Blosslom1/FDM_i3_3Dprinter/模型/主板盒/主板盒/README.txt

                   .:                     :,                                          
,:::::::: ::`      :::                   :::                                          
,:::::::: ::`      :::                   :::                                          
.,,:::,,, ::`.:,   ... .. .:,     .:. ..`... ..`   ..   .:,    .. ::  .::,     .:,`   
   ,::    :::::::  ::, :::::::  `:::::::.,:: :::  ::: .::::::  ::::: ::::::  .::::::  
   ,::    :::::::: ::, :::::::: ::::::::.,:: :::  ::: :::,:::, ::::: ::::::, :::::::: 
   ,::    :::  ::: ::, :::  :::`::.  :::.,::  ::,`::`:::   ::: :::  `::,`   :::   ::: 
   ,::    ::.  ::: ::, ::`  :::.::    ::.,::  :::::: ::::::::: ::`   :::::: ::::::::: 
   ,::    ::.  ::: ::, ::`  :::.::    ::.,::  .::::: ::::::::: ::`    ::::::::::::::: 
   ,::    ::.  ::: ::, ::`  ::: ::: `:::.,::   ::::  :::`  ,,, ::`  .::  :::.::.  ,,, 
   ,::    ::.  ::: ::, ::`  ::: ::::::::.,::   ::::   :::::::` ::`   ::::::: :::::::. 
   ,::    ::.  ::: ::, ::`  :::  :::::::`,::    ::.    :::::`  ::`   ::::::   :::::.  
                                ::,  ,::                               ``             
                                ::::::::                                              
                                 ::::::                                               
                                  `,,`

http://www.thingiverse.com/thing:761806
Dasaki Ramps 1.4 Enclosure / Box / Case by dasaki is licensed under the GNU - GPL license.
http://creativecommons.org/licenses/GPL/2.0/

# Summary

Compact enclosure for Ramps 1.4, with space for one or two 50mm fans, LCD connectors and hinged cover for easy access.  

After two years of having my Prusa electronics unboxed and untidy, I finally decided to design my own enclosure.  

Version v2: reinforced and increased space of cable holders.

22 nov 2016: added dasaki_ramps_enclosure_cover_v2_dual_40mm_fan.stl

If you are a curious maker / "tinker" / hacker, have a look at my blog:
www.therandomlab.com

Licensed under The TAPR Open Hardware License

# Instructions

Cut the hole/s for the fan/s after printing. Fans should blow outwards (extract the air from the enclosure).
There are holes for M3 nuts and bolts in two of the case sides, to fix it to the printer/device chassis.

Printing hints:  

To be printed in the position as in the source files (also shown in one of the pictures).  

0.3mm layer height  
0.6mm top/bottom thickness  
1.0mm shell thickness  
25% fill density
