Blosslom1/FDM_i3_3Dprinter/软件部分/3D Touch调平传感器使用说明书.pdf

### 3D Touch 调平培训

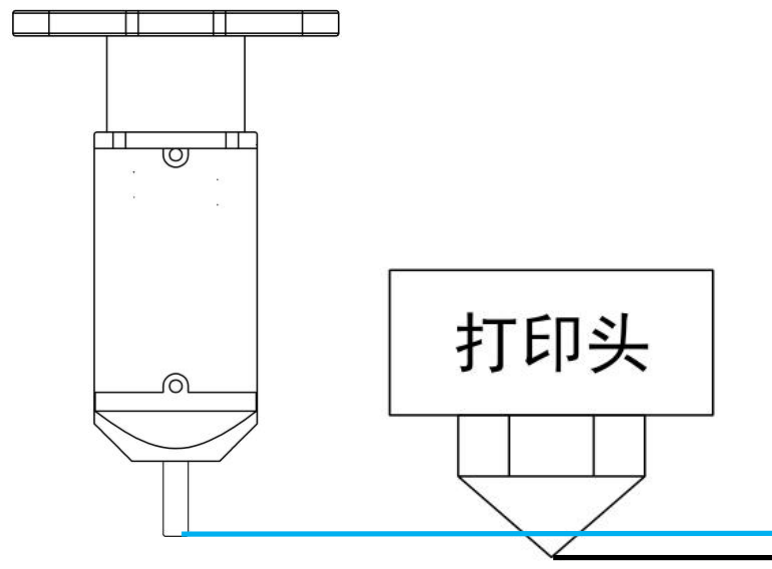
[picture p27: figure]
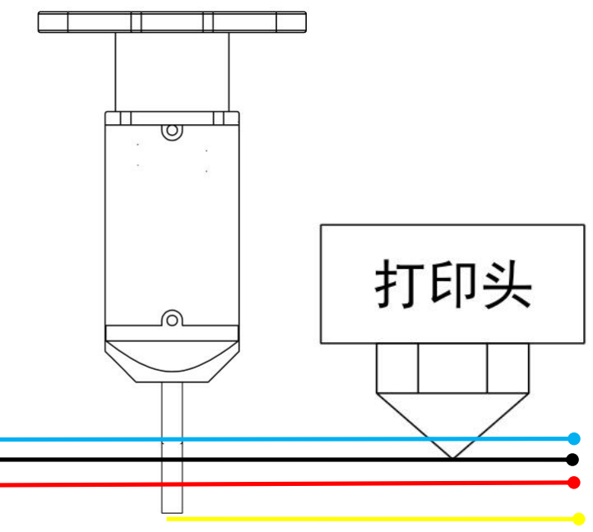
[picture p28: figure]

一.装机

缩针的时候 | 弹针的时候

代表 3d touch 缩针时，探针底部所处的位置，一定要比喷嘴要高。否则打印模型时，探针会碰到模

型，造成损坏。

代表喷嘴所处的位置

代表 3d touch 的触发点，这个触发点一定要比喷嘴要低，否则触发不了 3D touch，就已经被喷嘴顶

住了，这个可以微调调到适合的位置

代表 3d touch 弹针时，弹针底部所处的位置

黑线和红色之间的距离代表 Z offset 的值

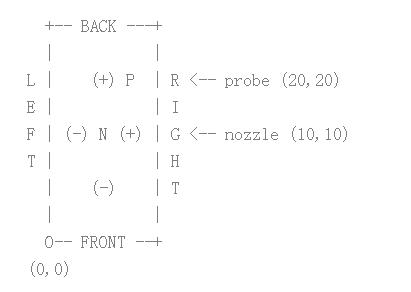
[picture p29: figure]
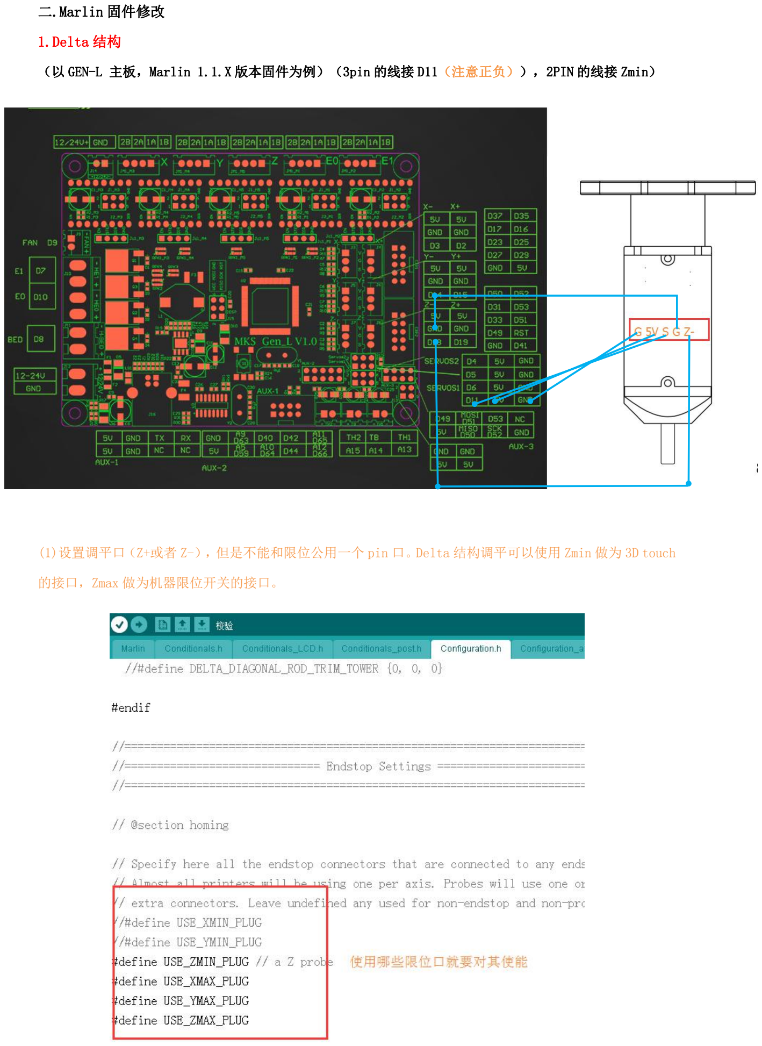
[picture p30: page 2]

二.Marlin 固件修改

1.Delta 结构

（以 GEN-L 主板，Marlin 1.1.X 版本固件为例）（3pin 的线接 D11（注意正负）），2PIN 的线接 Zmin）

(1)设置调平口（Z+或者 Z-），但是不能和限位公用一个 pin 口。Delta 结构调平可以使用 Zmin 做为 3D touch

的接口，Zmax 做为机器限位开关的接口。

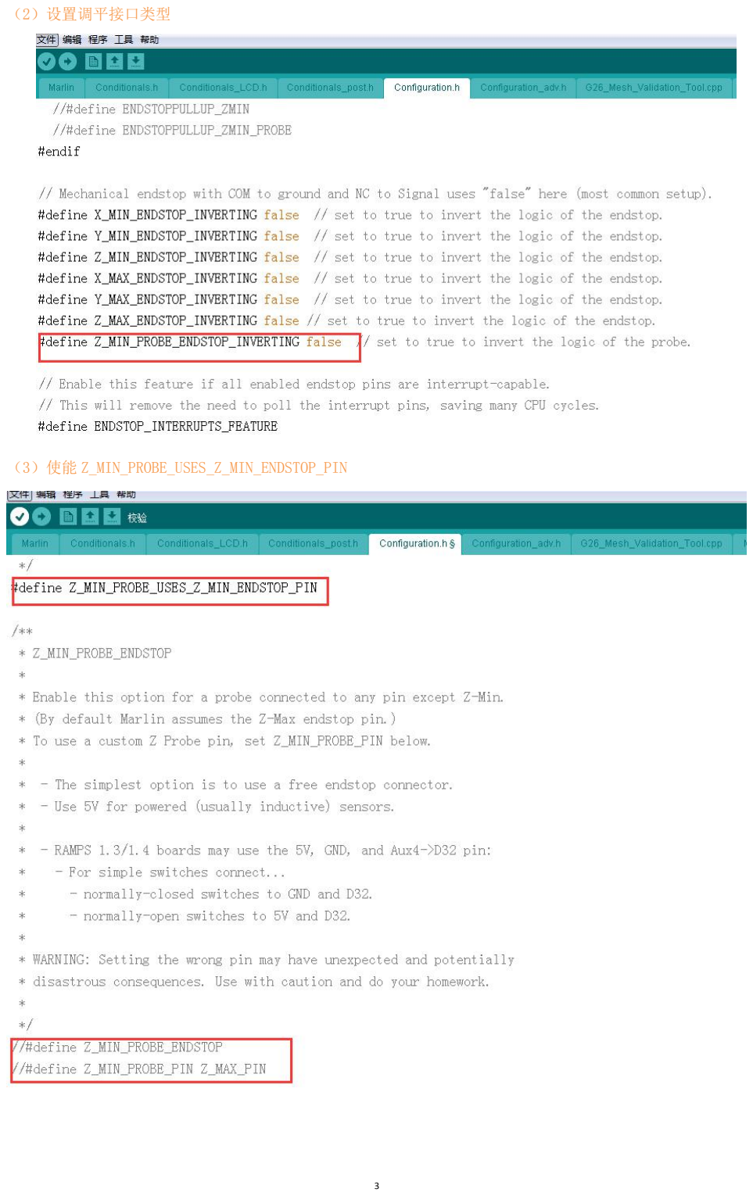
[picture p31: page 3]

（2）设置调平接口类型

（3）使能 Z_MIN_PROBE_USES_Z_MIN_ENDSTOP_PIN

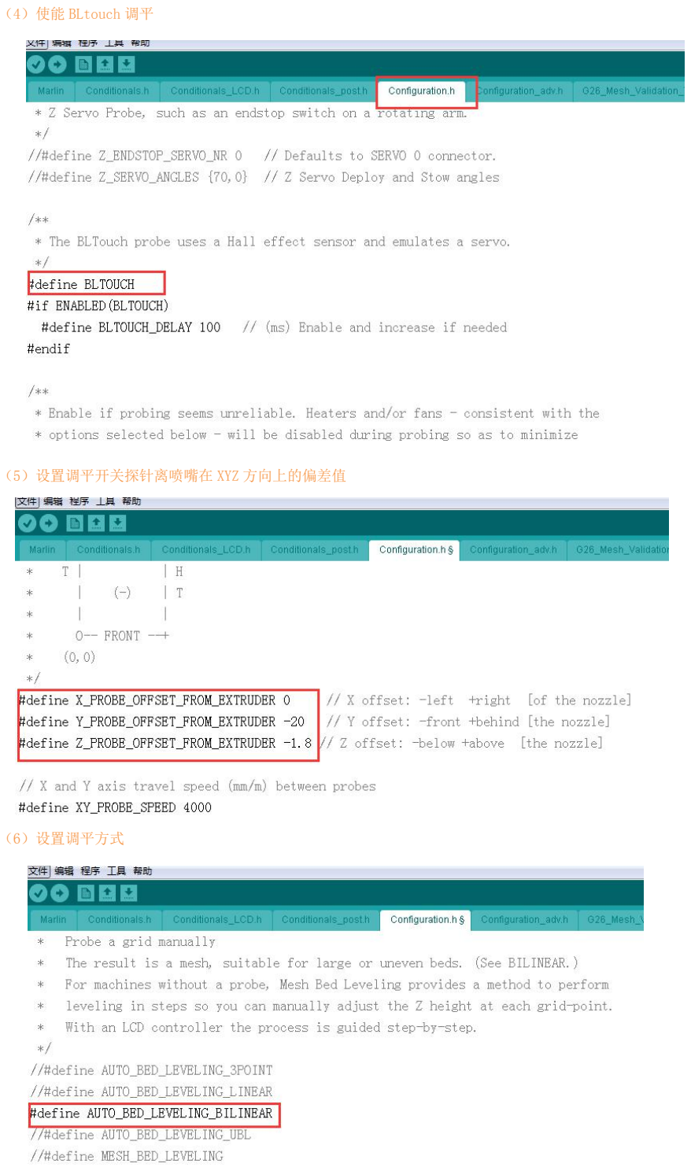
[picture p32: page 4]

（4）使能 BLtouch 调平

（5）设置调平开关探针离喷嘴在 XYZ 方向上的偏差值

（6）设置调平方式

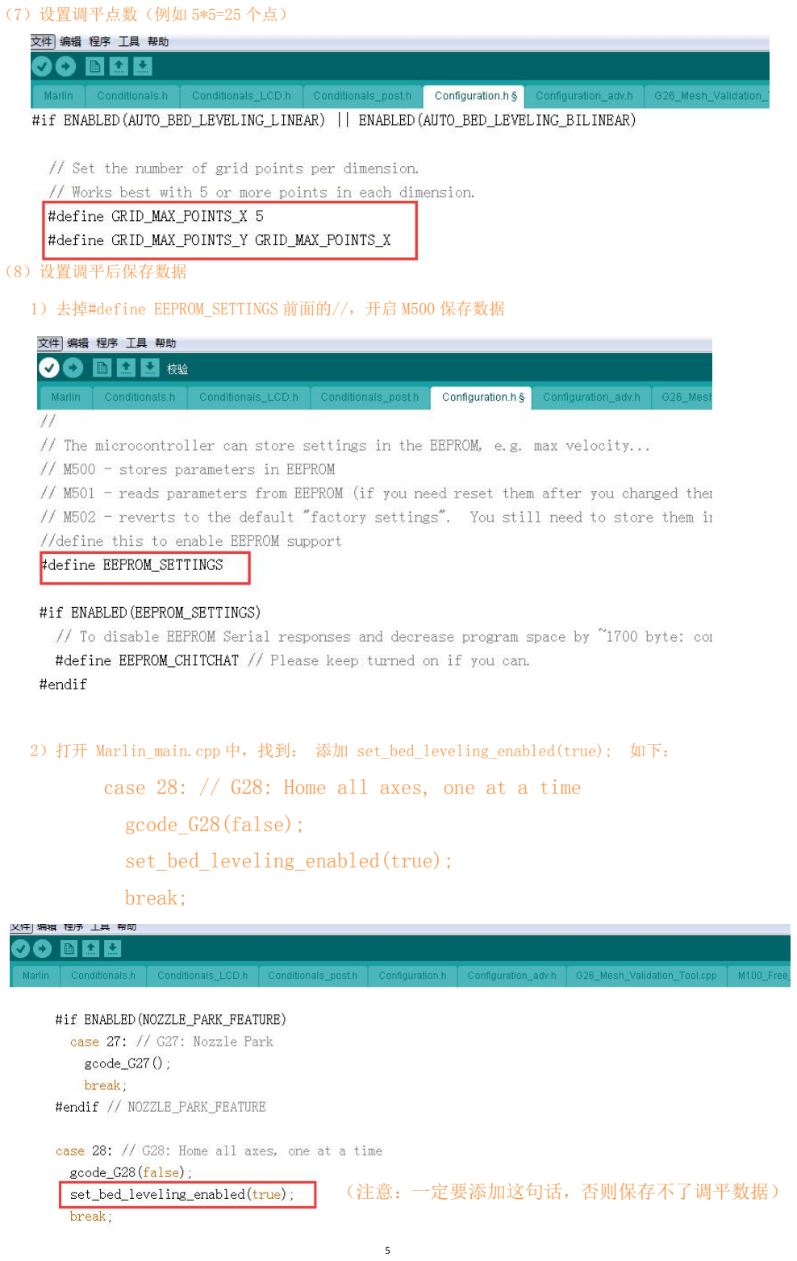
[picture p33: page 5]

（7）设置调平点数（例如 5*5=25 个点）

（8）设置调平后保存数据

1）去掉#define EEPROM_SETTINGS 前面的//，开启 M500 保存数据

2）打开 Marlin_main.cpp 中，找到： 添加 set_bed_leveling_enabled(true); 如下：

### case 28: // G28: Home all axes, one at a time

gcode_G28(false);
set_bed_leveling_enabled(true);
break;

（注意：一定要添加这句话，否则保存不了调平数据）

（9）去掉#define NUM_SERVOS 3 前面的//

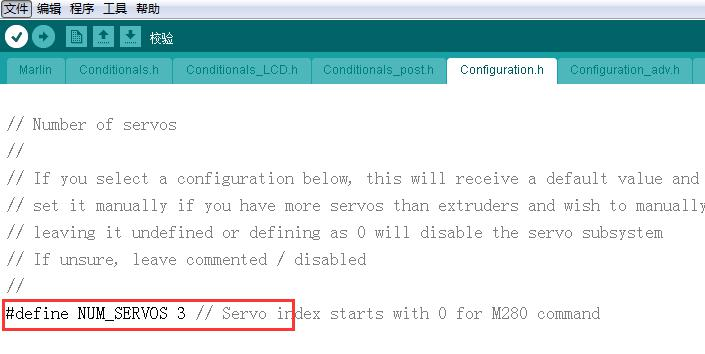
[picture p34: figure]
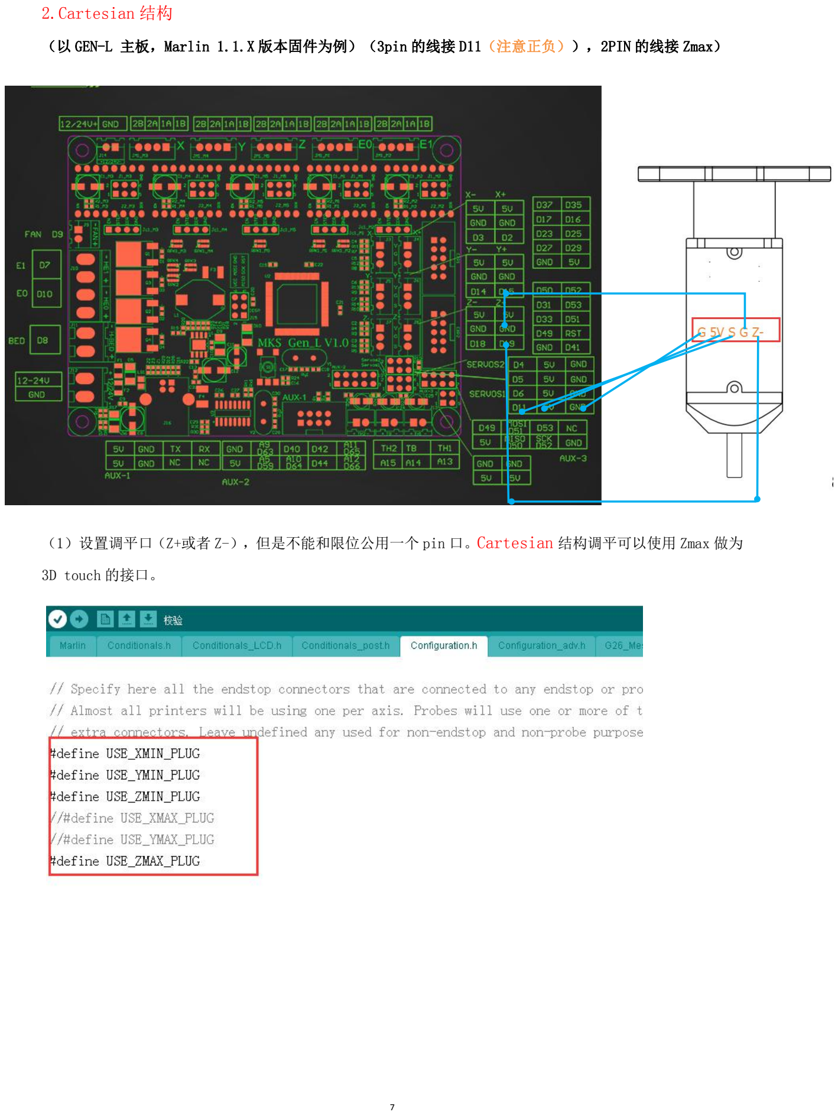
[picture p35: page 7]

2.Cartesian 结构

（以 GEN-L 主板，Marlin 1.1.X 版本固件为例）（3pin 的线接 D11（注意正负）），2PIN 的线接 Zmax）

（1）设置调平口（Z+或者 Z-），但是不能和限位公用一个 pin 口。Cartesian 结构调平可以使用 Zmax 做为

3D touch 的接口。

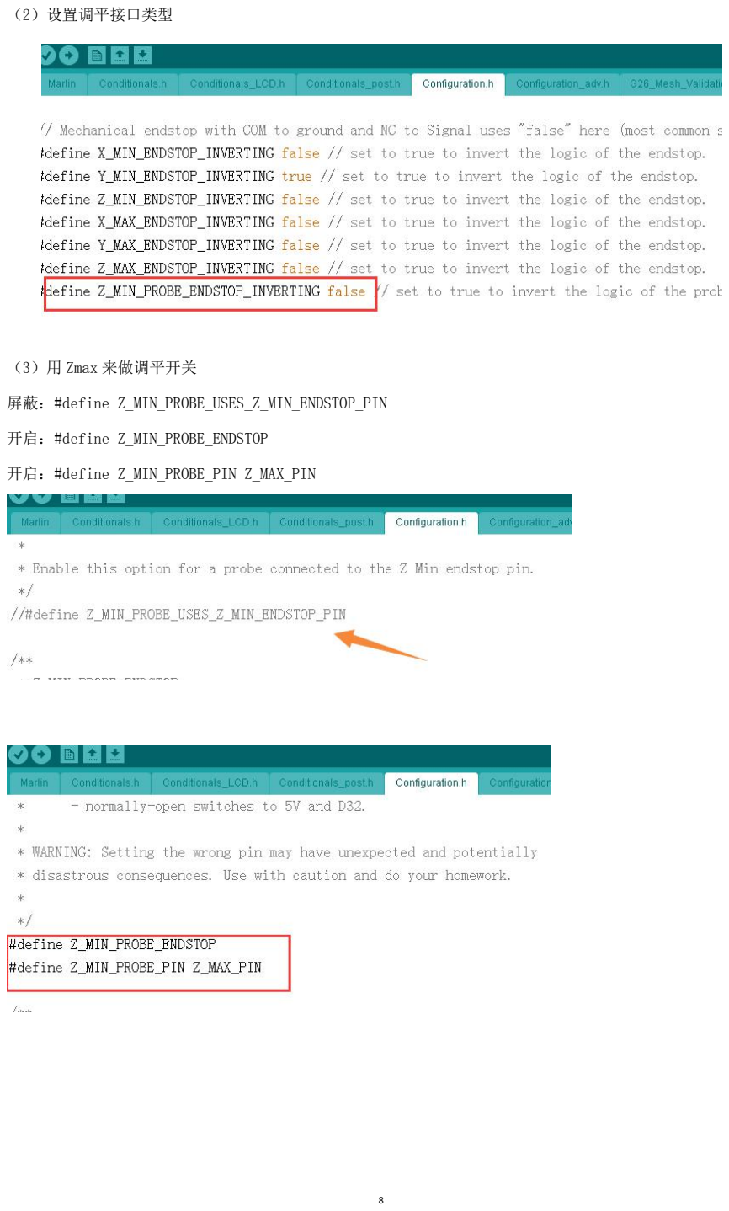
[picture p36: page 8]

（2）设置调平接口类型

（3）用 Zmax 来做调平开关

屏蔽：#define Z_MIN_PROBE_USES_Z_MIN_ENDSTOP_PIN

开启：#define Z_MIN_PROBE_ENDSTOP

开启：#define Z_MIN_PROBE_PIN Z_MAX_PIN

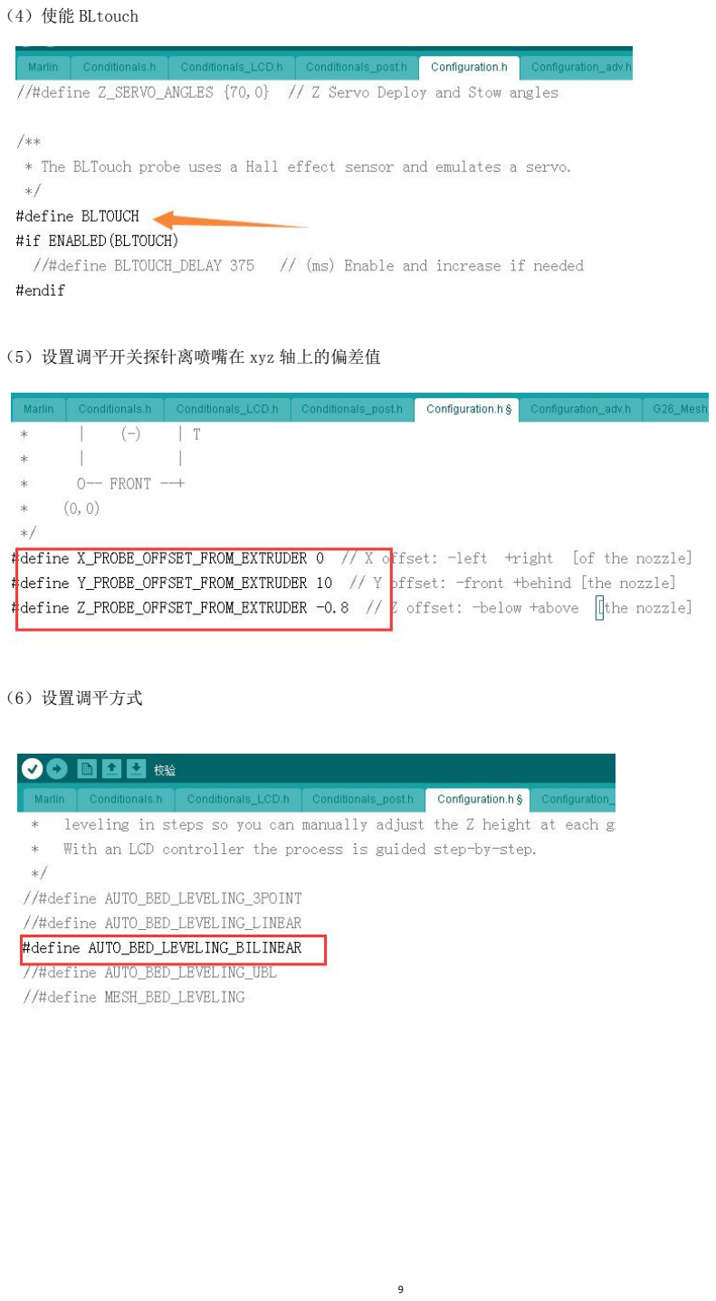
[picture p37: page 9]

（4）使能 BLtouch

（5）设置调平开关探针离喷嘴在 xyz 轴上的偏差值

（6）设置调平方式

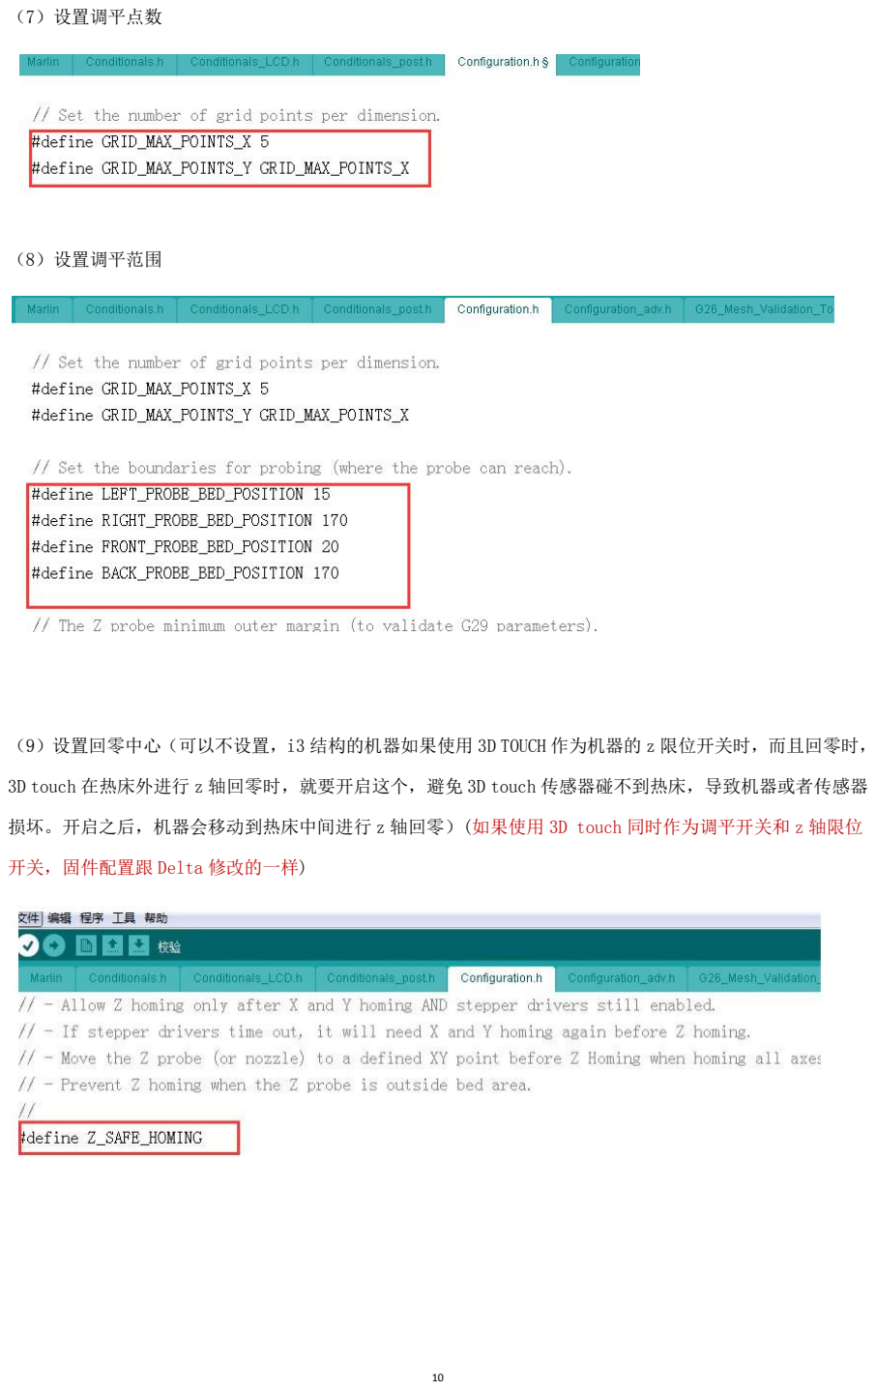
[picture p38: page 10]

（7）设置调平点数

（8）设置调平范围

（9）设置回零中心（可以不设置，i3 结构的机器如果使用 3D TOUCH 作为机器的 z 限位开关时，而且回零时，

3D touch 在热床外进行 z 轴回零时，就要开启这个，避免 3D touch 传感器碰不到热床，导致机器或者传感器

损坏。开启之后，机器会移动到热床中间进行 z 轴回零）(如果使用 3D touch 同时作为调平开关和 z 轴限位

开关，固件配置跟 Delta 修改的一样)

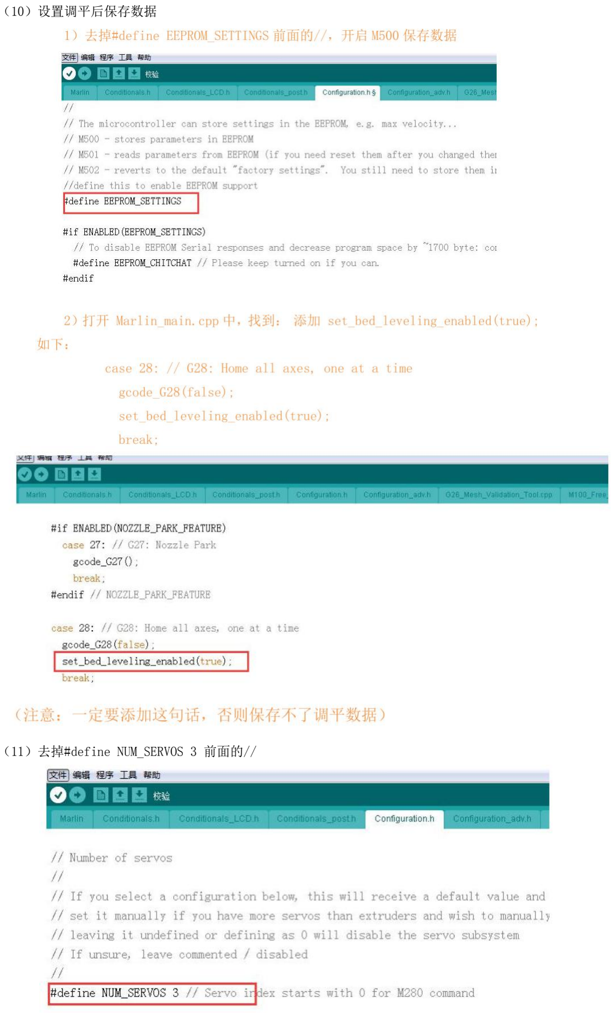
[picture p39: page 11]

（10）设置调平后保存数据

（11）去掉#define NUM_SERVOS 3 前面的//

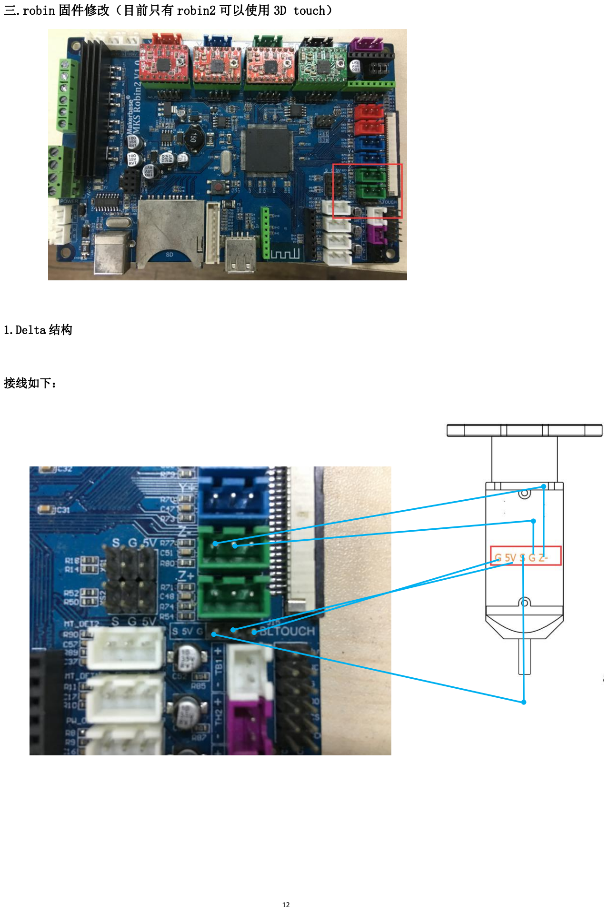
[picture p40: page 12]

三.robin 固件修改（目前只有 robin2 可以使用 3D touch）

1.Delta 结构

接线如下：

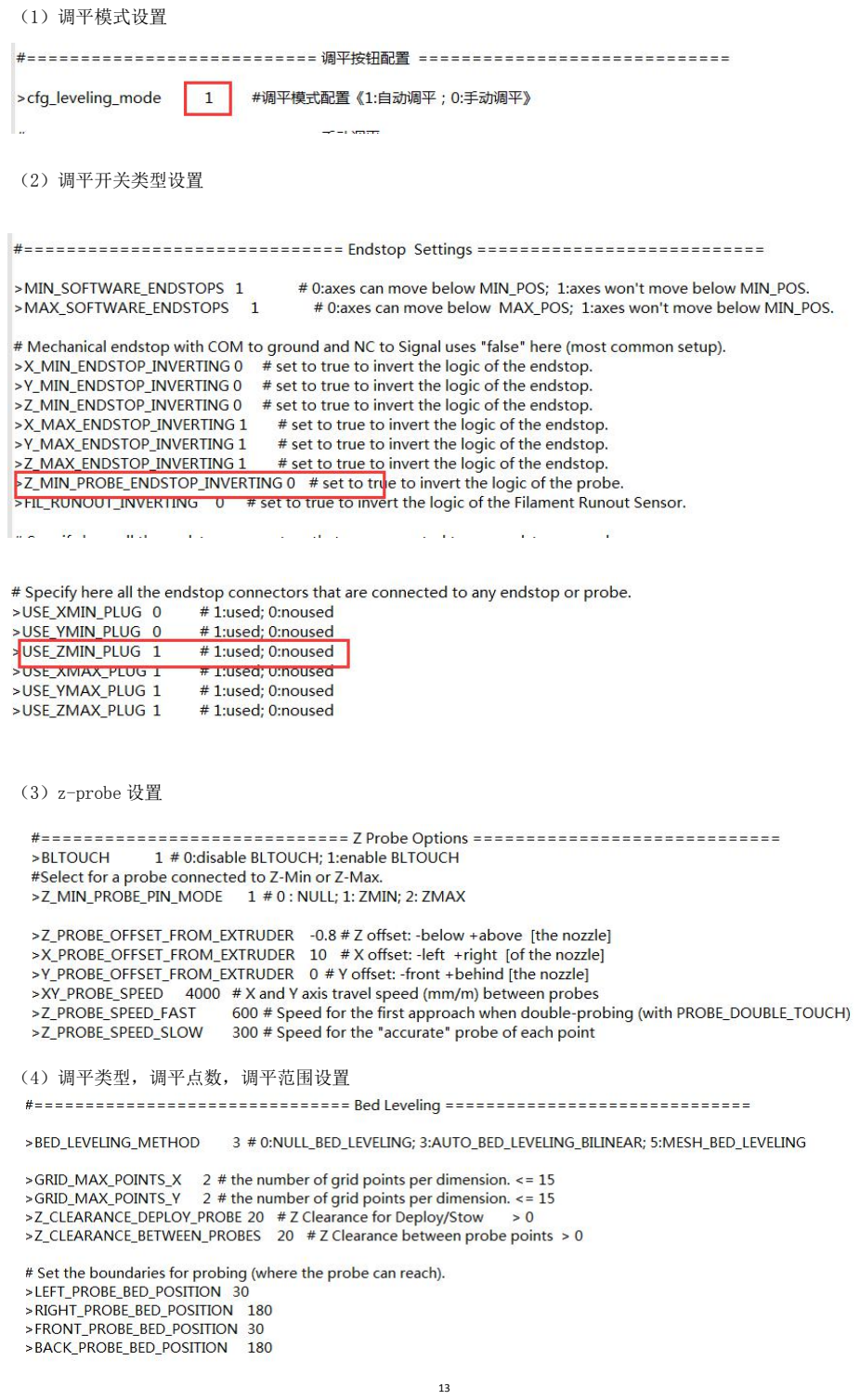
[picture p41: page 13]

（1）调平模式设置

（2）调平开关类型设置

（3）z-probe 设置

（4）调平类型，调平点数，调平范围设置

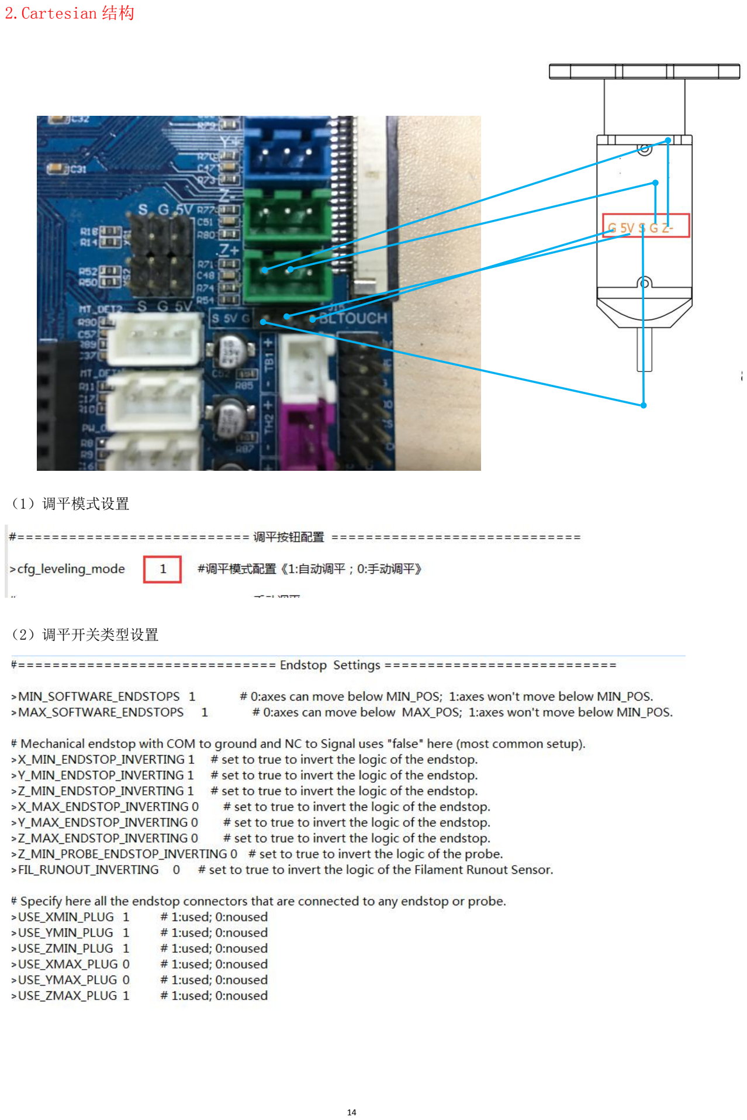
[picture p42: page 14]

2.Cartesian 结构

（1）调平模式设置

（2）调平开关类型设置

（5）z-probe 设置

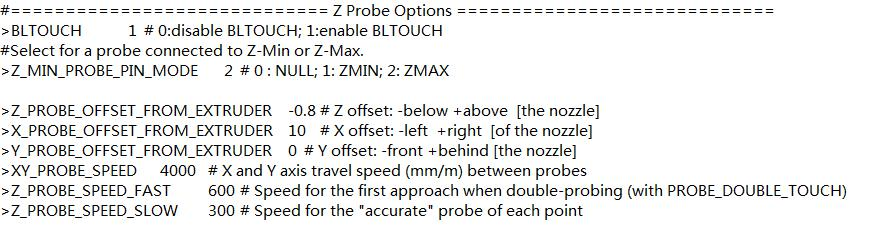
[picture p43: figure]

（6）调平类型，调平点数，调平范围设置

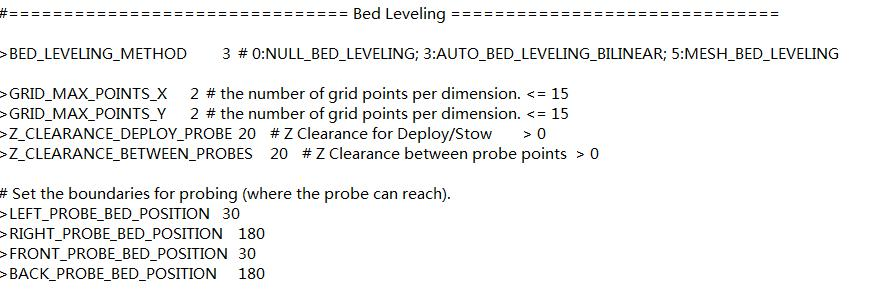
[picture p44: figure]
