Blosslom1/FDM_i3_3Dprinter/方案一/3D打印机项目.md

# 3D打印机项目

## 打印机类型

熔融沉积型打印机（FDM）

## 设计建模

建模软件使用的是solid works 2018，用二维图形生成三维图形。

### 支架型材

#### x轴铝型材

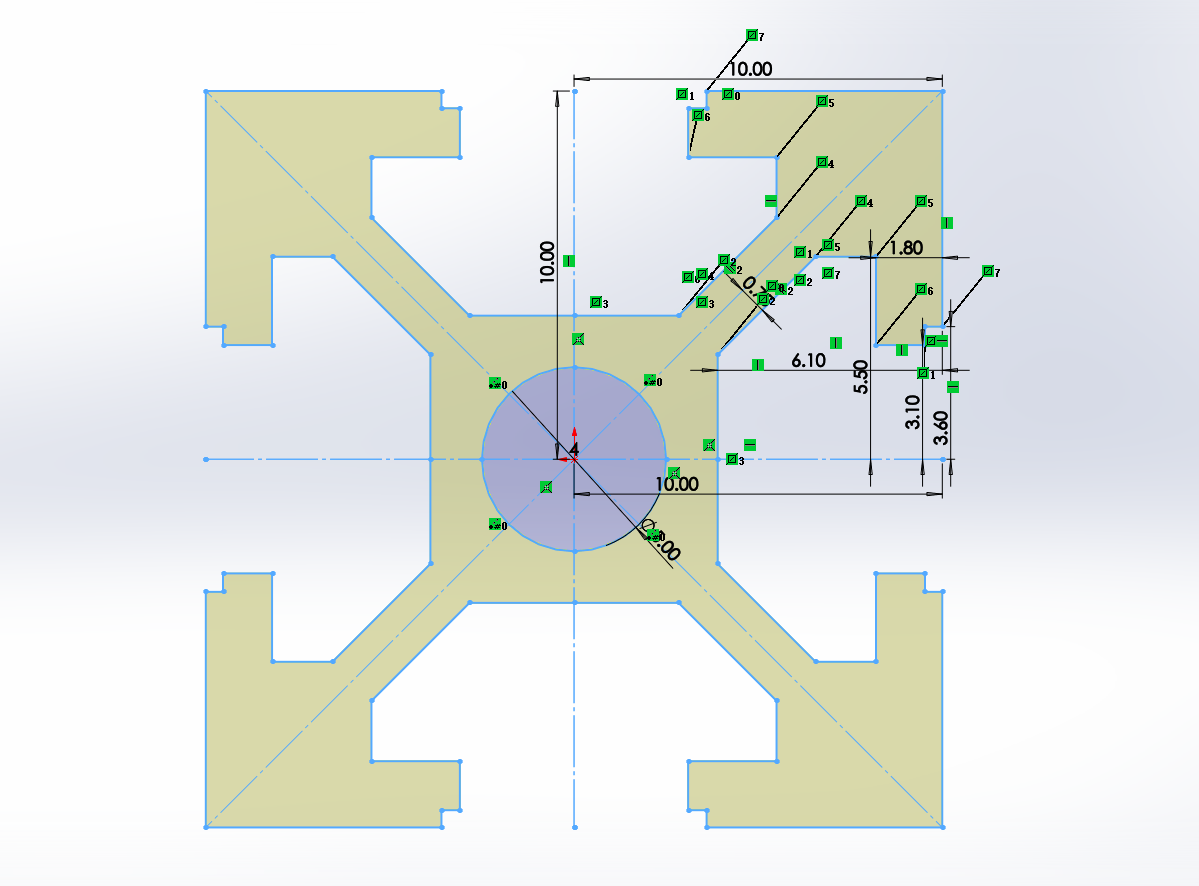
[picture p45: 方案一/图片/X型材.png]


规格如图（规格全部参考模型源文件，项目地址），使用拉伸凸台生成立体零件，拉伸长度是245mm

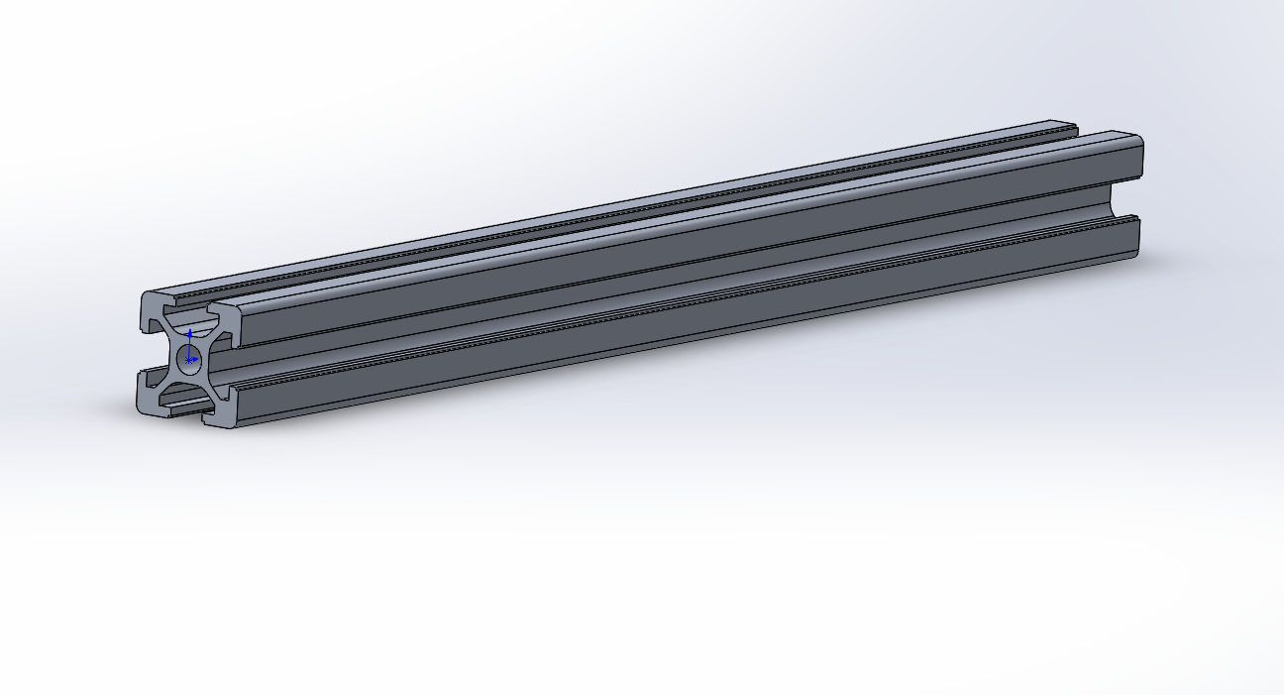
[picture p46: 方案一/图片/X型材245.png]


#### y轴铝型材

同x轴型材，拉伸长度是385mm

#### z轴铝型材

同x轴型材，拉伸长度是310mm

#### x光轴

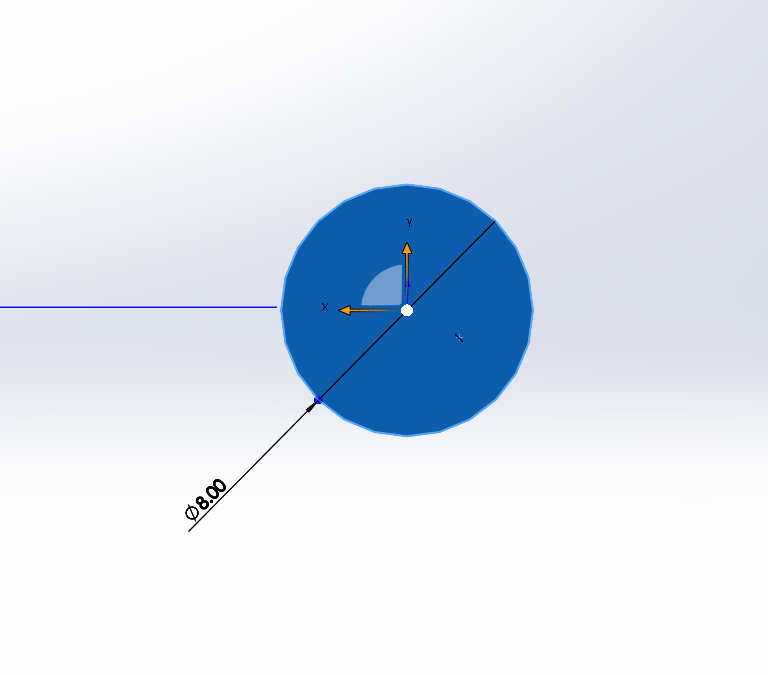
[picture p47: 方案一/图片/X光轴.png]


规格如图，使用拉伸凸台生成立体零件，拉伸长度是320mm

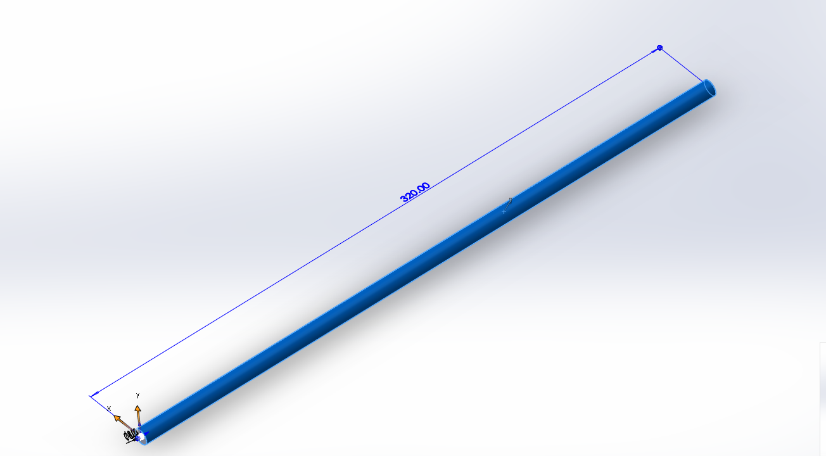
[picture p48: 方案一/图片/X光轴320.png]


#### y光轴

同x光轴，拉伸长度是380mm

#### z光轴

同x光轴，拉伸长度是345mm

#### z丝杆

长度305mm

#### 热床平台

下图为热床草图，厚度是3mm

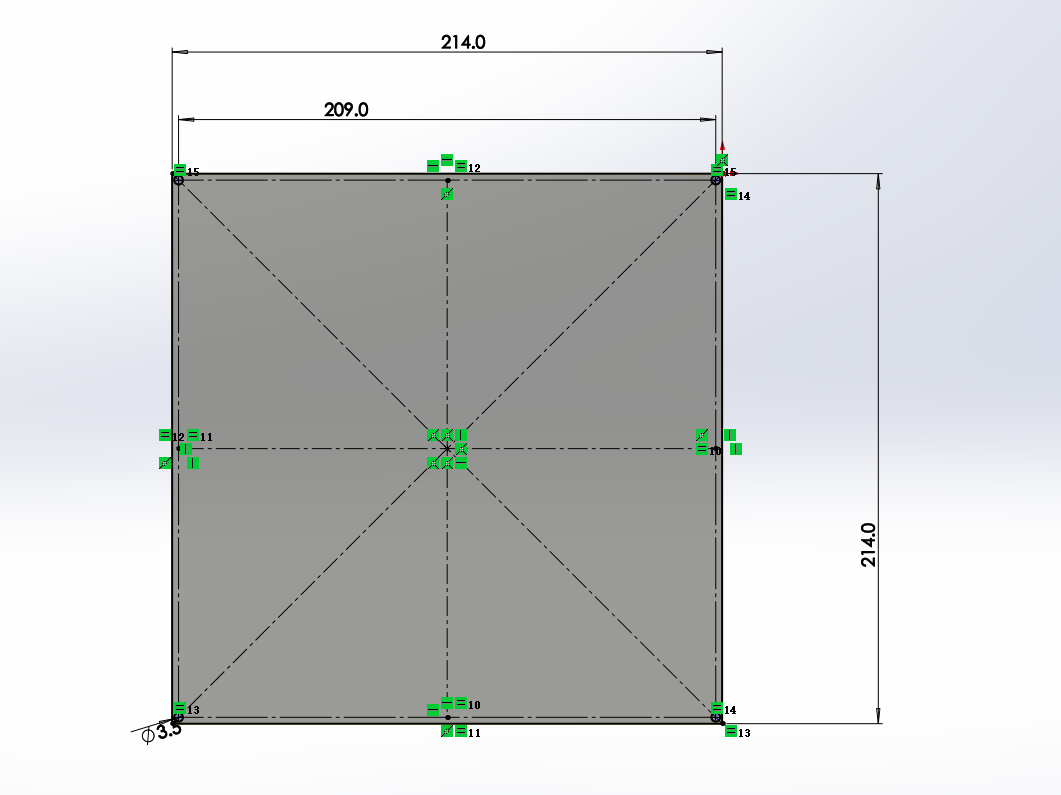
[picture p49: 方案一/图片/热床.png]


下图为热床地板草图，厚度是2.5mm

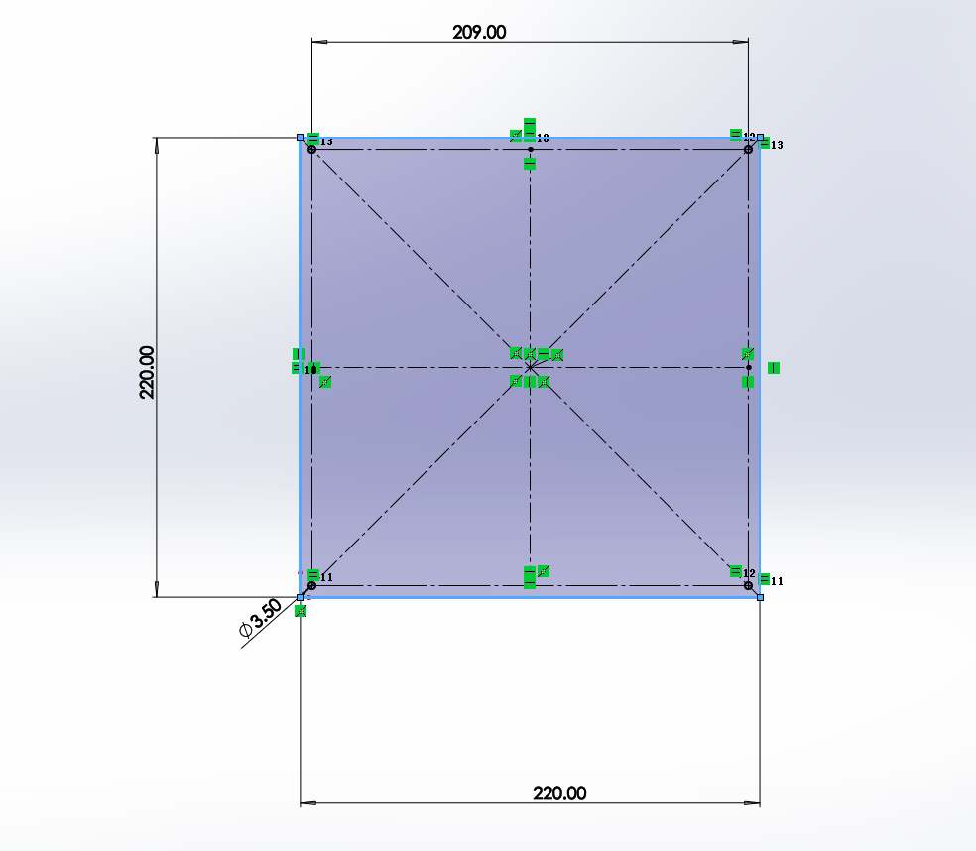
[picture p50: 方案一/图片/热床地板.png]


#### 角码

角码中间位置，L型型材，拉伸长度是20mm

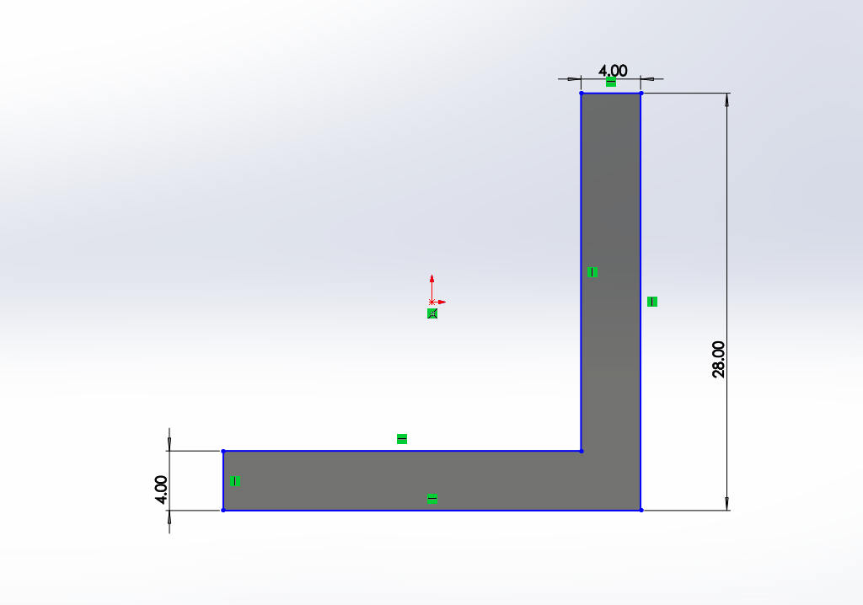
[picture p51: 方案一/图片/角码中.png]


角码侧边位置如图尺寸，两边通过镜像建立，拉伸长度是3.5mm

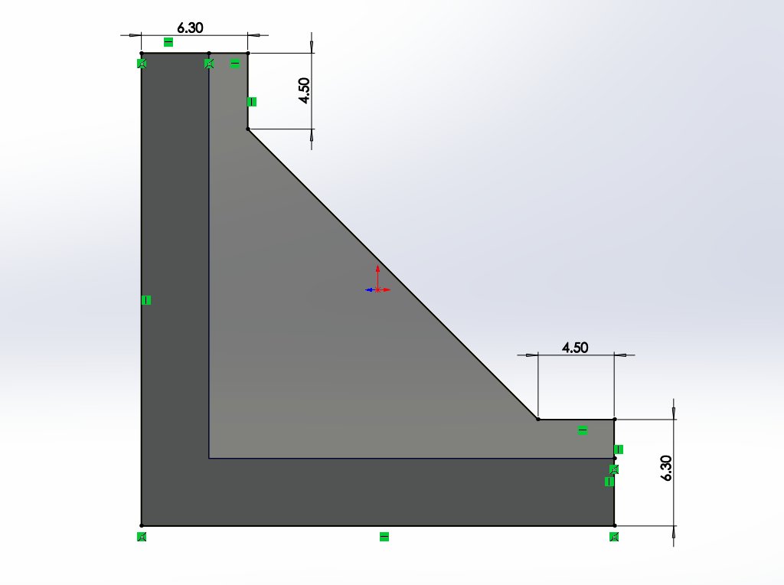
[picture p52: 方案一/图片/角码侧.png]


角码底和后面是一样的，拉伸切除，草图如下

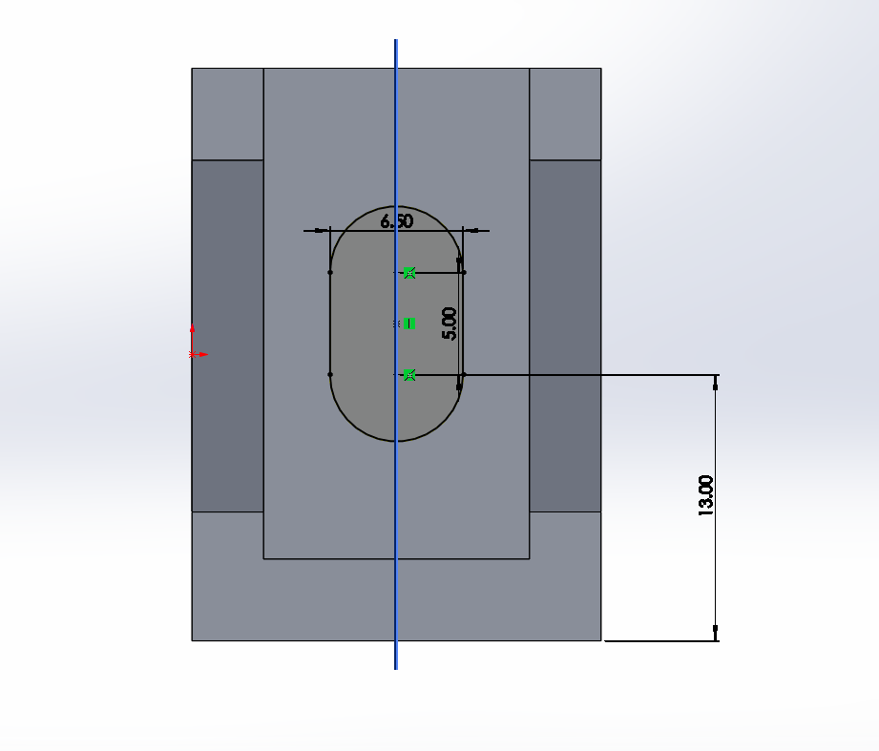
[picture p53: 方案一/图片/角码底.png]


整体图如下：

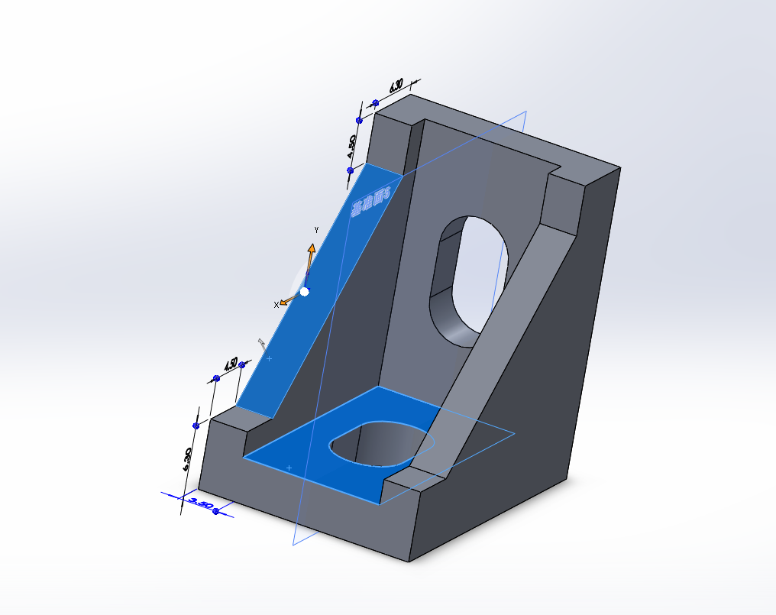
[picture p54: 方案一/图片/角码整.png]


#### 联轴器

联轴器是由一个圆柱体组成，中空，阶梯规格，草图如下，拉伸25mm

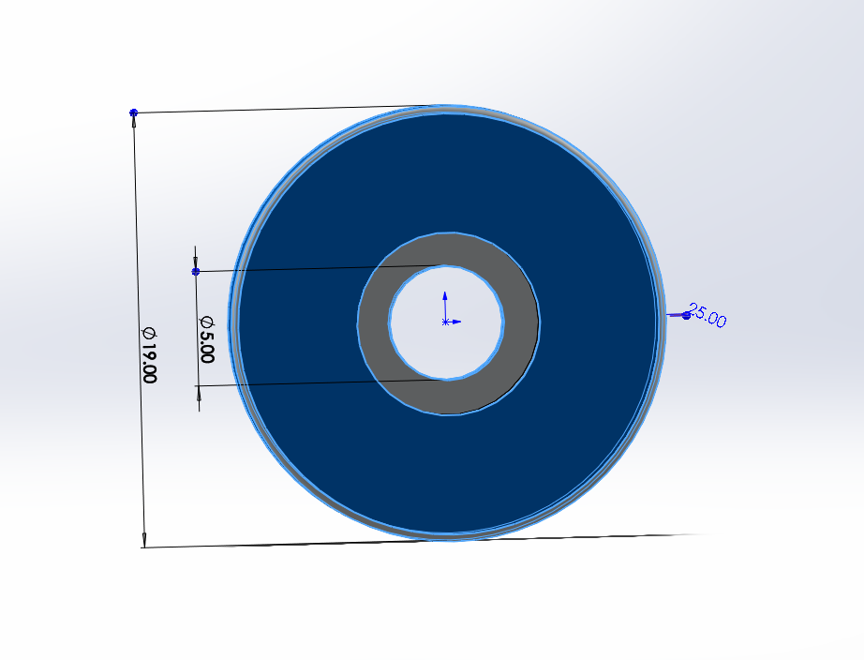
[picture p55: 方案一/图片/联轴器1.png]


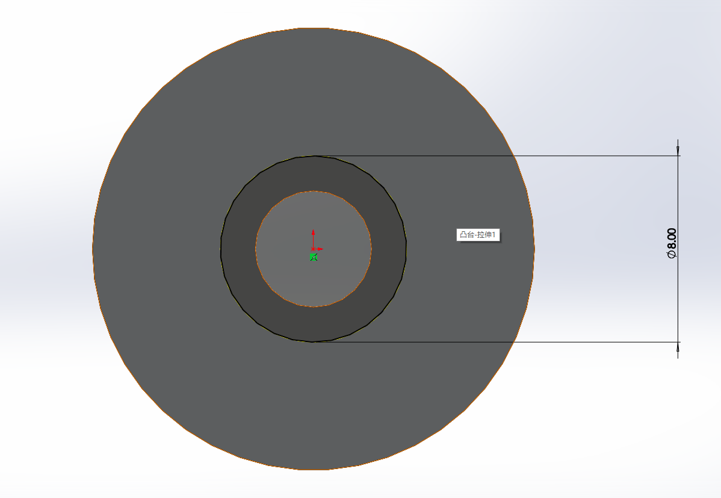
[picture p56: 方案一/图片/联轴器2.png]


整体如下图：

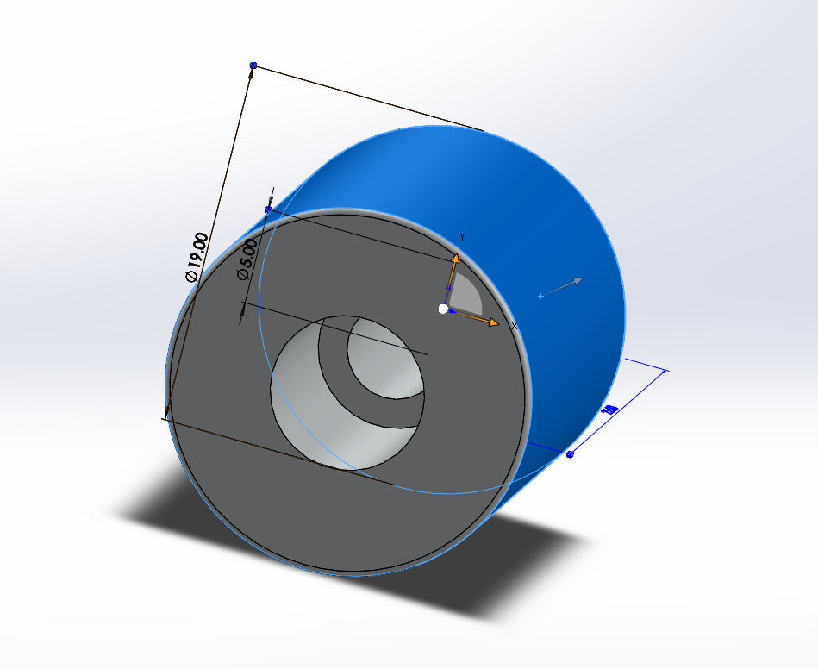
[picture p57: 方案一/图片/联轴器3.png]


#### 同步轮

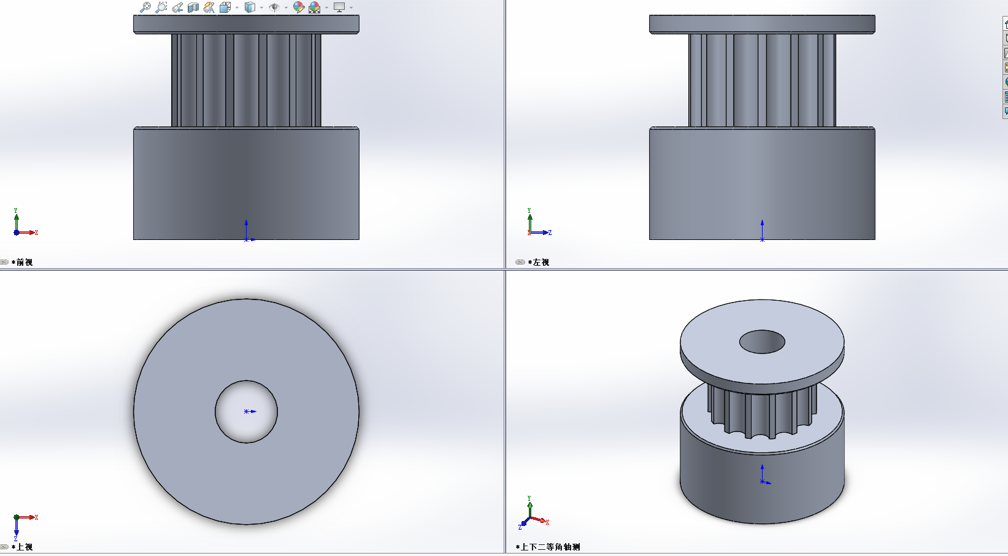
[picture p58: 方案一/图片/同步轮.png]


#### LM8UU

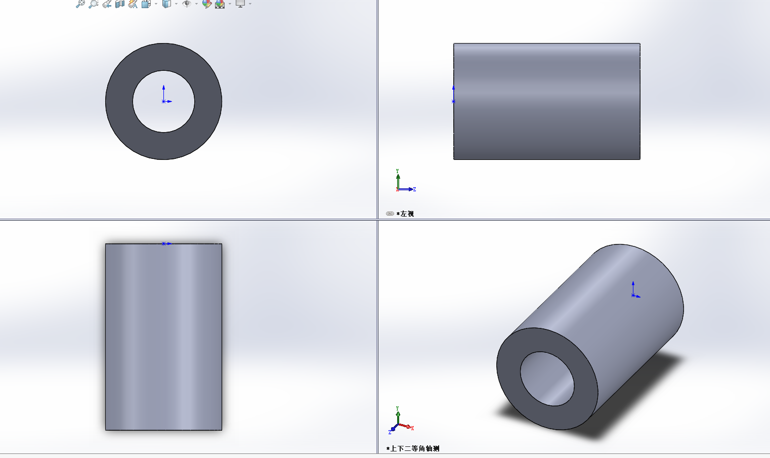
[picture p59: 方案一/图片/LM8UU.png]


#### 丝杆螺母

丝杆螺母，参考图。

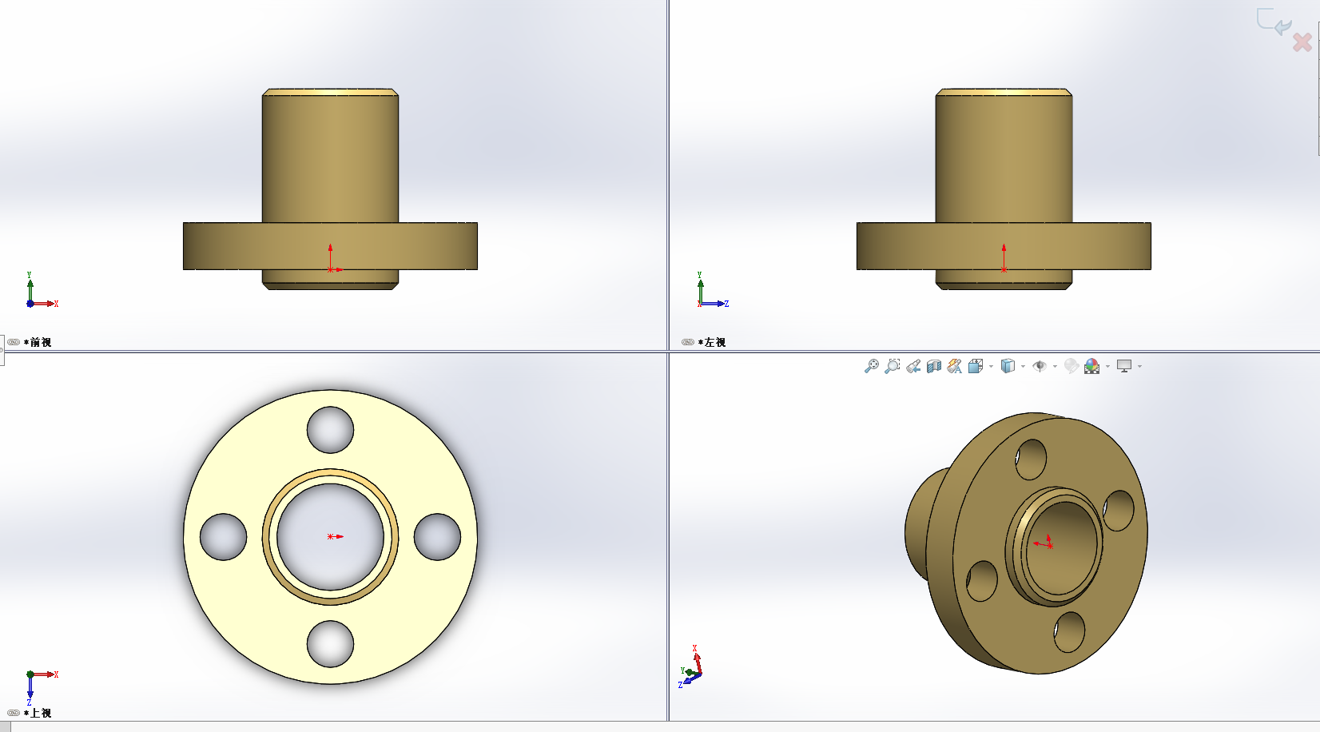
[picture p60: 方案一/图片/丝杆螺母.png]


#### 42步进电机

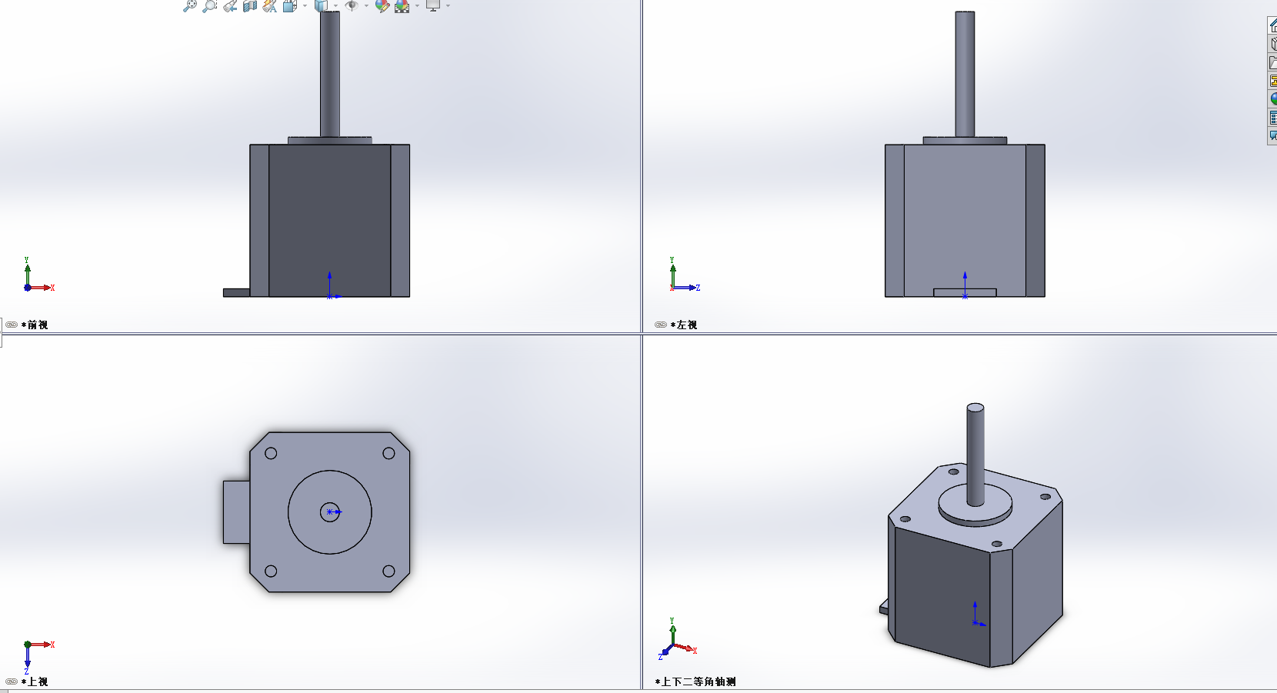
[picture p61: 方案一/图片/42步进电机.png]


#### 挤出机

下图是MK8底板。

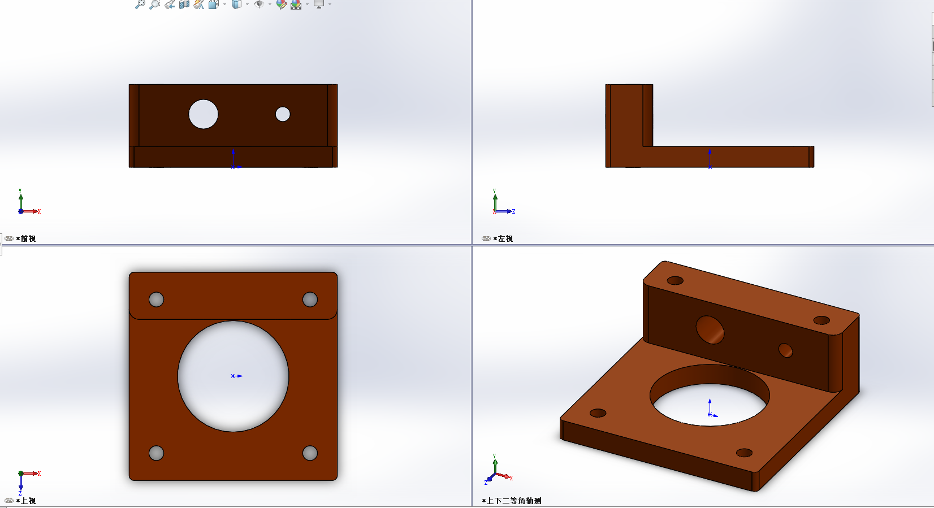
[picture p62: 方案一/图片/挤出机1.png]


下图是MK8压杆

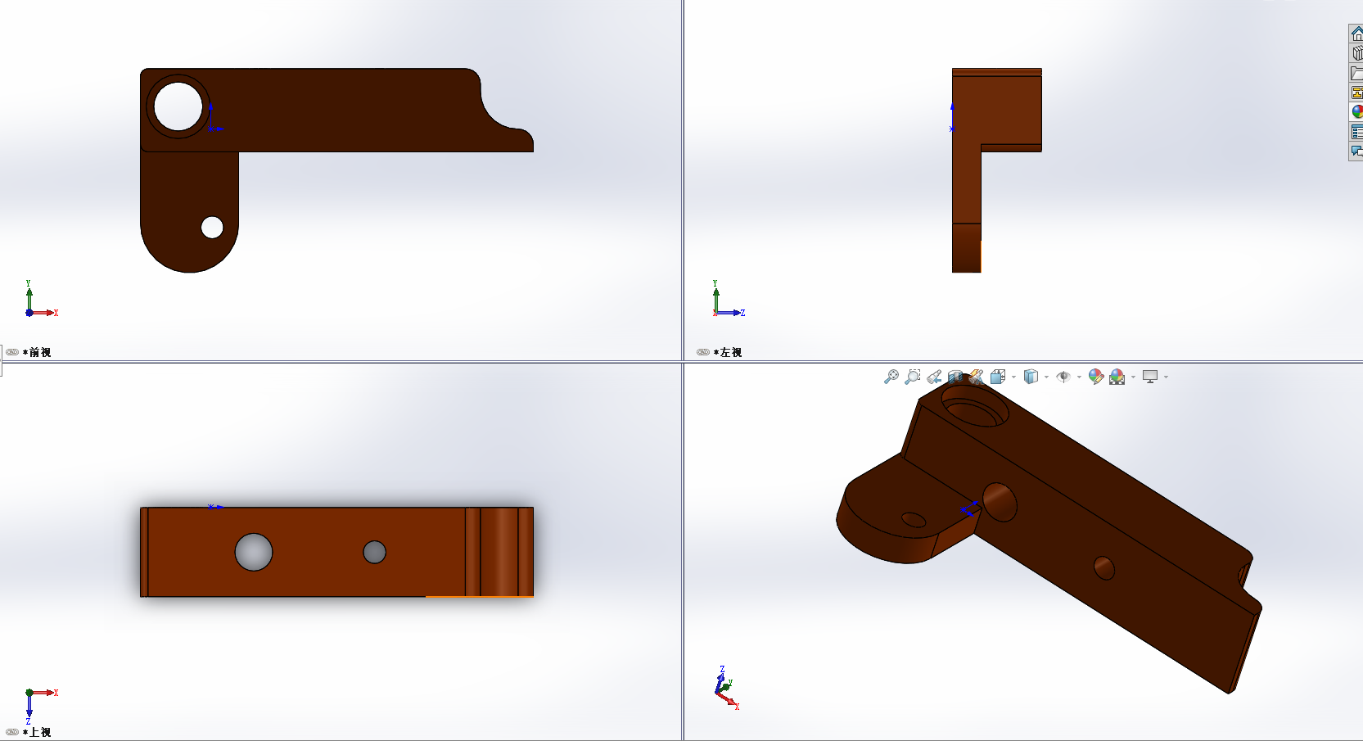
[picture p63: 方案一/图片/MK8压杆.png]


下图是MK8散热片

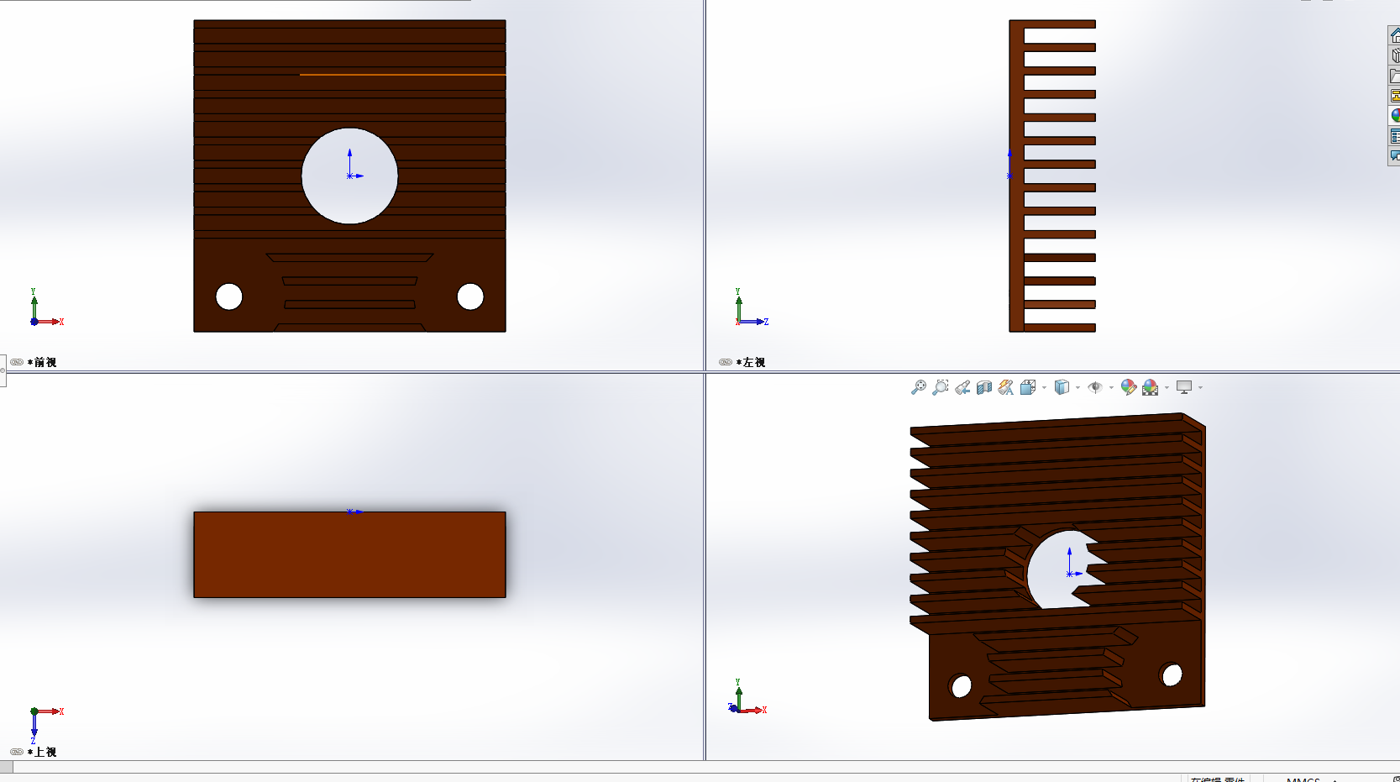
[picture p64: 方案一/图片/MK8散热片.png]


#### 喉管

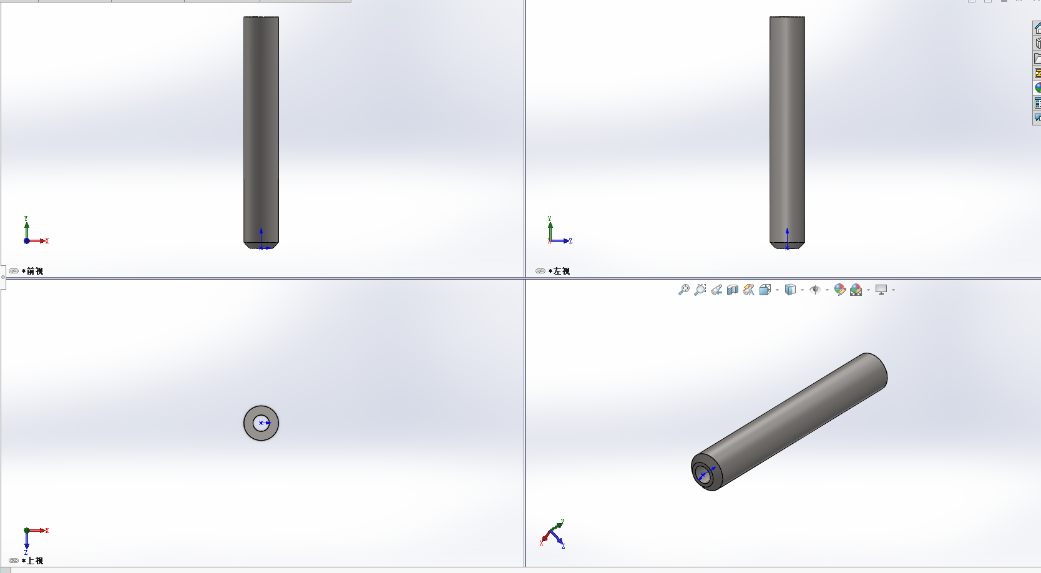
[picture p65: 方案一/图片/喉管.png]


#### 喉管散热片

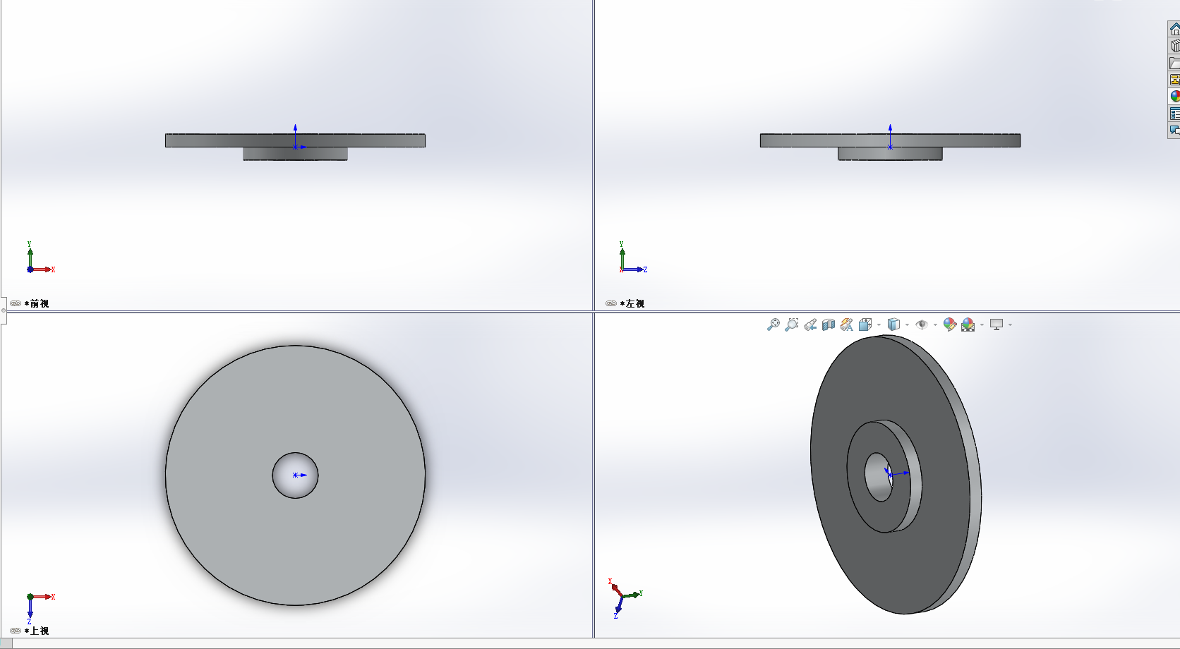
[picture p66: 方案一/图片/喉管散热片.png]


#### 固定

下图是Y光轴固定

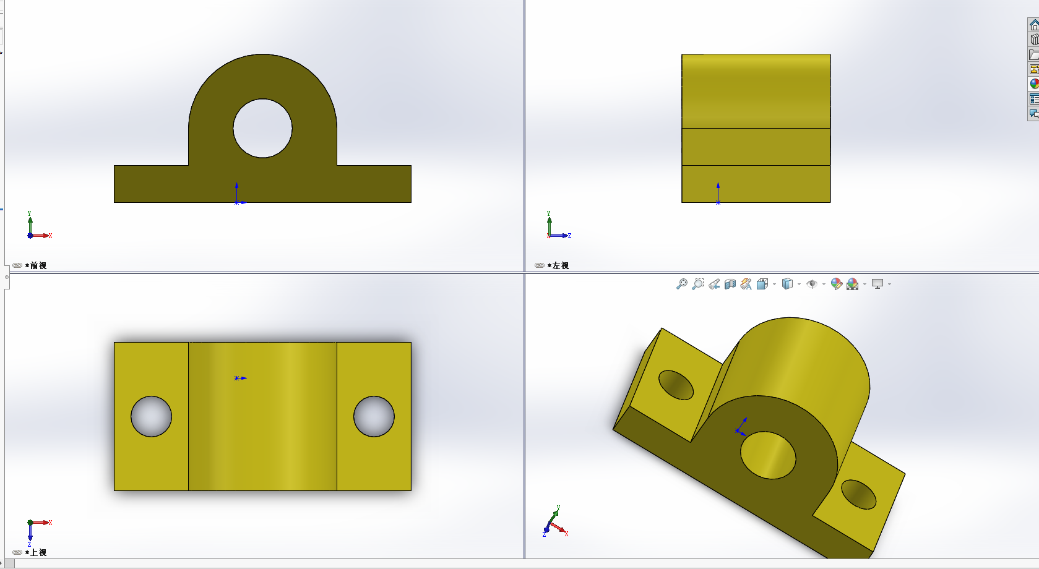
[picture p67: 方案一/图片/Y光轴固定.png]


下图是热床底板固定

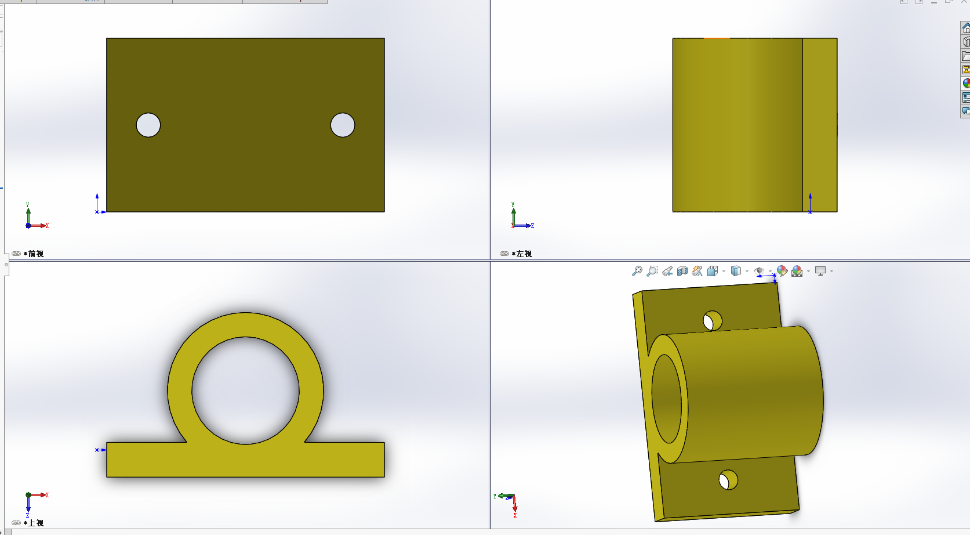
[picture p68: 方案一/图片/热床底板固定.png]


#### 铝加热块

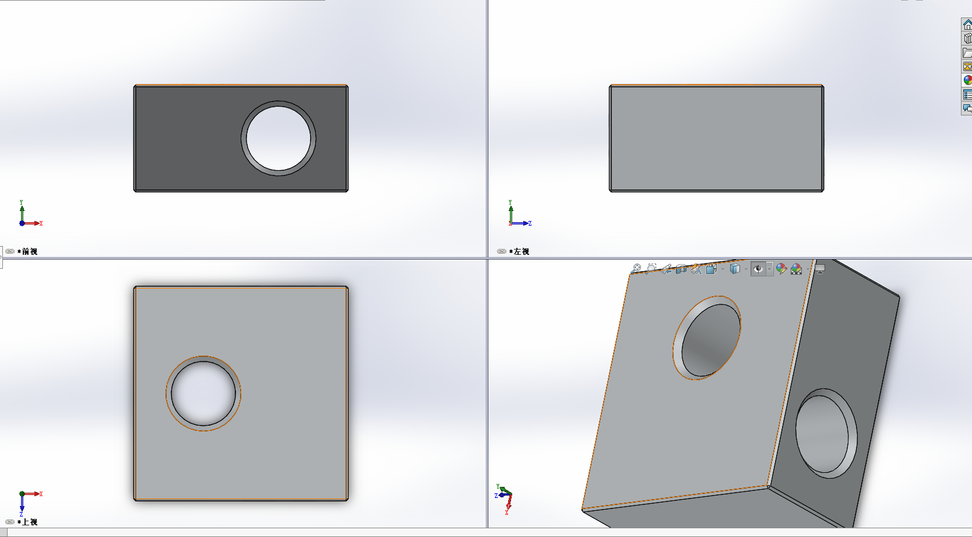
[picture p69: 方案一/图片/铝加热块.png]


#### 喷口

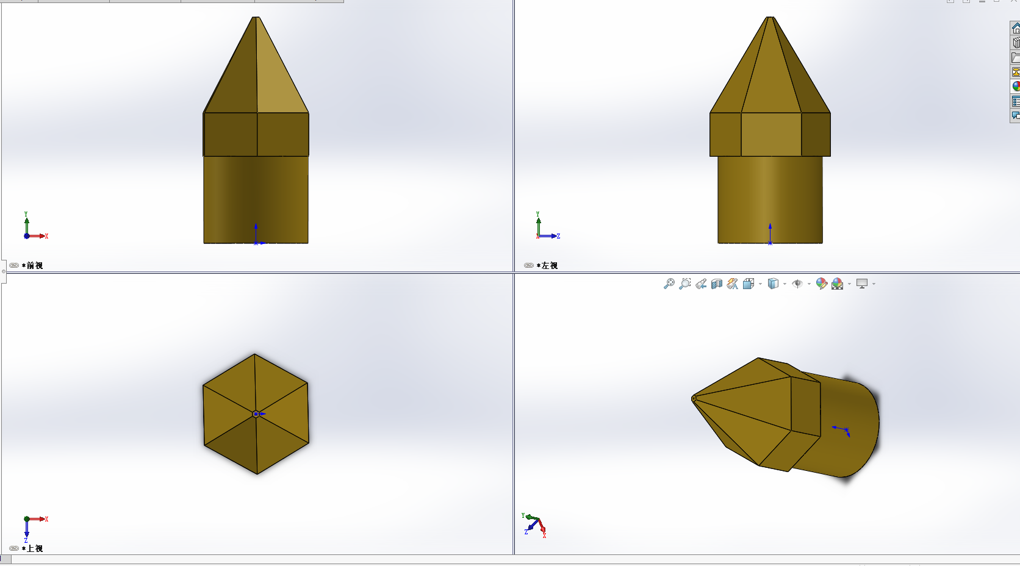
[picture p70: 方案一/图片/喷口.png]


### 零件总装

使用装配界面将上面设计好的零件进行装配。

需要零件有X型材2个，角码4个，横梁型材1个，热床平台1个，光轴380两个，光轴固定4个，热床底板固定4个，LM8UU4个。下列是他们的几何位置关系。

{% hideBlock 查看几何位置关系 %} 

重合2X型材(1),Y型材(1)

重合5X型材(1),Y型材(1)

重合6X型材(1) ,Y型材(1)

重合8X型材(1),角码(1)

重合9Y型材(1),角码(1)

重合10X型材(1),角码(1)

重合15X型材(1) ,Y型材(2)

重合21X型材(1),Y型材(2)

重合22X型材(1),Y型材(2)

人重合24Y型材(2),角码(2)

重合25X型材(1),角码(2)

重合26Y型材(2) ,角码(2)

重合27角码(1),角码(2=

重合30Y型材(1),X型材(2)

重合31Y型材(1),X型材(2)

重合32Y型材(1),X型材(2)

重合33角码(4),X型材(2)

重合34Y型材(1),角码(4)

重合35Y型材(1),角码(4)

重合36角码(3) ,X型材(2)

重合37Y型材(2),角码(3)

重合38V型材(2),角码(3)

重合39Y型材(1),Z型材(1)

重合40Y型材(1),7型材(1)

重合43V型材(2),Z型材(2)

重合44Y型材(2),Z型材(2)

重合47Z型材(1),Z型材(2)

重合48Z型材(1),横梁型材(1)

重合49Z型材(1),横梁型材(1)

重合51Z型材(1),角码(5)

重合52横梁型材(1),角码(5)

重合53Z型材(1),角码(5)

重合55横梁型材(1),角码(6)

重合56Z型材(2),角码(6)

重合57Z型材(2),角码(6)

距离1横梁型材(1),Z型材(1)

重合58X型材(1),Y光轴固定(1)

重合59 X型材(1),Y光轴固定(1)

同心1Y光轴380(1),Y光轴固定(1)

重合62Y光轴380(1),Y光轴固定(1)

重合63X型材(1),Y光轴固定(2)

重合64X型材(1),Y光轴固定(2)

同心2Y光轴固定(2),Y光轴380(2)

重合66Y光轴固定(2),Y光轴380(2)

重合69 X型材(2),Y光轴固定(4)

重合70X型材(2),Y光轴固定(4)

同心3Y光轴380(2) ,Y光轴固定(4)

重合72X型材(2),Y光轴固定(5)

重合73X型材(2),Y光轴固定(5)

同心4Y光轴380(1),Y光轴固定(5)

同心5Y光轴380(2),LM8UU(3=

同心6Y光轴380(2),LM8UU(4)

同心7Y光轴380(1),LM8UU(2)

同心8Y光轴38O(1),LM8UU(1)

重合76 LM8UU(2),热床底板固定(1)

同心9LM8UU(2),热床底板固定(1)

重合77 LM8UU(4),热床底板固定(3)

同心10 LM8UU(4),热床底板固定(3)

重合78LM8UU(3) ,热床底板固定(4)

同心11 LM8UU(3),热床底板固定(4)

重合79 LM8UU(1),热床底板固定(5)

同心12LM8UU(1),热床底板固定(5)

同心15热床平台(1),热床底板固定(3)

同心16热床平台(1),热床底板固定(3)

同心17热床平台(1),热床底板固定(1)

同心18热床平台(1),热床底板固定(1)

同心19热床平台(1),热床底板固定(4)

同心20热床平台(1),热床底板固定(4)

重合82热床平台(1),热床底板固定(4)

同心21热床平台(1),热床底板固定(5)

同心22热床平台(1),热床底板固定(5)

重合83热床平台(1),热床底板固定(1)

{% endhideBlock %}

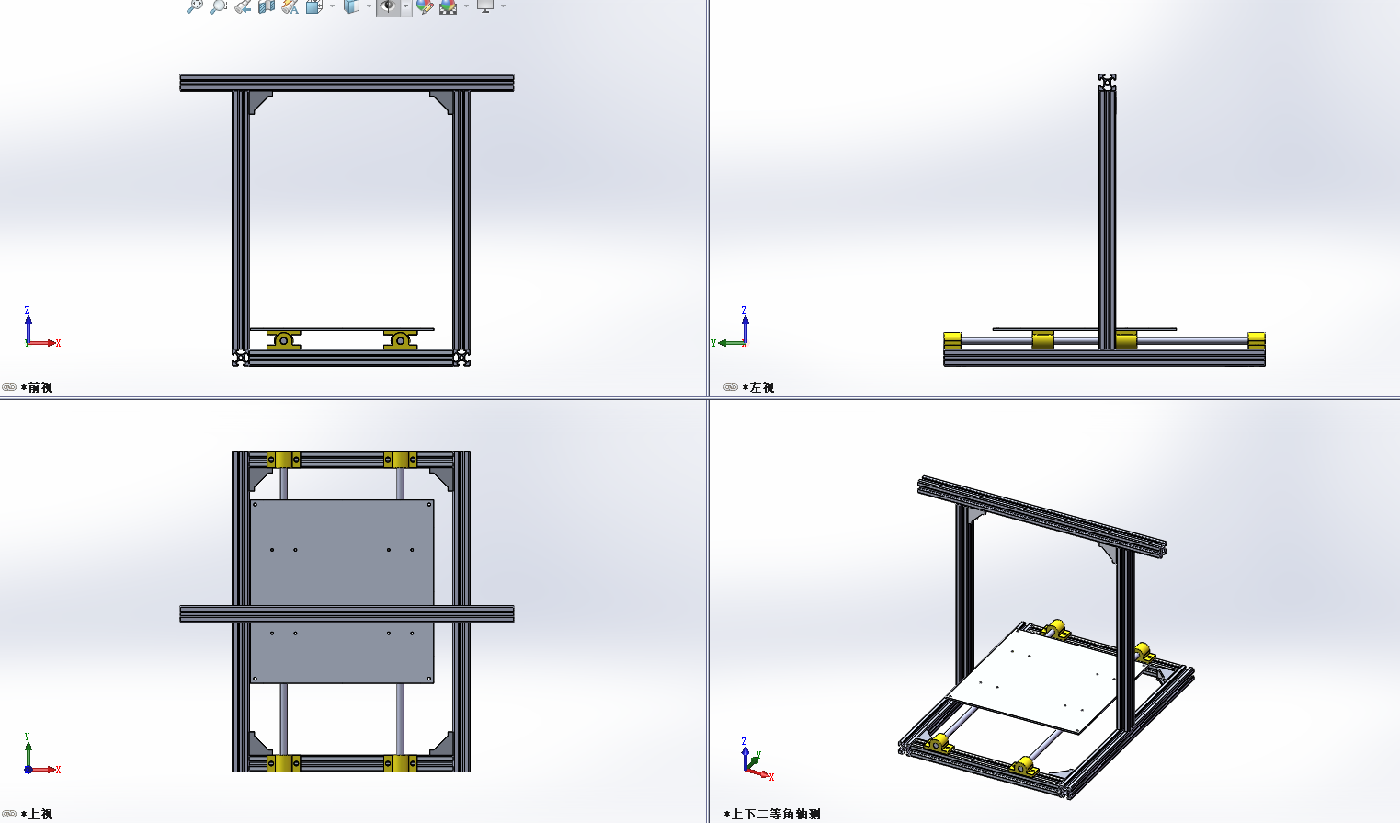
[picture p71: 方案一/图片/总装1.png]
