Blosslom1/FDM_i3_3Dprinter/软件部分/相关软件/Simplify3D-4.0.1汉化版免安装/Simplify3D-4.0.1汉化版/说明.txt

该汉化版部分内容为机翻，理解不了的请参考这个全精校翻译：

http://www.diankeshequ.com/forum.php?mod=viewthread&tid=1470
