Blosslom1/FDM_i3_3Dprinter/模型/主板盒/主板盒/images/aed219fc8d5d04b5a895c97b4dee624e_preview_featured.jpg

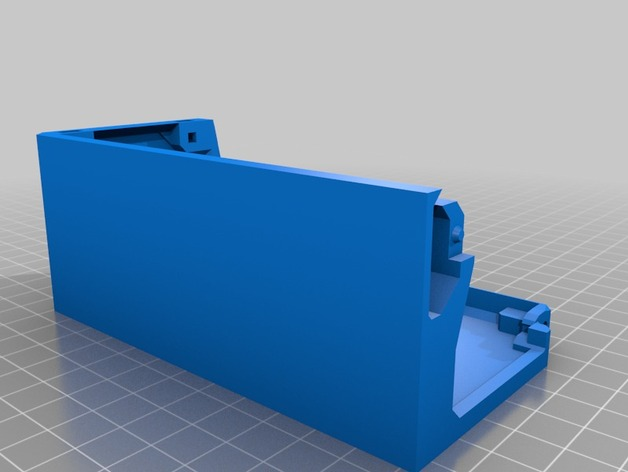
模型/主板盒/主板盒/images/aed219fc8d5d04b5a895c97b4dee624e_preview_featured.jpg
