Blosslom1/FDM_i3_3Dprinter/模型/主板盒/主板盒/images/b92482c47a234ab2cb65d0bfa42fb4e2_preview_featured.jpg

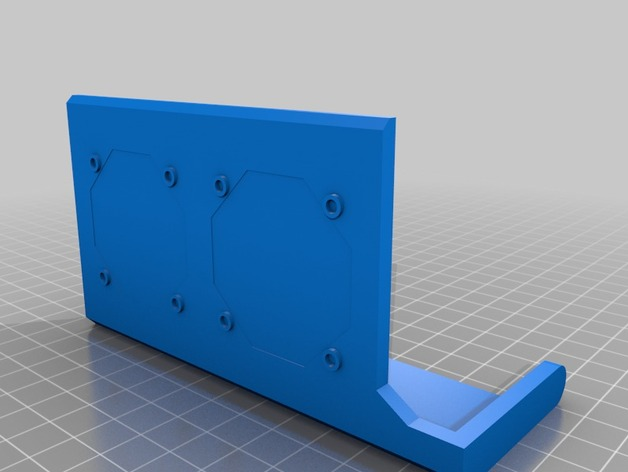
模型/主板盒/主板盒/images/b92482c47a234ab2cb65d0bfa42fb4e2_preview_featured.jpg
