Blosslom1/FDM_i3_3Dprinter/模型/主板盒/主板盒/images/Captura_de_pantalla_de_2015-04-08_100959_preview_featured.jpg

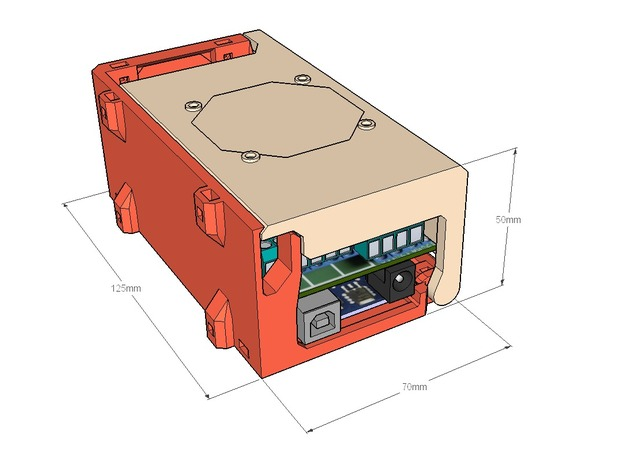
模型/主板盒/主板盒/images/Captura_de_pantalla_de_2015-04-08_100959_preview_featured.jpg
