Blosslom1/FDM_i3_3Dprinter/模型/主板盒/主板盒/images/dasaki_ramps_enclosure_base_preview_featured.jpg

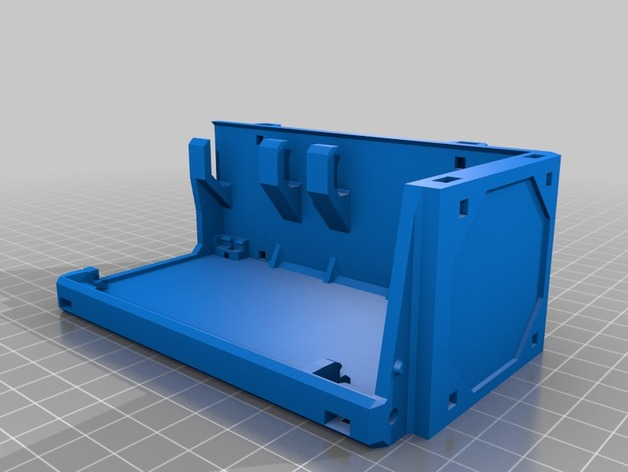
模型/主板盒/主板盒/images/dasaki_ramps_enclosure_base_preview_featured.jpg
