Blosslom1/FDM_i3_3Dprinter/模型/主板盒/主板盒/images/e9453b1a17f9f15c97eb4d175b3d8b70_preview_featured.jpg

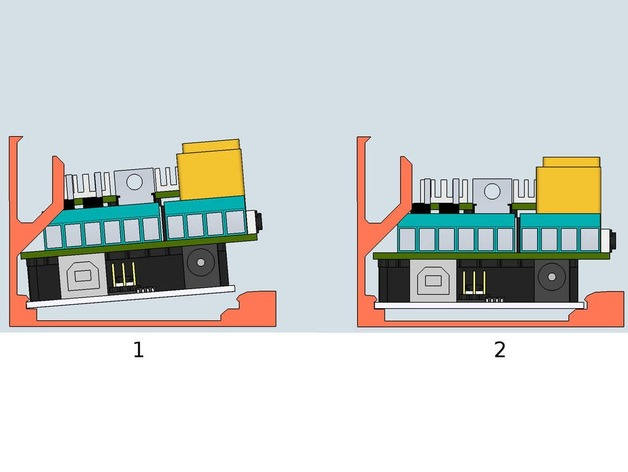
模型/主板盒/主板盒/images/e9453b1a17f9f15c97eb4d175b3d8b70_preview_featured.jpg
