Blosslom1/FDM_i3_3Dprinter/模型/主板盒/主板盒/images/IMG_20150408_095303_preview_featured.jpg

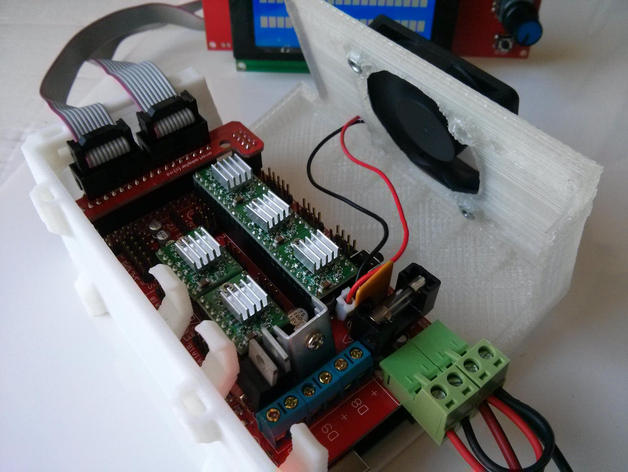
模型/主板盒/主板盒/images/IMG_20150408_095303_preview_featured.jpg
