Blosslom1/FDM_i3_3Dprinter/BOM.xlsx

名称 | 型号 | 单价 | 数量 | 总价
光轴8mm | x350mm | 3.62 | 2 | 7.24
 | y390mm | 5.25 | 2 | 10.5
 | z350 | 4.25 | 2 | 8.5
MK3铝基板热床 | 220*220*3 | 37 | 1 | 37
X型材 | x250mm | 6 | 2 | 12
 | y390mm | 6 | 2 | 12
 | z320mm | 6 | 2 | 12
 | 横梁400mm | 9 | 1 | 9
螺杆导成8 | 350mm | 12.2 | 2 | 24.4
角码 | 20*28mm | 1.25 | 14 | 17.5
42步进电机 | 泰坦挤出机 | 12.8 | 1 | 12.8
 | 38mm | 12.8 | 3 | 38.4
 | 48二手 | 12.8 | 1 | 12.8
联轴器 | 5*8 | 1.69 | 2 | 3.38
直线轴承 | 8*15*24 | 1.42 | 12 | 17.04
同步轮 | 20齿 | 1 | 2 | 2
惰轮 | 20齿 | 2.3 | 2 | 4.6
同步带 | 6mm*2m | 4.75 | 1 | 4.75
滚动轴承 | 8*22*7 | 0.26 | 2 | 0.52
CR8散热管 | 红色 | 3.8 | 1 | 3.8
铁氟龙管 | 2*4 | 2.2 | 1 | 2.2
气动插头 | M6 | 0.6 | 1 | 0.6
CR10远程挤出机 | 红色 | 11 | 1 | 11
E3D铝加热块 | MK8 | 0.45 | 1 | 0.45
散热风扇 | 12V | 2 | 2 | 4
风扇保护架 | 40*40 | 0.55 | 2 | 1.1
喷头 | 黄铜0.3 | 0.2 | 1 | 0.2
喉管 | E3D | 0.5 | 1 | 0.5
硅胶 |  | 3.7 | 1 | 3.7
电源 | 12V20A250W | 38 | 1 | 38
加热管 | 12V40W | 1.55 | 1 | 1.55
热敏电阻 | 200℃ | 1.78 | 1 | 1.78
arduino | MEGA2560 R3 | 37.8 | 1 | 37.8
拓展板 | RAMPS1.4 | 13.8 | 1 | 13.8
步进电机驱动板 | A4988 | 3 | 5 | 15
显示屏 | 12864LCD | 30 | 1 | 30
铝板 | 220*220 | 13 | 1 | 13
螺丝 | M3多种长度 | 4 | 5 | 20
尼龙轧带 | 4*200 | 4.5 | 1 | 4.5
固定件 | 建模定制 | 30 | 1 | 30
总价 |  |  |  | 479.41
