Blosslom1/FDM_i3_3Dprinter/BOM.md

| 步进电机√ | 11.48 |
| --- | --- |
| X型材√ | 9.8 |
| 3D Touch | 42.88 |
| 显示屏smart controll  | 32 |
| MWGA主板 | 36.8 |
| Ramps拓展板 | 13.8 |
| 步进电机驱动（16/32） | 1.99/5.13 |
| 铁氟龙管 | 1-2.5 |
| 直流电源 | 26-38 |
| PE缠绕管 | 3.12 |
| 限位开关 | 1.65 |
| 光轴√ | 5.25 |
| 步进电机并联 | 1.58 |
| 测温电阻 | 2.5 |
| 直线轴承 | 1.4 |
| 同步带 | 2.7 |
| 加热棒 | 1.55-4.75 |
| 同步轮 | 1 |
| T型螺杆√ | 12.2 |
| 联轴器√ | 0.5-1 |
| 同步带弹簧 | 0.13 |
| 散热风扇 | 2 |
| 散热铝片 | 3.2 |
| 喉管 | 0.75-1.2  |
| 喉管散热 | 2.6 |
| 喉管硅胶 | 2.8 |
| 喷嘴 | 0.09 |
| MK8铝加热块 | 0.68-1.6  |
| MK3热床√ | 29.8 |
| 远程挤出机 | 11 |
