Blosslom1/FDM_i3_3Dprinter/方案一/总装 - 备份2.SLDASM

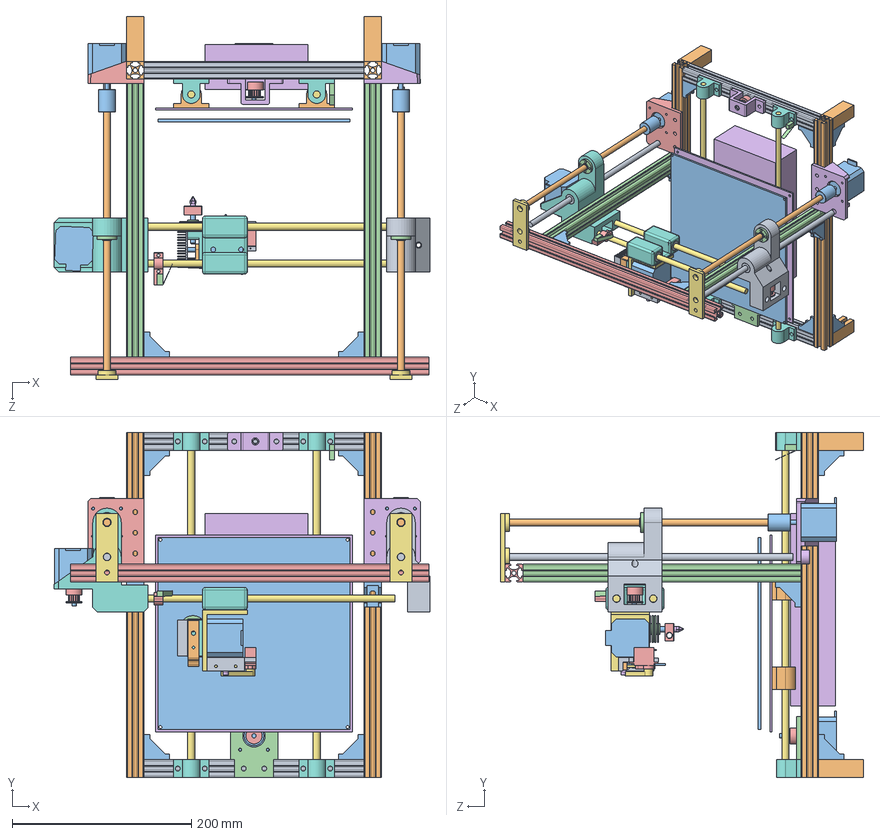
[picture p86: CAD file, 2021-01-11]
方案一/总装 - 备份2.SLDASM
419.1 x 385.0 x 405.0 mm
X型材 x 2
Y型材 x 2
角码 x 12
Z型材 x 2
横梁型材
热床平台
Y光轴380 x 2
Y光轴固定 x 4
LM8UU x 12
热床底板固定 x 4
42步进电机 x 5
Y轴步进电机固定
同步轮 x 4
Y同步轮固定
X光轴320 x 2
打印头固定
MK8散热片
MK8压杆
喉管
喉管散热片 x 4
铝加热块
喷口
挤出机支架
MK8底板
Z光轴345 x 2
Z丝杆305 x 2
联轴器 x 2
丝杆螺母 x 2
z电机支架
z电机支架B
z丝杆固定 x 2
z滑块左侧
z滑块右侧
立柱 x 4
热床
微动开关 x 2
X限位固定 x 2
电源
M3光轴 x 2
光耦
调平底板
调平滑块
探针
调平遮挡
舵机
MR63ZZ x 2
调平拨杆
