Blosslom1/FDM_i3_3Dprinter/方案二/装配体1.SLDASM

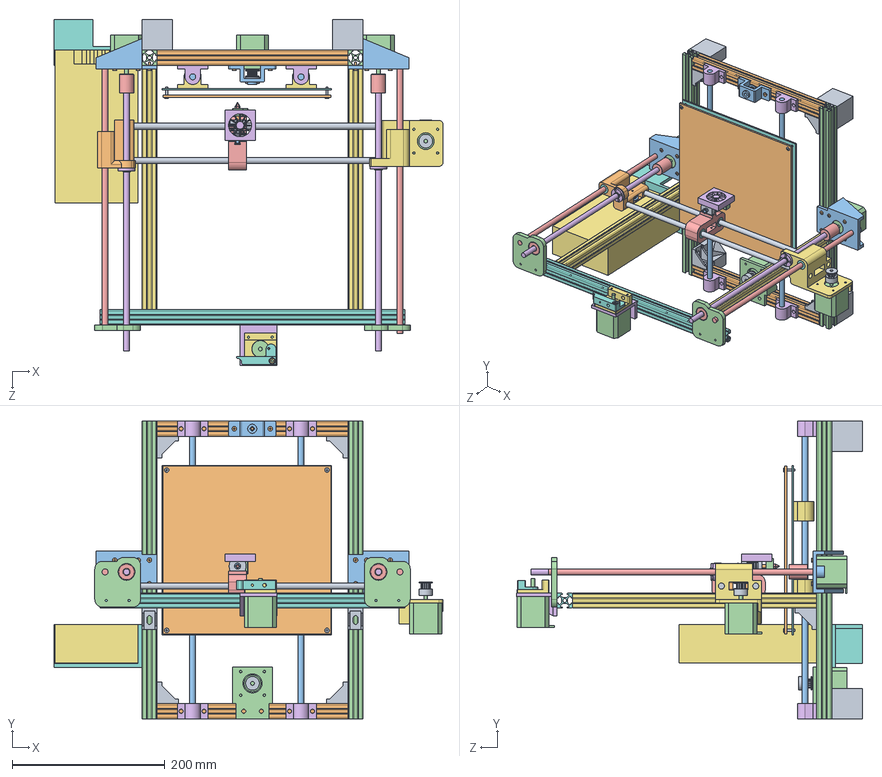
[picture p89: CAD file, 2021-01-11]
方案二/装配体1.SLDASM
509.5 x 390.0 x 453.0 mm
X光轴320 x 2
X型材250 x 2
Y光轴390 x 2
Y型材390 x 2
Z光轴350 x 2
Z丝杆350 x 2
Z型材320 x 2
横梁型材350
角码 x 6
热床
Z轴固定 x 2
42步进电机 x 5
联轴器 x 2
丝杆螺母 x 2
X固定
LM8UU x 10
同步轮 x 2
X固定右
惰轮 x 2
Y固定上 x 2
轴承 x 2
Y光轴固定 x 4
热床底板固定 x 4
热床平台
M3螺丝 x 4
M3螺丝8m x 14
Y同步轮固定
Y轴步进电机固定
熔融喷头固定
挤出机支架
MK8底板
MK8压杆
喉管散热
喉管
气动插头
铝加热块
喷口
风扇
电源
电源支座
底座 x 4
