Blosslom1/FDM_i3_3Dprinter/方案一/STL/Z电机支架A.STL

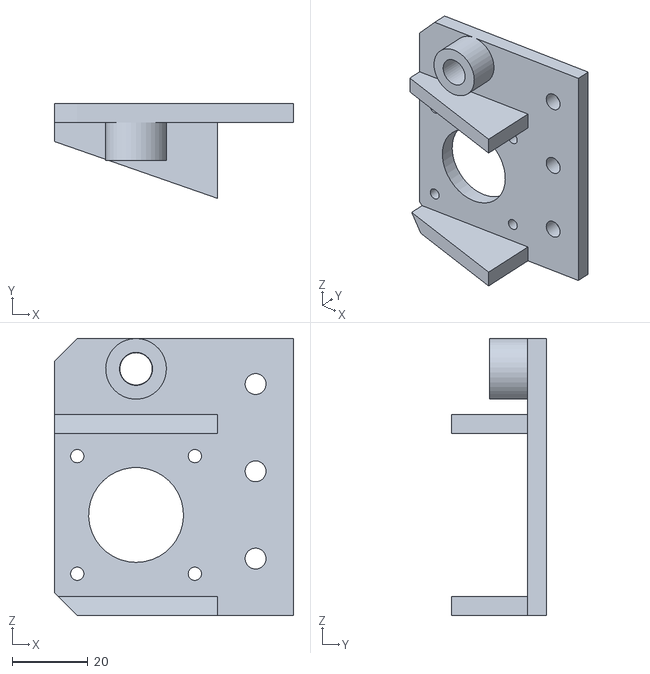
[picture p90: CAD file, 2021-01-11]
方案一/STL/Z电机支架A.STL
63.0 x 25.0 x 73.0
