Blosslom1/FDM_i3_3Dprinter/方案一/传动设备/Y轴步进电机固定.SLDPRT

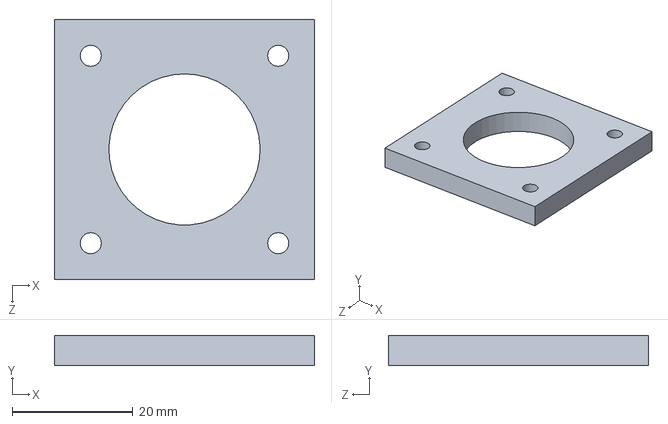
[picture p91: CAD file, 2021-01-11]
方案一/传动设备/Y轴步进电机固定.SLDPRT
43.0 x 5.00 x 43.0 mm
