Blosslom1/FDM_i3_3Dprinter/方案一/支架螺丝/联轴器.SLDPRT

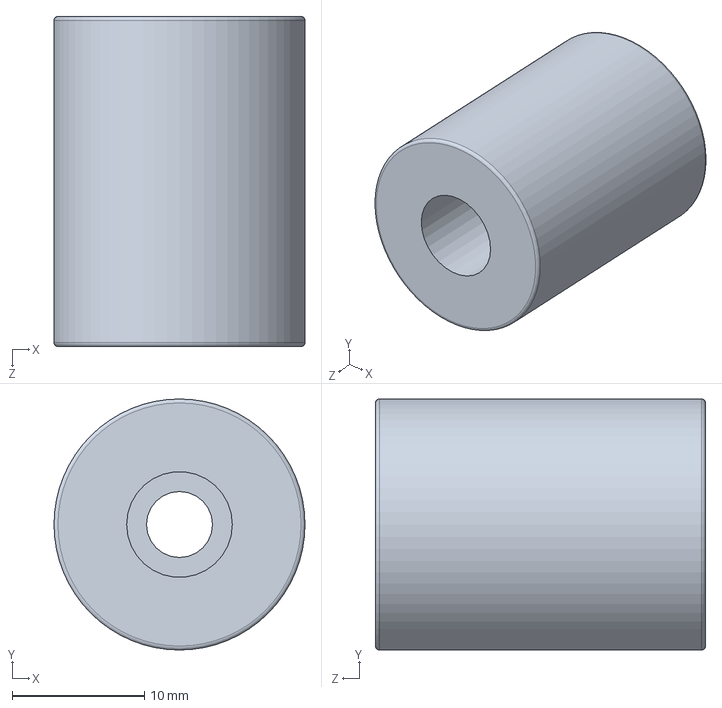
[picture p93: CAD file, 2021-01-11]
方案一/支架螺丝/联轴器.SLDPRT
19.0 x 19.0 x 25.0 mm
