Blosslom1/FDM_i3_3Dprinter/方案一/调平遮挡.SLDPRT

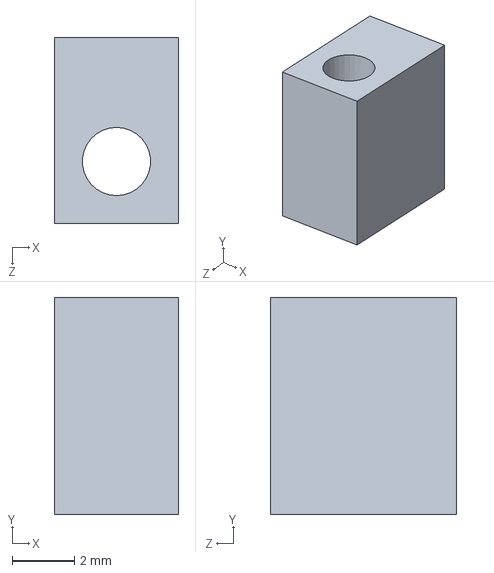
[picture p94: CAD file, 2021-01-11]
方案一/调平遮挡.SLDPRT
4.00 x 7.00 x 6.00 mm
