Blosslom1/FDM_i3_3Dprinter/方案二/Z丝杆350.SLDPRT

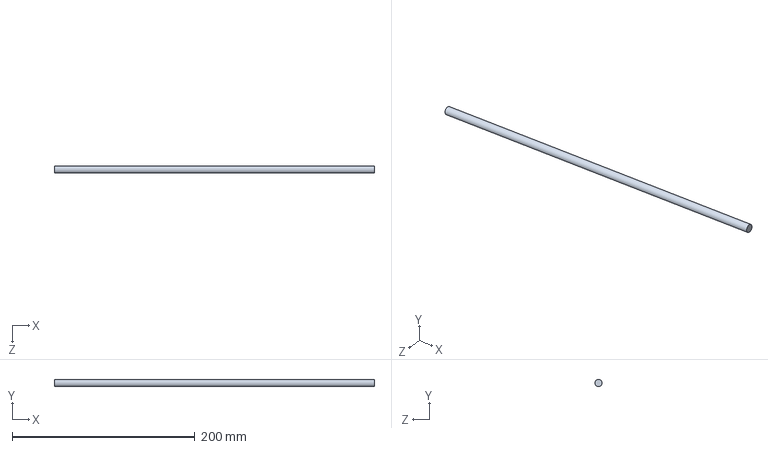
[picture p95: CAD file, 2021-01-11]
方案二/Z丝杆350.SLDPRT
350.0 x 8.00 x 8.00 mm
