Blosslom1/FDM_i3_3Dprinter/模型/x轴双电机调平定位.stl

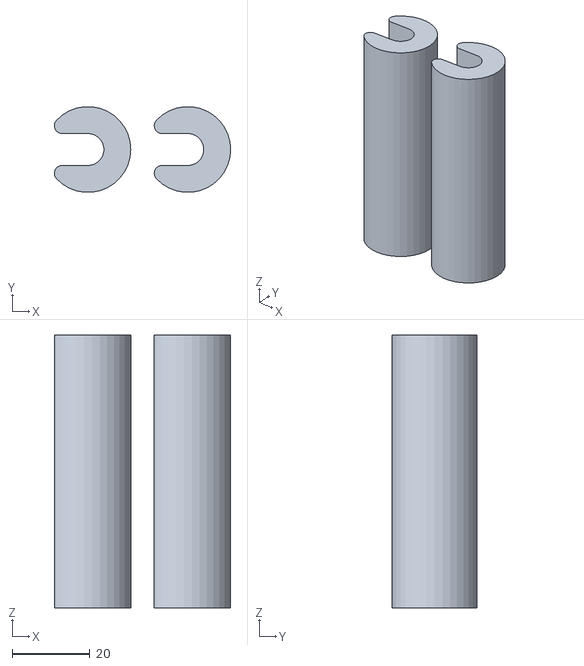
[picture p96: CAD file, 2021-01-11]
模型/x轴双电机调平定位.stl
45.2 x 21.9 x 70.0
