Blosslom1/FDM_i3_3Dprinter/模型/主板盒/主板盒/files/dasaki_ramps_enclosure_base_mountless.stl

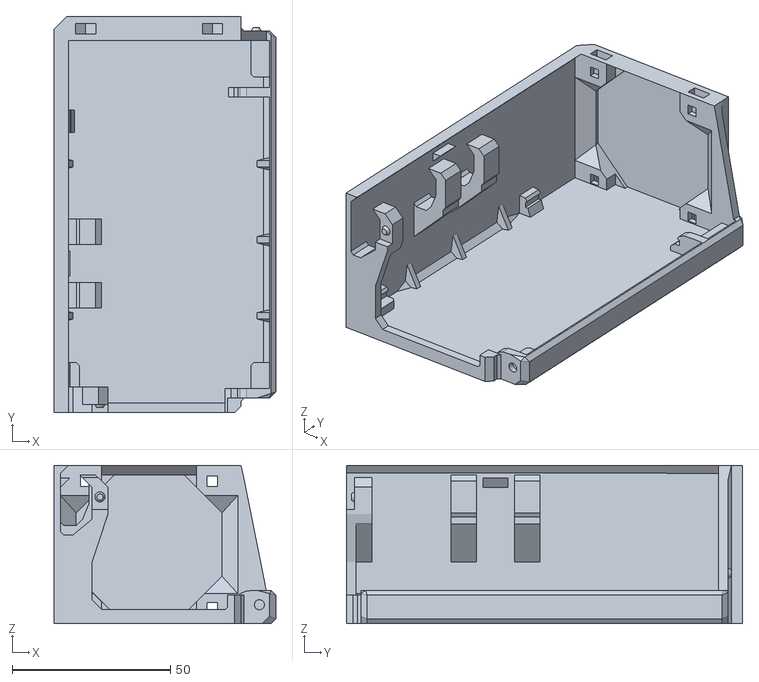
[picture p97: CAD file, 2021-01-11]
模型/主板盒/主板盒/files/dasaki_ramps_enclosure_base_mountless.stl
70.1 x 125.0 x 50.0
