Blosslom1/FDM_i3_3Dprinter/方案一/STL/Y轴42固定.STL

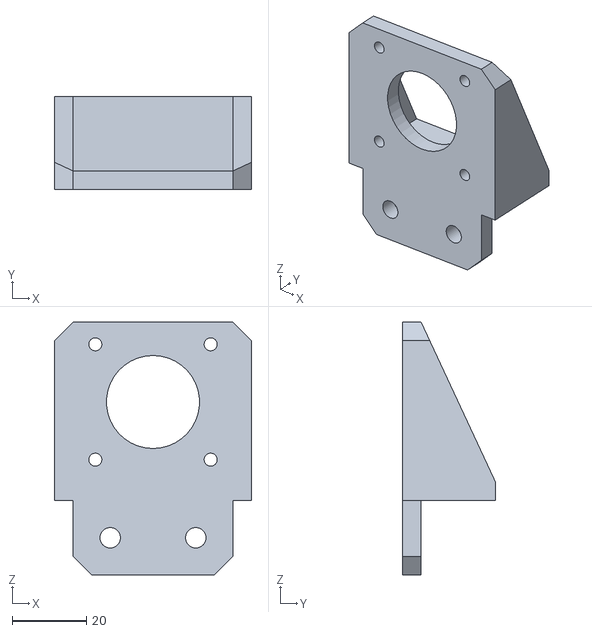
[picture p98: CAD file, 2021-01-11]
方案一/STL/Y轴42固定.STL
53.0 x 25.0 x 68.0
