Blosslom1/FDM_i3_3Dprinter/方案一/传动设备/角码.SLDPRT

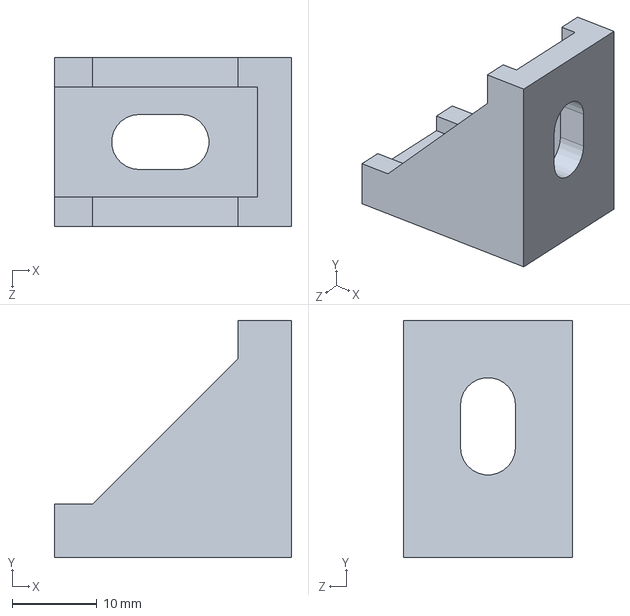
[picture p99: CAD file, 2021-01-11]
方案一/传动设备/角码.SLDPRT
28.0 x 28.0 x 20.0 mm
