Blosslom1/FDM_i3_3Dprinter/方案一/支架螺丝/LM8UU.SLDPRT

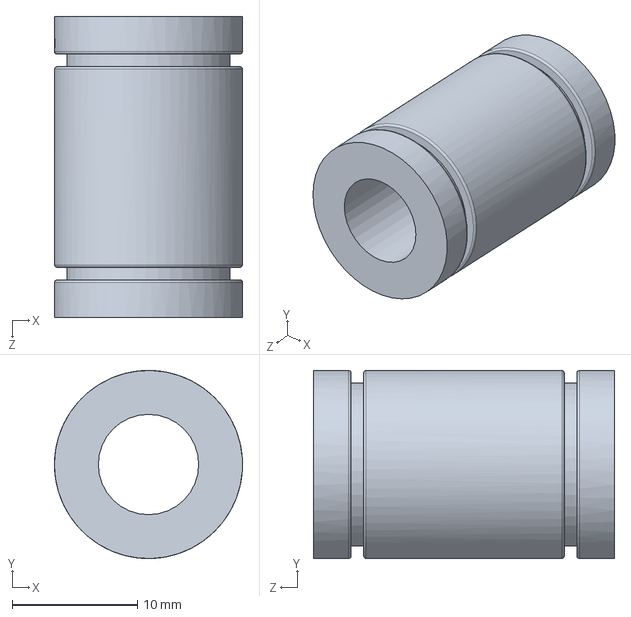
[picture p101: CAD file, 2021-01-11]
方案一/支架螺丝/LM8UU.SLDPRT
15.0 x 15.0 x 24.0 mm
