Blosslom1/FDM_i3_3Dprinter/方案二/热床.SLDPRT

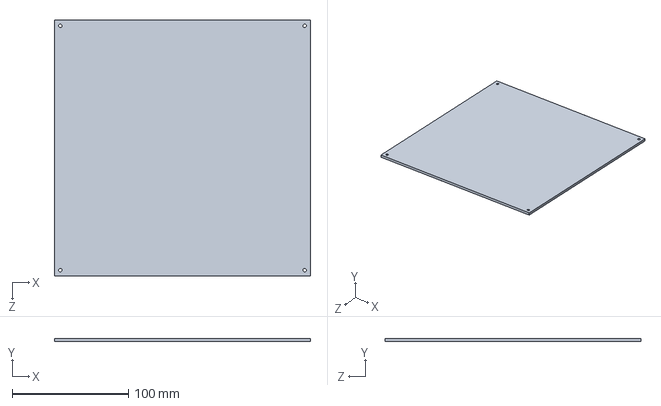
[picture p102: CAD file, 2021-01-11]
方案二/热床.SLDPRT
220.0 x 3.00 x 220.0 mm
