Blosslom1/FDM_i3_3Dprinter/模型/主板盒/主板盒/files/dasaki_ramps_enclosure_cover.stl

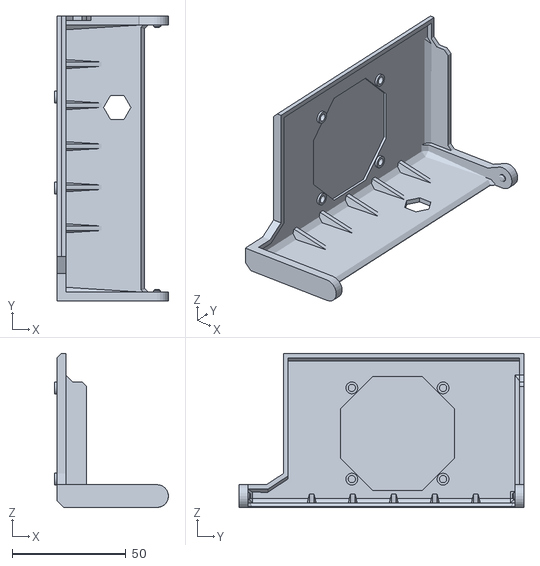
[picture p103: CAD file, 2021-01-11]
模型/主板盒/主板盒/files/dasaki_ramps_enclosure_cover.stl
50.0 x 125.0 x 67.6
