Blosslom1/FDM_i3_3Dprinter/方案一/STL/立柱X4.STL

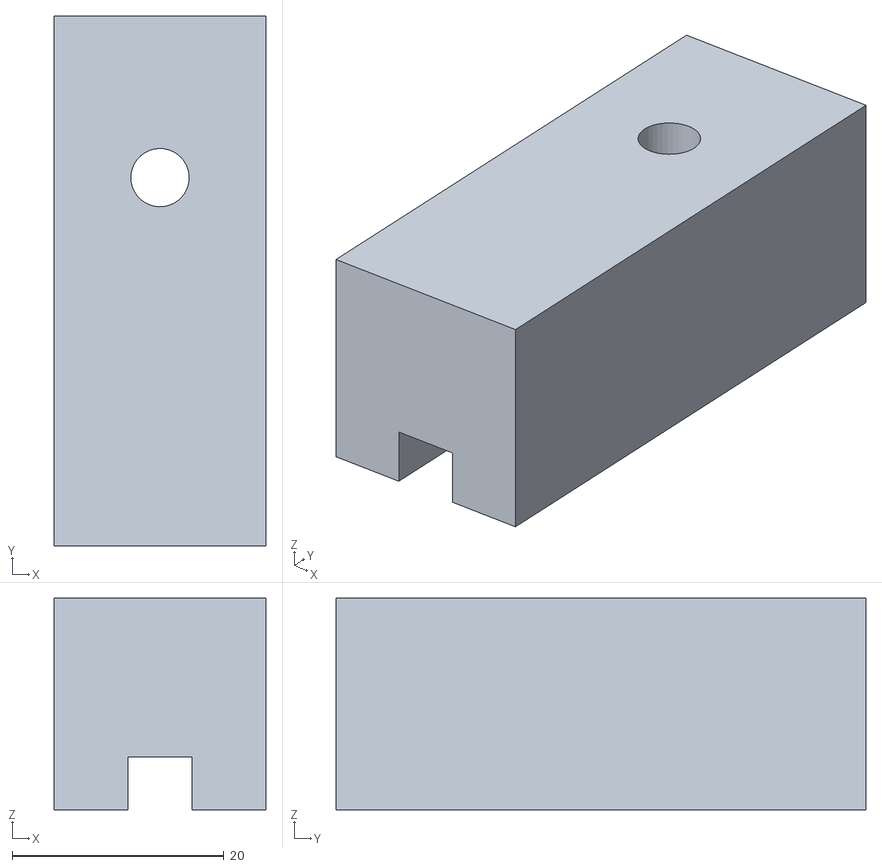
[picture p104: CAD file, 2021-01-11]
方案一/STL/立柱X4.STL
20.0 x 50.0 x 20.0
