Blosslom1/FDM_i3_3Dprinter/方案一/支架/Z光轴345.SLDPRT

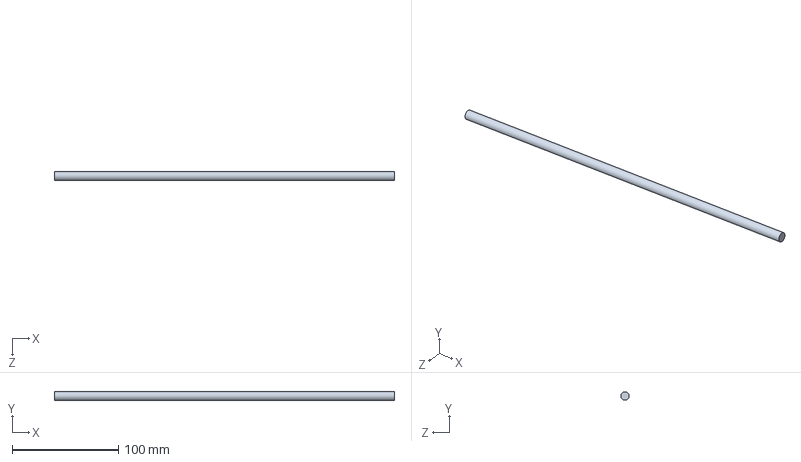
[picture p105: CAD file, 2021-01-11]
方案一/支架/Z光轴345.SLDPRT
320.0 x 8.00 x 8.00 mm
