Blosslom1/FDM_i3_3Dprinter/方案一/支架螺丝/同步轮.SLDPRT

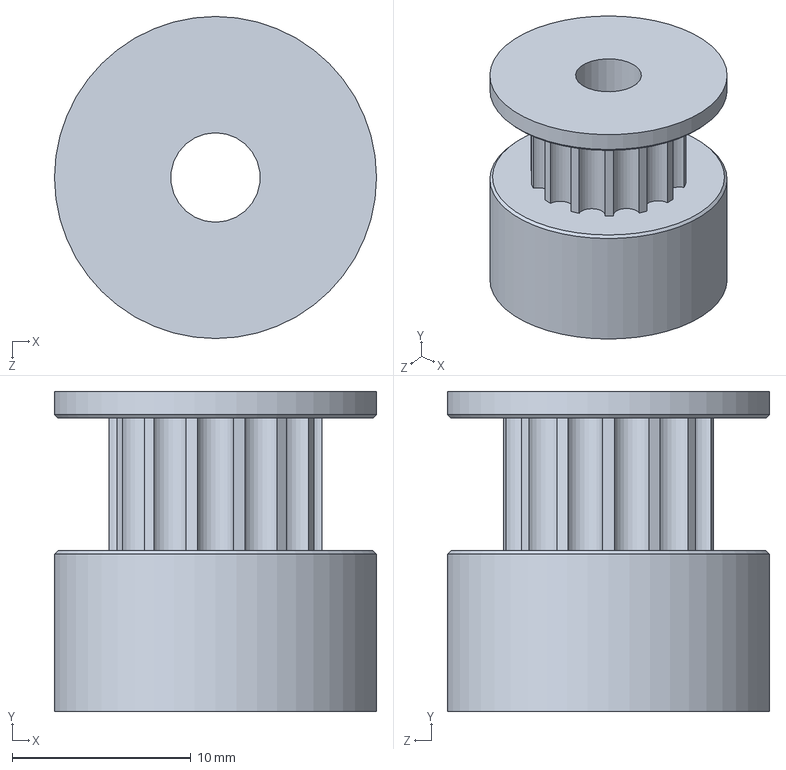
[picture p106: CAD file, 2021-01-11]
方案一/支架螺丝/同步轮.SLDPRT
18.0 x 17.9 x 18.0 mm
