Blosslom1/FDM_i3_3Dprinter/模型/主板盒/主板盒/files/dasaki_ramps_enclosure_base_v2.stl

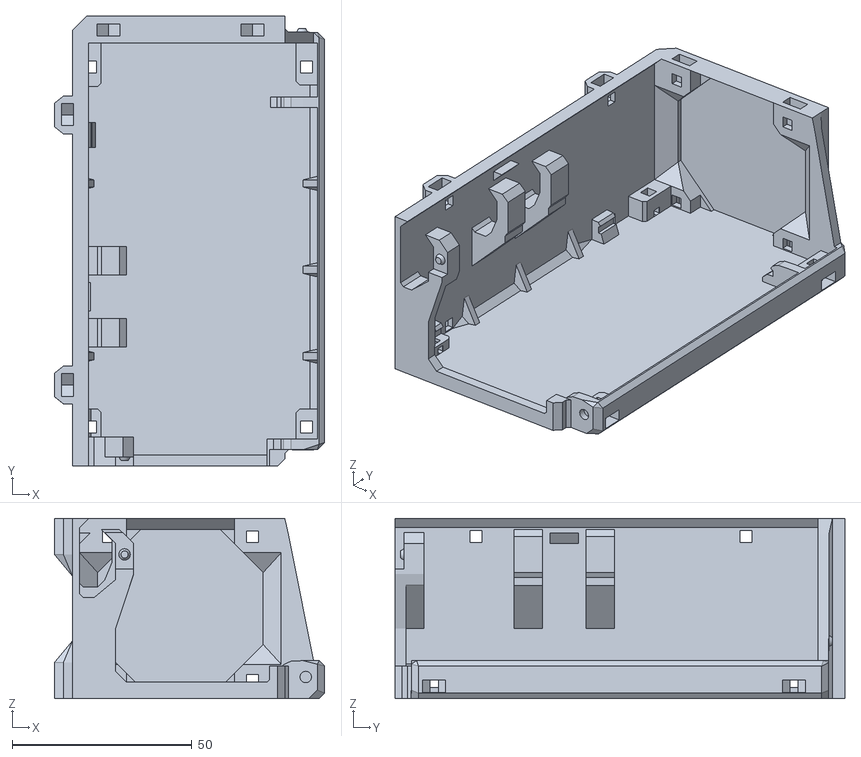
[picture p107: CAD file, 2021-01-11]
模型/主板盒/主板盒/files/dasaki_ramps_enclosure_base_v2.stl
75.1 x 125.0 x 50.0
