Blosslom1/FDM_i3_3Dprinter/方案一/STL/电源挂架AX2.STL

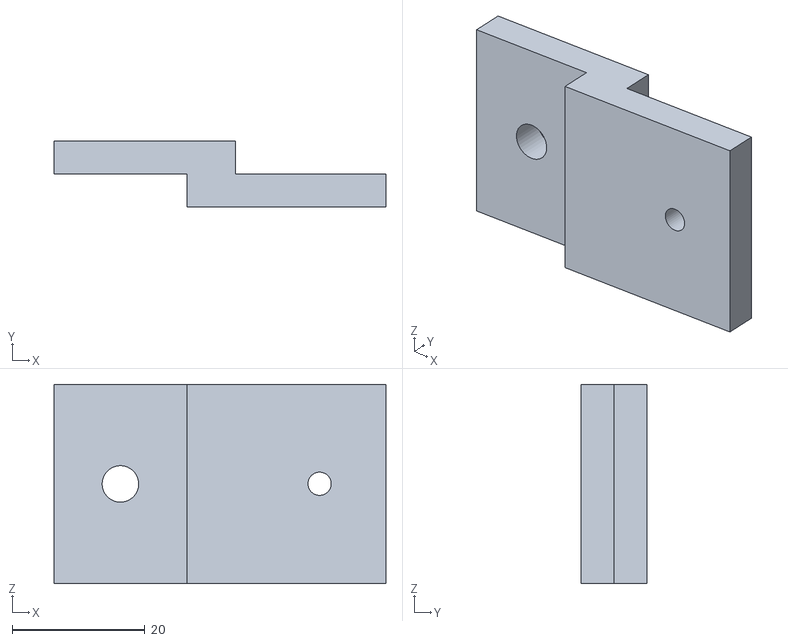
[picture p108: CAD file, 2021-01-11]
方案一/STL/电源挂架AX2.STL
50.0 x 10.0 x 30.0
