Blosslom1/FDM_i3_3Dprinter/方案一/Y光轴固定.SLDPRT

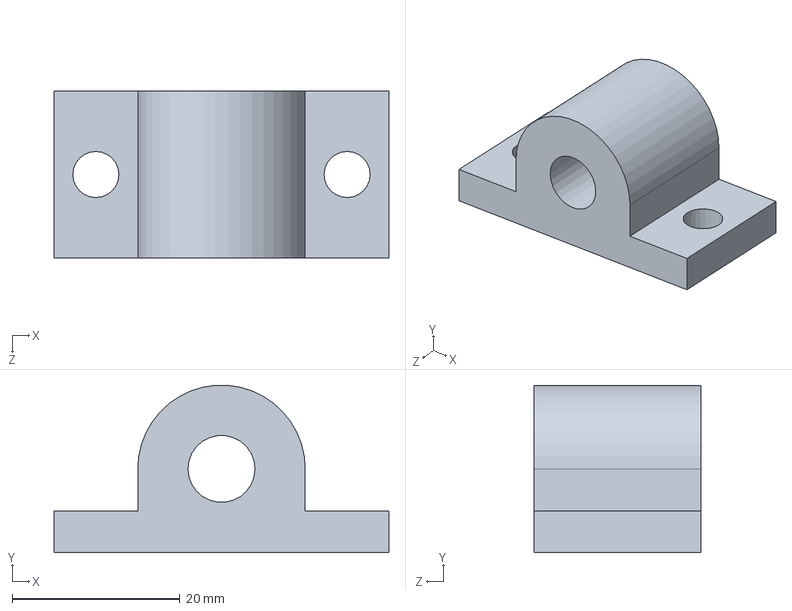
[picture p109: CAD file, 2021-01-11]
方案一/Y光轴固定.SLDPRT
40.0 x 20.0 x 20.0 mm
