Blosslom1/FDM_i3_3Dprinter/方案一/传动设备/42步进电机.SLDPRT

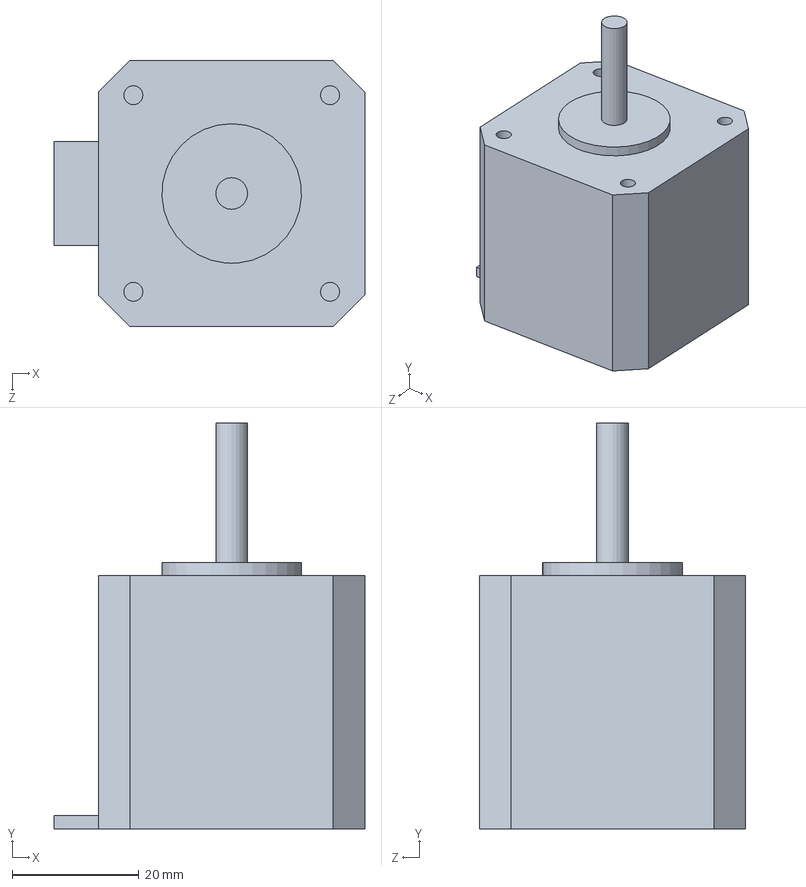
[picture p110: CAD file, 2021-01-11]
方案一/传动设备/42步进电机.SLDPRT
49.0 x 64.0 x 42.0 mm
