Blosslom1/FDM_i3_3Dprinter/方案一/支架/Z型材.SLDPRT

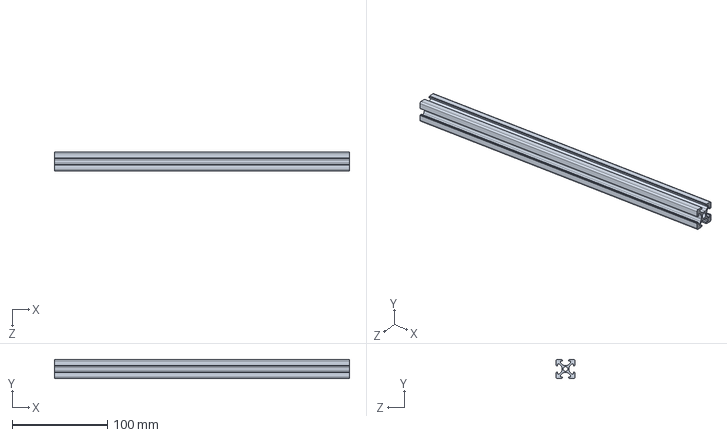
[picture p111: CAD file, 2021-01-11]
方案一/支架/Z型材.SLDPRT
310.0 x 20.0 x 20.0 mm
