Blosslom1/FDM_i3_3Dprinter/方案一/支架螺丝/丝杆螺母.SLDPRT

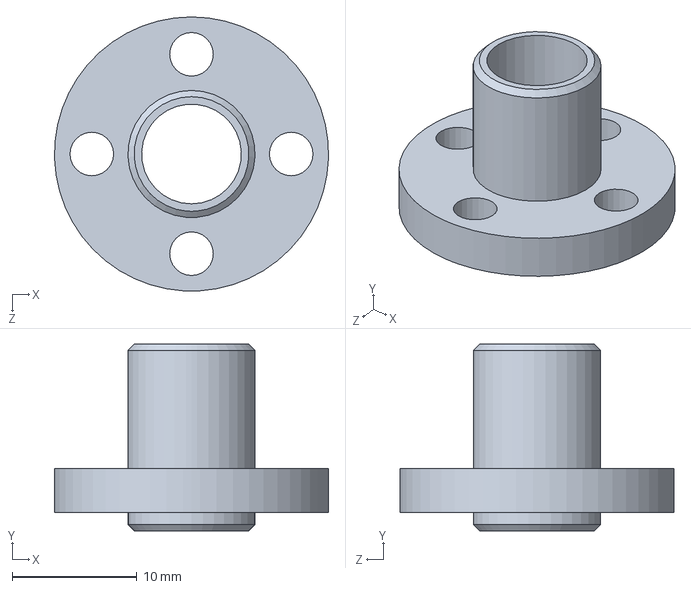
[picture p112: CAD file, 2021-01-11]
方案一/支架螺丝/丝杆螺母.SLDPRT
22.0 x 15.0 x 22.0 mm
