Blosslom1/FDM_i3_3Dprinter/方案二/M3螺丝.SLDPRT

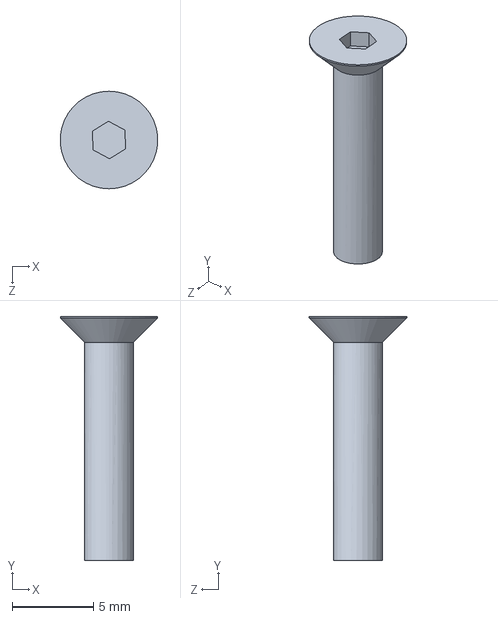
[picture p113: CAD file, 2021-01-11]
方案二/M3螺丝.SLDPRT
5.98 x 15.0 x 6.00 mm
