Blosslom1/FDM_i3_3Dprinter/方案一/STL/同步带加固.STL

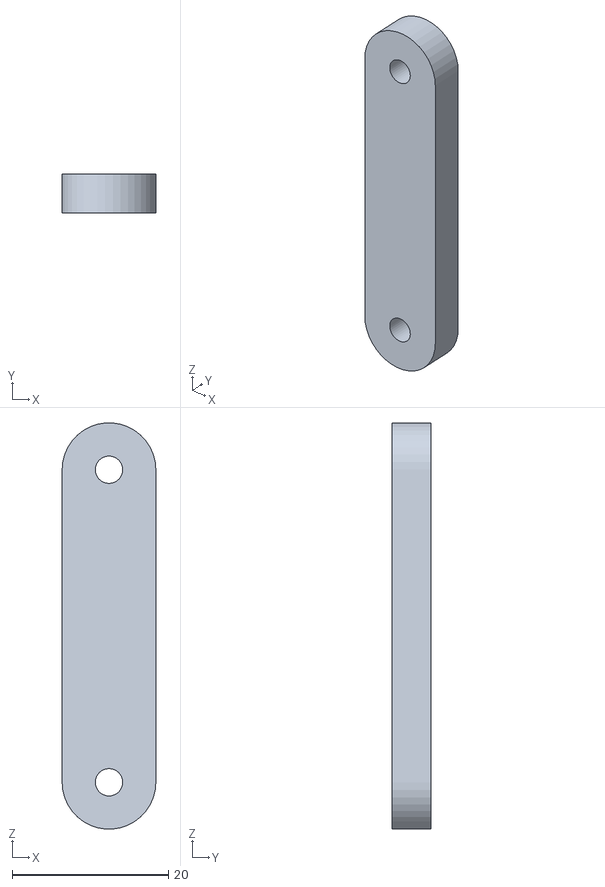
[picture p114: CAD file, 2021-01-11]
方案一/STL/同步带加固.STL
12.0 x 5.00 x 52.0
