Blosslom1/FDM_i3_3Dprinter/方案一/传动设备/电源.SLDPRT

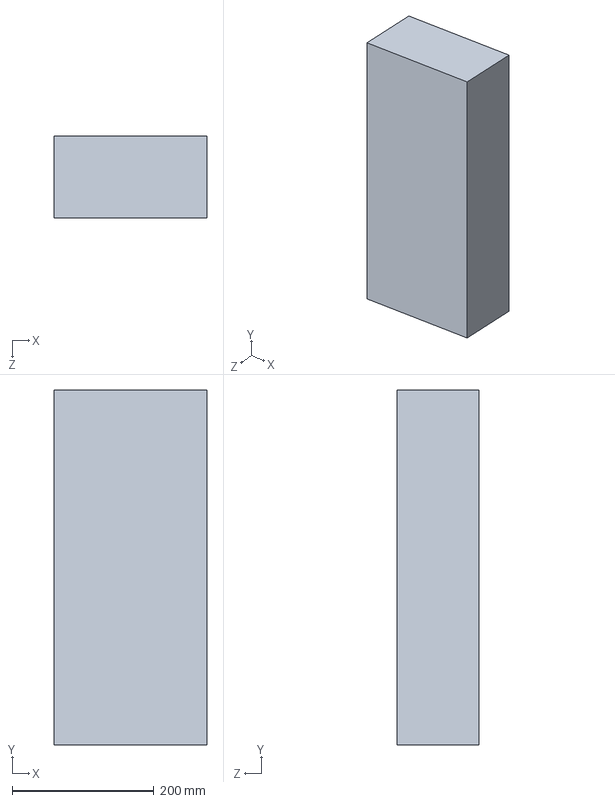
[picture p115: CAD file, 2021-01-11]
方案一/传动设备/电源.SLDPRT
215.0 x 500.0 x 115.0 mm
