Blosslom1/FDM_i3_3Dprinter/方案一/喷口.SLDPRT

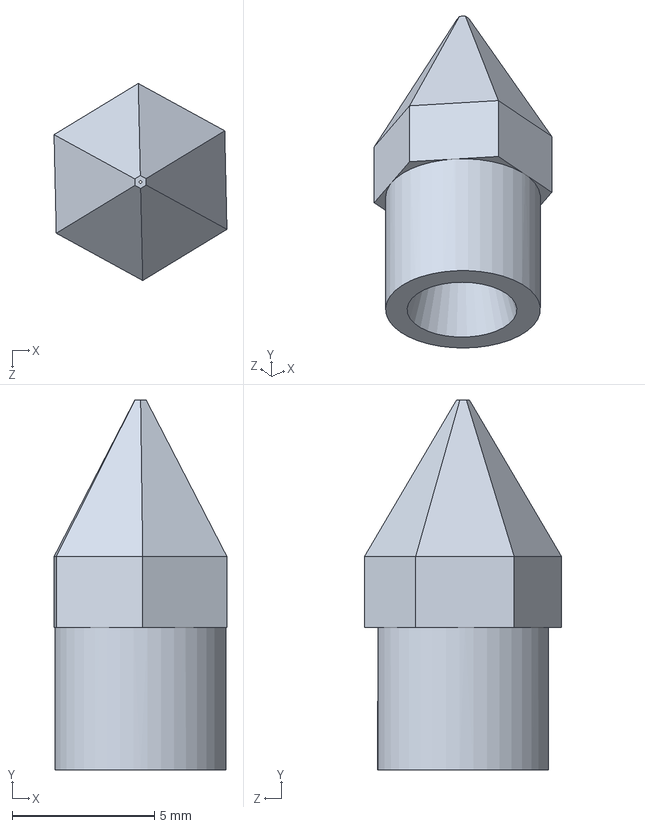
[picture p116: CAD file, 2021-01-11]
方案一/喷口.SLDPRT
6.08 x 13.0 x 6.93 mm
