Blosslom1/FDM_i3_3Dprinter/方案一/支架/打印头固定.SLDPRT

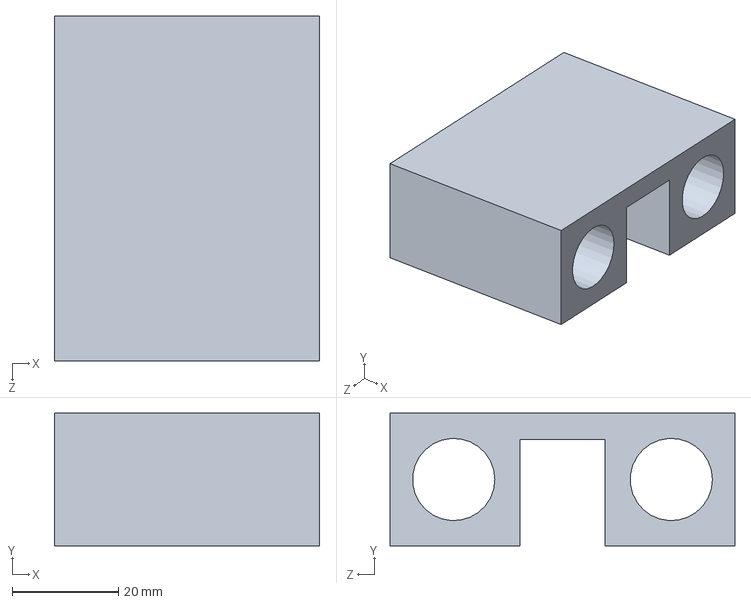
[picture p117: CAD file, 2021-01-11]
方案一/支架/打印头固定.SLDPRT
50.0 x 25.0 x 65.0 mm
