Blosslom1/FDM_i3_3Dprinter/方案一/STL/Z丝杆固定X2.STL

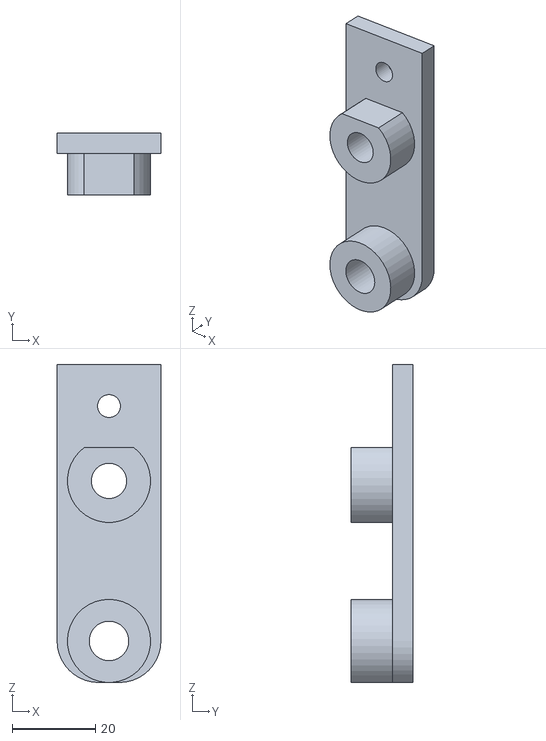
[picture p118: CAD file, 2021-01-11]
方案一/STL/Z丝杆固定X2.STL
25.0 x 15.0 x 76.5
