Blosslom1/FDM_i3_3Dprinter/方案一/传动设备/热床平台.SLDPRT

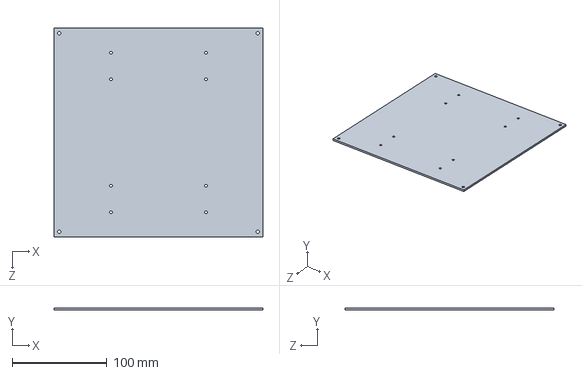
[picture p119: CAD file, 2021-01-11]
方案一/传动设备/热床平台.SLDPRT
220.0 x 2.50 x 220.0 mm
