Blosslom1/FDM_i3_3Dprinter/方案二/喉管散热.SLDPRT

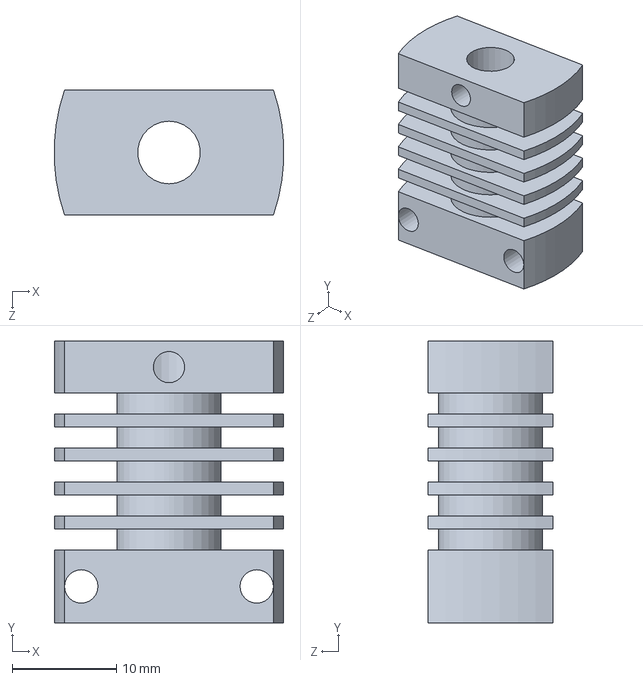
[picture p120: CAD file, 2021-01-11]
方案二/喉管散热.SLDPRT
22.0 x 27.0 x 12.0 mm
