Blosslom1/FDM_i3_3Dprinter/方案一/STL/打印头固定.STL

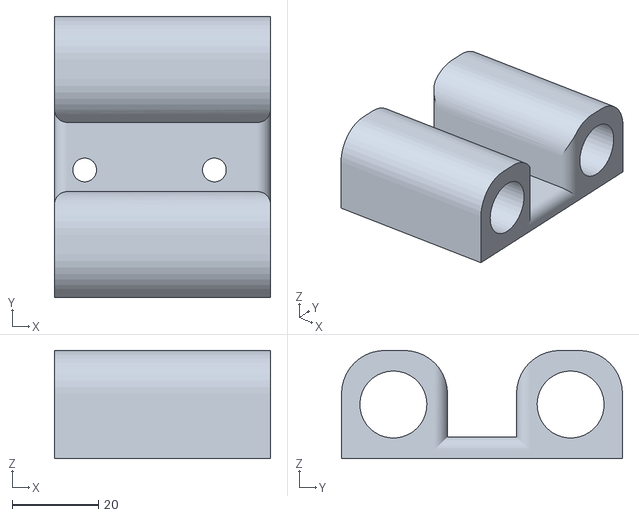
[picture p121: CAD file, 2021-01-11]
方案一/STL/打印头固定.STL
50.0 x 65.0 x 25.0
