Blosslom1/FDM_i3_3Dprinter/方案一/传动设备/微动开关.SLDPRT

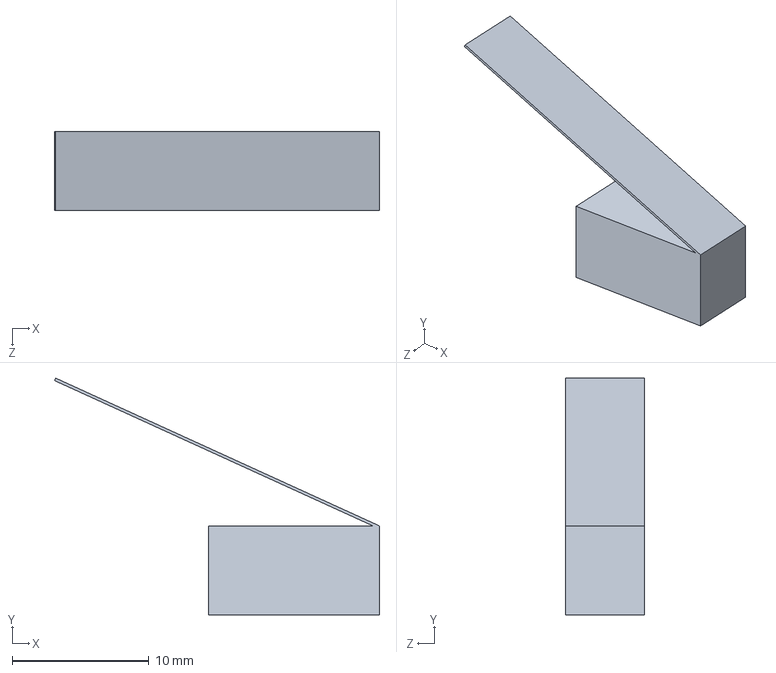
[picture p122: CAD file, 2021-01-11]
方案一/传动设备/微动开关.SLDPRT
23.7 x 17.3 x 5.80 mm
