Blosslom1/FDM_i3_3Dprinter/方案一/控制面板.SLDPRT

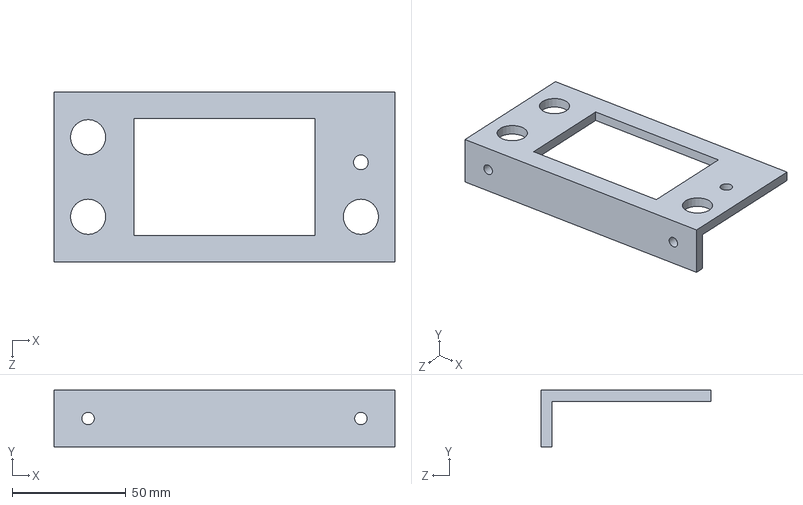
[picture p123: CAD file, 2021-01-11]
方案一/控制面板.SLDPRT
150.0 x 25.0 x 75.0 mm
