Blosslom1/FDM_i3_3Dprinter/方案一/支架/Z丝杆305.SLDPRT

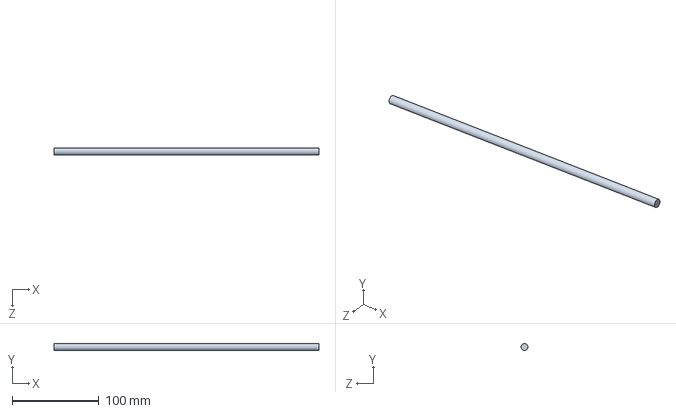
[picture p124: CAD file, 2021-01-11]
方案一/支架/Z丝杆305.SLDPRT
305.0 x 8.00 x 8.00 mm
