Blosslom1/FDM_i3_3Dprinter/方案二/Y固定上.SLDPRT

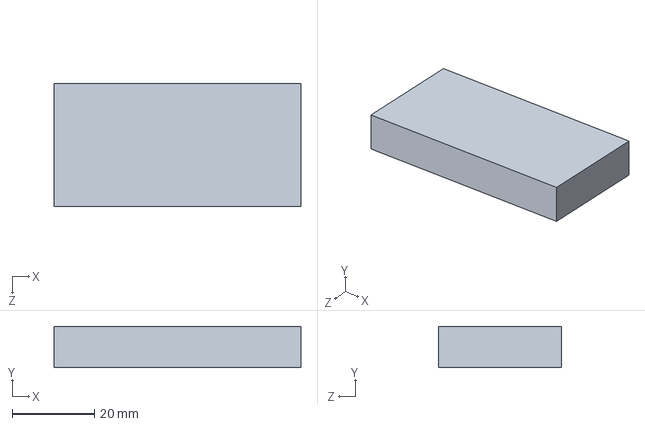
[picture p125: CAD file, 2021-01-11]
方案二/Y固定上.SLDPRT
60.0 x 10.0 x 30.0 mm
