Blosslom1/FDM_i3_3Dprinter/方案一/STL/Z滑块左.STL

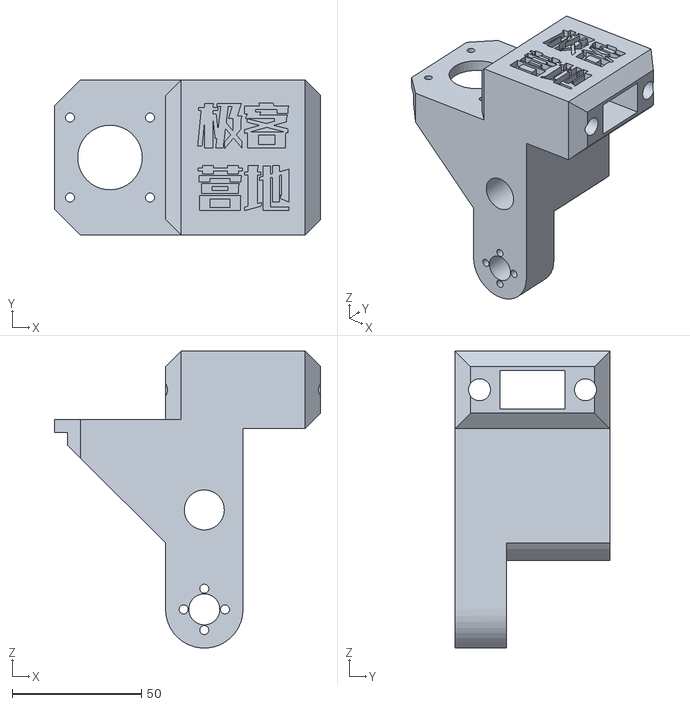
[picture p126: CAD file, 2021-01-11]
方案一/STL/Z滑块左.STL
103.0 x 60.0 x 114.9
