Blosslom1/FDM_i3_3Dprinter/方案一/传动设备/立柱.SLDPRT

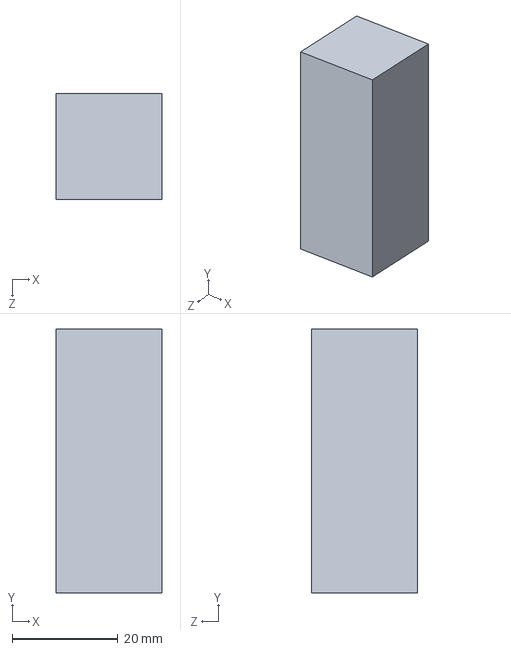
[picture p127: CAD file, 2021-01-11]
方案一/传动设备/立柱.SLDPRT
20.0 x 50.0 x 20.0 mm
