Blosslom1/FDM_i3_3Dprinter/方案一/支架/X型材.SLDPRT

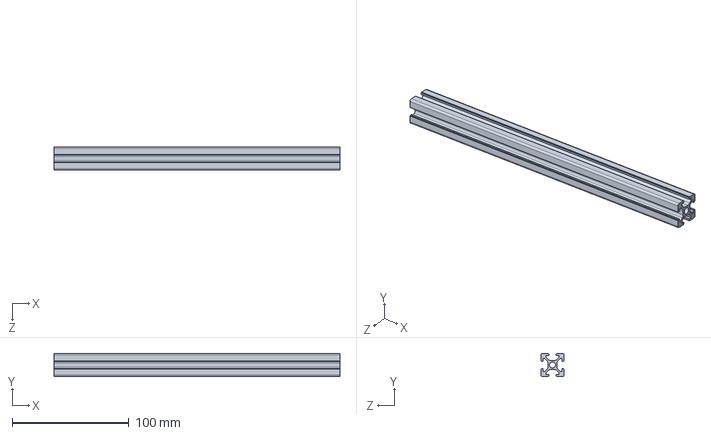
[picture p128: CAD file, 2021-01-11]
方案一/支架/X型材.SLDPRT
245.0 x 20.0 x 20.0 mm
