Blosslom1/FDM_i3_3Dprinter/方案二/风扇.SLDPRT

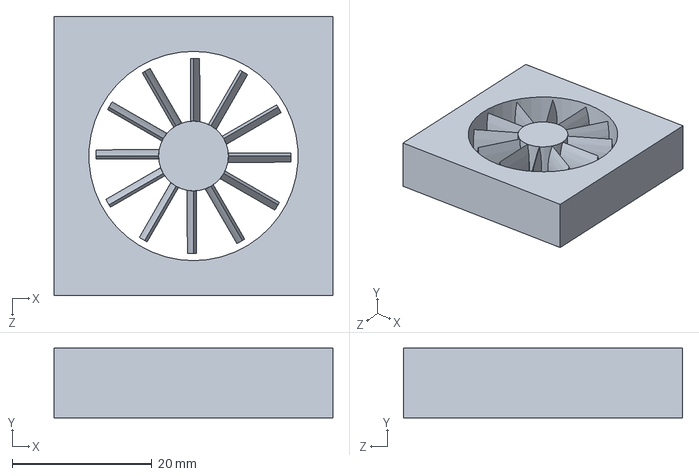
[picture p129: CAD file, 2021-01-11]
方案二/风扇.SLDPRT
40.0 x 10.0 x 40.0 mm
