Blosslom1/FDM_i3_3Dprinter/方案一/STL/Z滑块右.STL

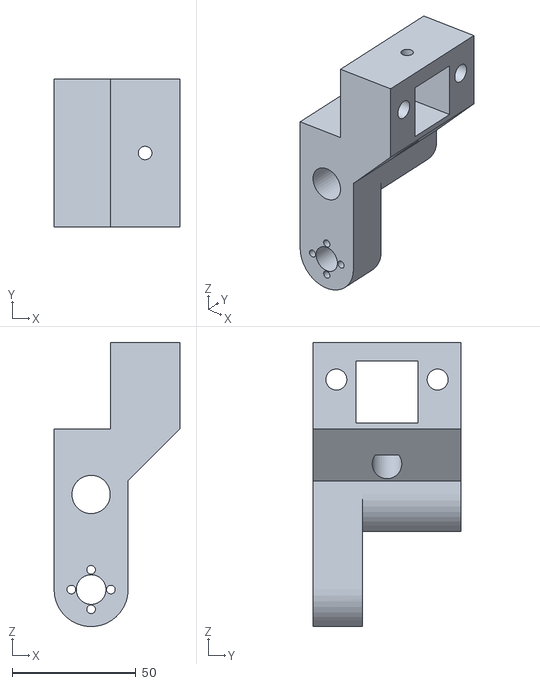
[picture p130: CAD file, 2021-01-11]
方案一/STL/Z滑块右.STL
51.0 x 60.0 x 114.9
