Blosslom1/FDM_i3_3Dprinter/方案一/喉管散热片.SLDPRT

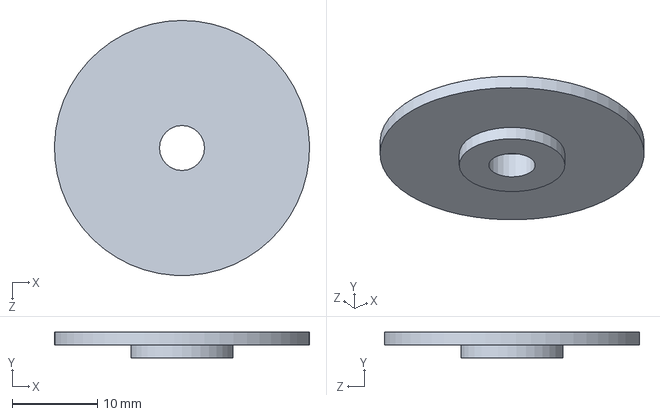
[picture p131: CAD file, 2021-01-11]
方案一/喉管散热片.SLDPRT
30.0 x 3.00 x 30.0 mm
