Blosslom1/FDM_i3_3Dprinter/方案一/支架/Y光轴380.SLDPRT

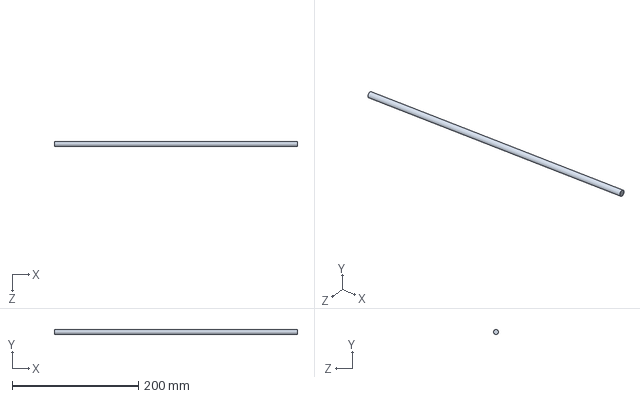
[picture p132: CAD file, 2021-01-11]
方案一/支架/Y光轴380.SLDPRT
385.0 x 8.00 x 8.00 mm
