Blosslom1/FDM_i3_3Dprinter/方案二/轴承.SLDPRT

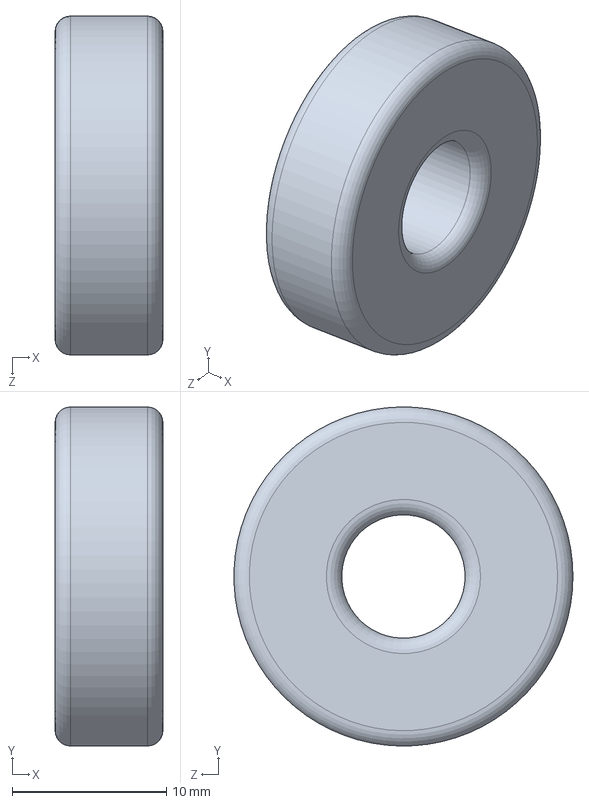
[picture p133: CAD file, 2021-01-11]
方案二/轴承.SLDPRT
7.00 x 22.0 x 22.0 mm
