Blosslom1/FDM_i3_3Dprinter/方案一/STL/遮挡.STL

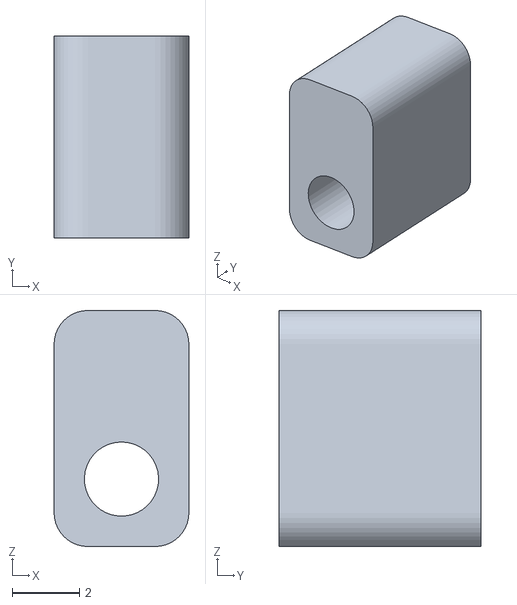
[picture p134: CAD file, 2021-01-11]
方案一/STL/遮挡.STL
4.00 x 6.00 x 7.00
