Blosslom1/FDM_i3_3Dprinter/方案一/喉管.SLDPRT

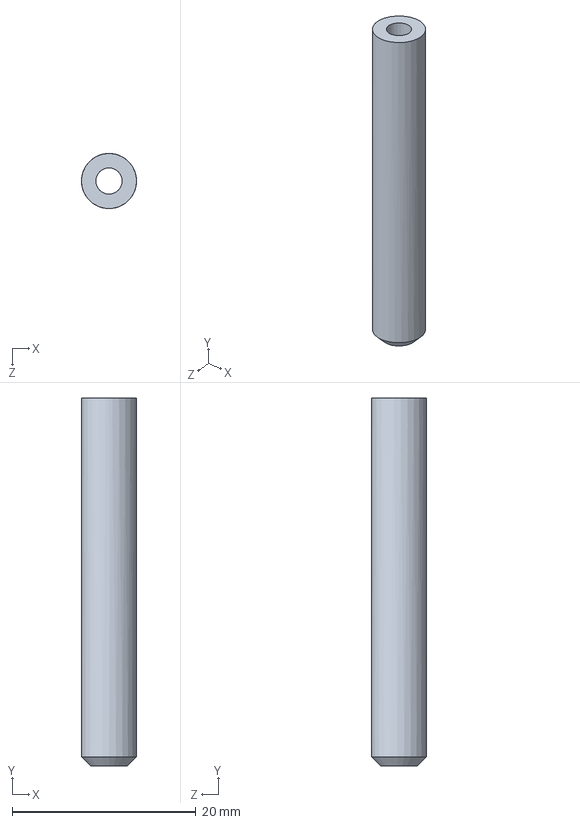
[picture p135: CAD file, 2021-01-11]
方案一/喉管.SLDPRT
5.99 x 40.0 x 6.00 mm
