Blosslom1/FDM_i3_3Dprinter/方案二/X固定右.SLDPRT

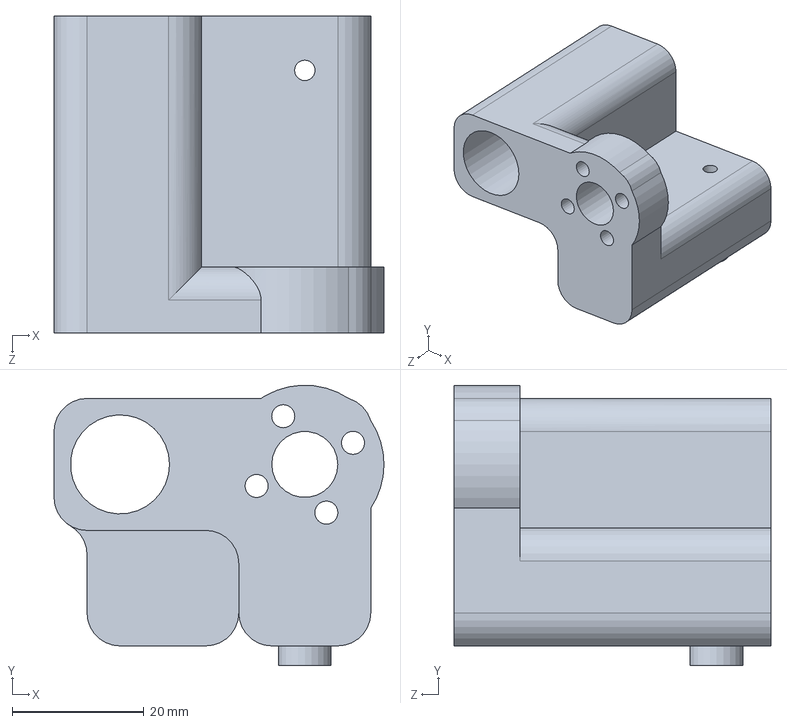
[picture p136: CAD file, 2021-01-11]
方案二/X固定右.SLDPRT
50.0 x 42.5 x 48.0 mm
