Blosslom1/FDM_i3_3Dprinter/方案一/STL/电源挂架BX2.STL

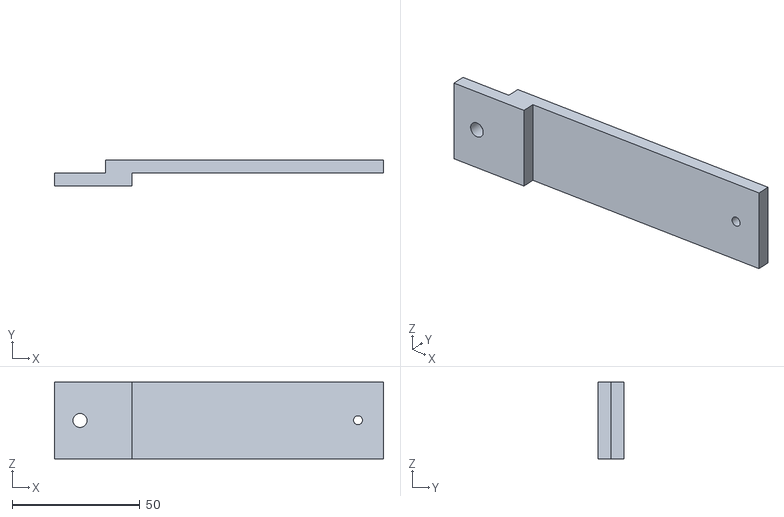
[picture p137: CAD file, 2021-01-11]
方案一/STL/电源挂架BX2.STL
129.0 x 10.0 x 30.0
