Blosslom1/FDM_i3_3Dprinter/方案一/舵机.SLDPRT

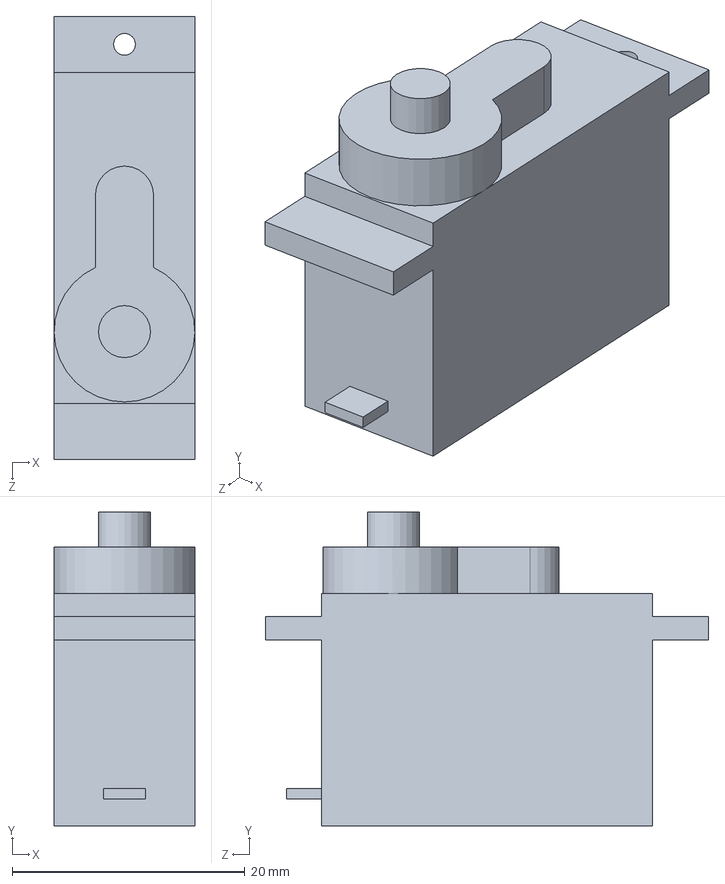
[picture p138: CAD file, 2021-01-11]
方案一/舵机.SLDPRT
12.1 x 27.0 x 38.1 mm
