Blosslom1/FDM_i3_3Dprinter/方案二/X型材250.SLDPRT

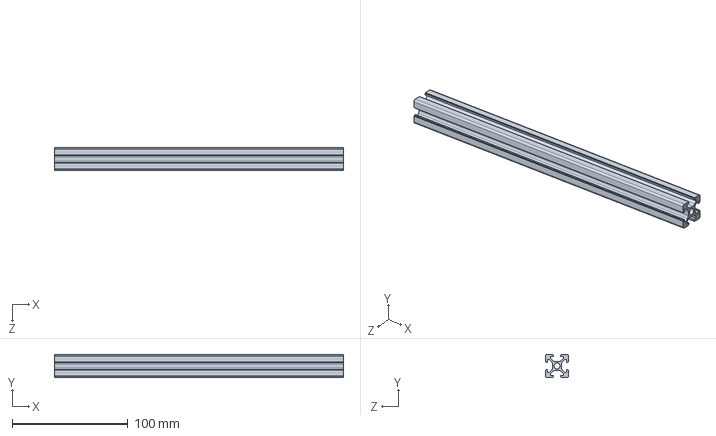
[picture p139: CAD file, 2021-01-11]
方案二/X型材250.SLDPRT
250.0 x 20.0 x 20.0 mm
