Blosslom1/FDM_i3_3Dprinter/方案一/STL/背板立柱X4.STL

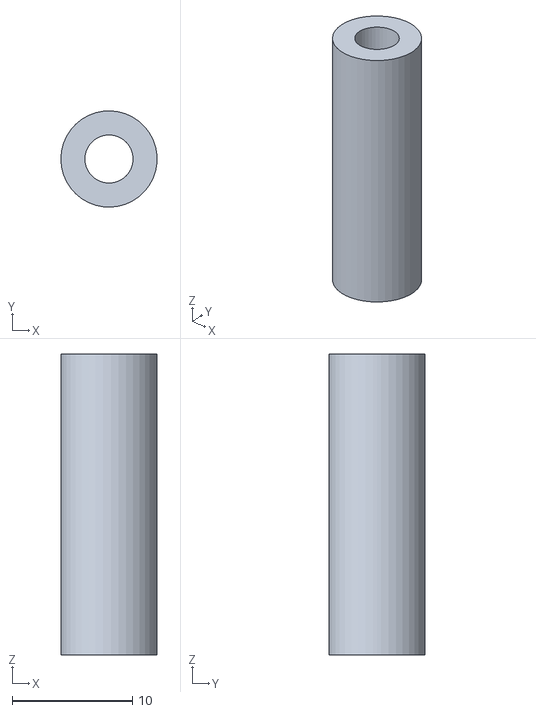
[picture p140: CAD file, 2021-01-11]
方案一/STL/背板立柱X4.STL
8.00 x 7.99 x 25.0
