Blosslom1/FDM_i3_3Dprinter/方案一/Y同步轮固定.SLDPRT

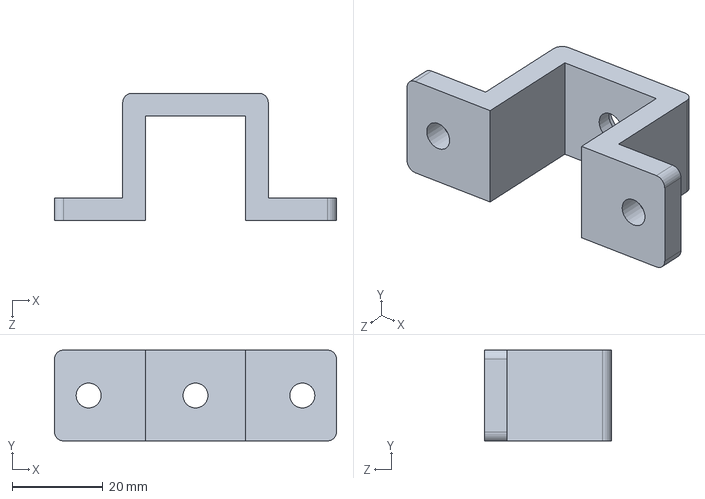
[picture p141: CAD file, 2021-01-11]
方案一/Y同步轮固定.SLDPRT
62.0 x 20.0 x 28.0 mm
