Blosslom1/FDM_i3_3Dprinter/方案二/X固定.SLDPRT

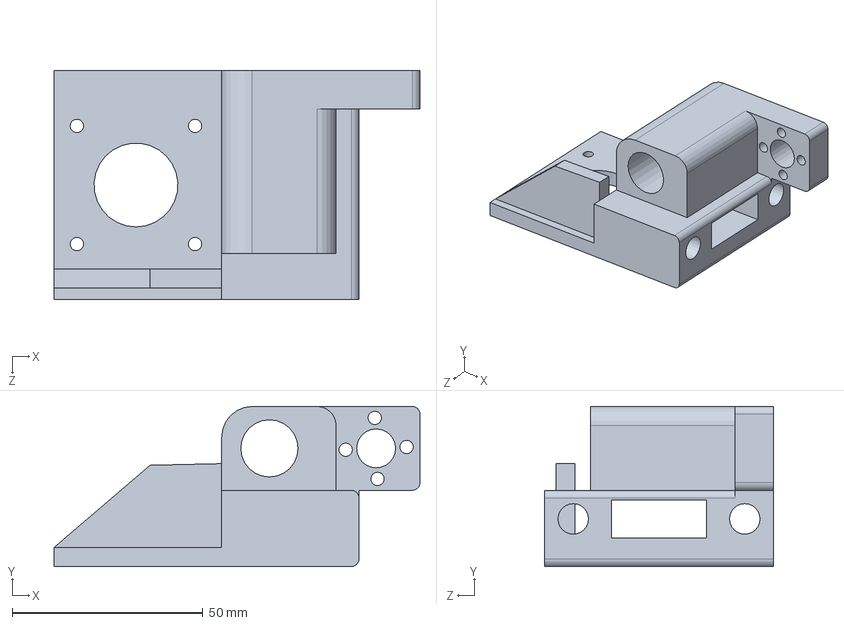
[picture p142: CAD file, 2021-01-11]
方案二/X固定.SLDPRT
96.0 x 42.0 x 60.0 mm
