Blosslom1/FDM_i3_3Dprinter/方案一/STL/Y光轴固定X4.STL

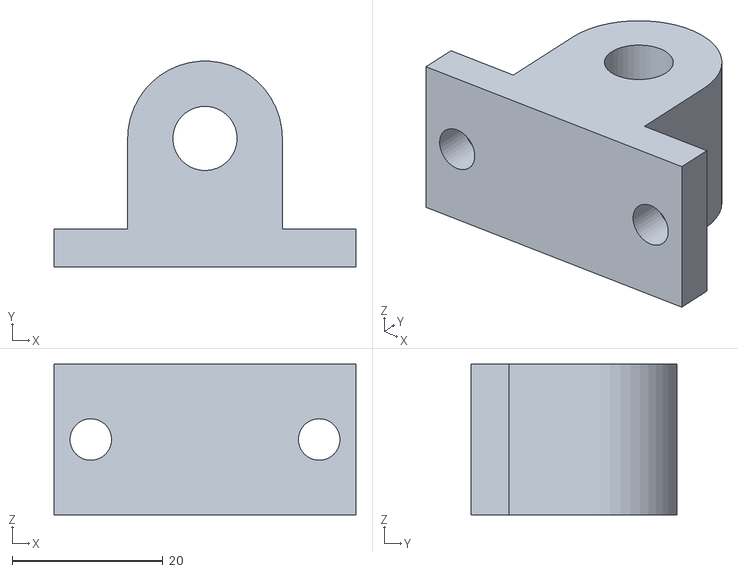
[picture p143: CAD file, 2021-01-11]
方案一/STL/Y光轴固定X4.STL
40.0 x 27.2 x 20.0
