Blosslom1/FDM_i3_3Dprinter/方案一/按钮绿.SLDPRT

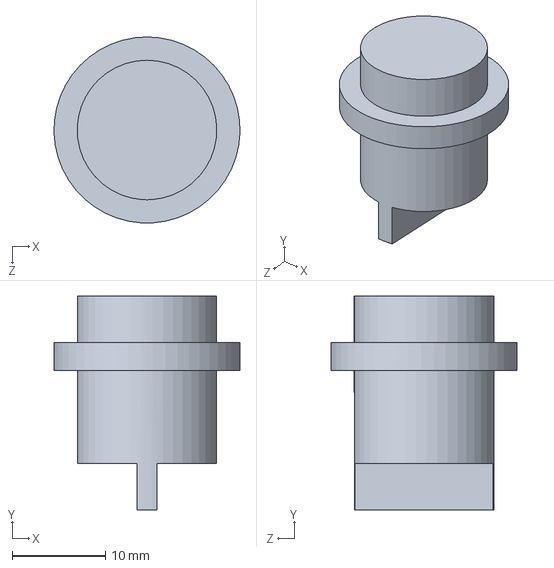
[picture p144: CAD file, 2021-01-11]
方案一/按钮绿.SLDPRT
20.0 x 23.0 x 20.0 mm
