Blosslom1/FDM_i3_3Dprinter/方案一/ArduinoMega.SLDPRT

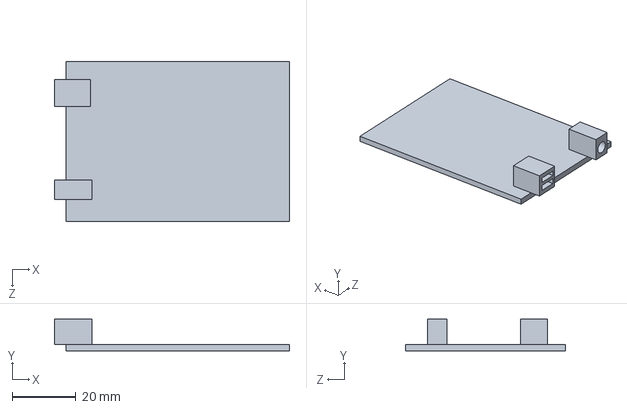
[picture p145: CAD file, 2021-01-11]
方案一/ArduinoMega.SLDPRT
73.6 x 10.0 x 50.0 mm
