Blosslom1/FDM_i3_3Dprinter/方案一/STL/X限位固定X2.STL

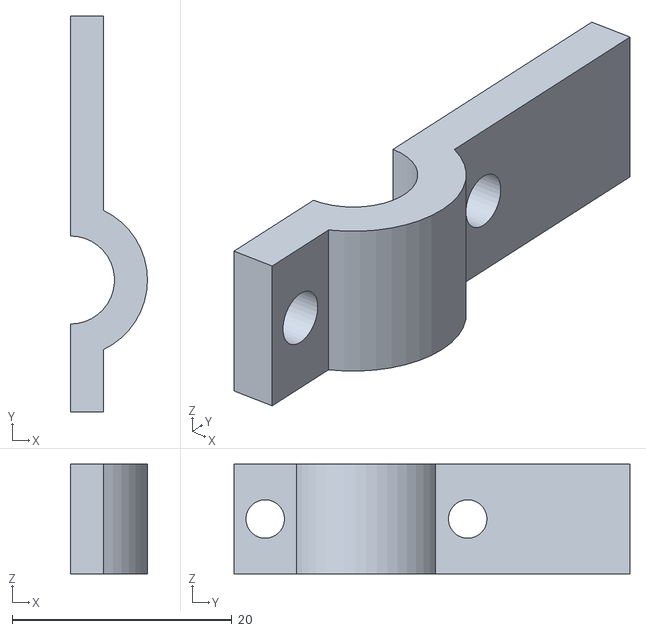
[picture p146: CAD file, 2021-01-11]
方案一/STL/X限位固定X2.STL
7.00 x 36.0 x 10.0
