Blosslom1/FDM_i3_3Dprinter/方案一/MK8压杆.SLDPRT

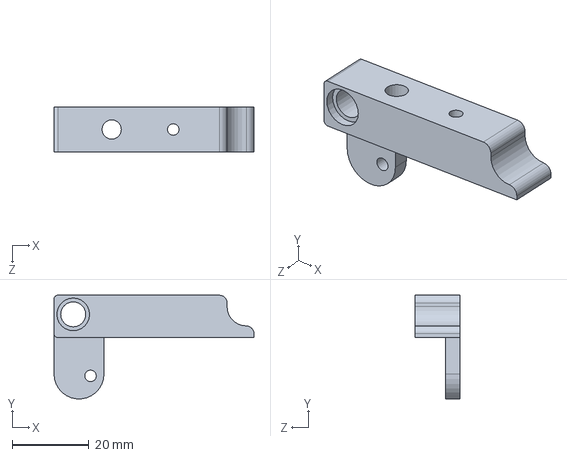
[picture p147: CAD file, 2021-01-11]
方案一/MK8压杆.SLDPRT
52.0 x 27.0 x 11.8 mm
