Blosslom1/FDM_i3_3Dprinter/方案一/STL/热床底板固定X4.STL

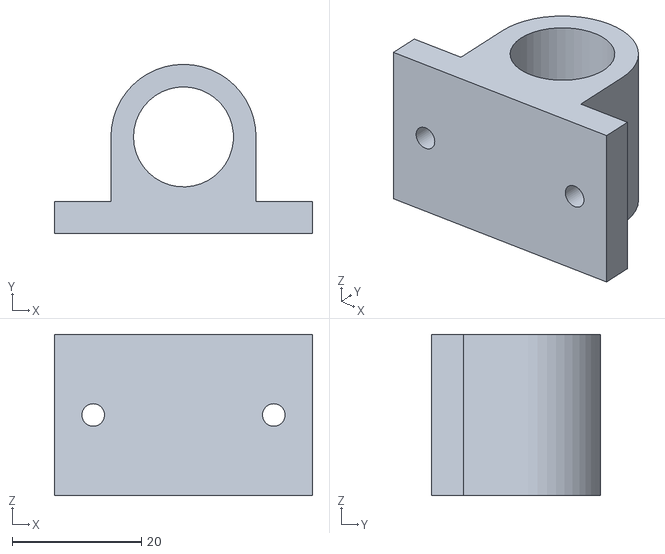
[picture p148: CAD file, 2021-01-11]
方案一/STL/热床底板固定X4.STL
40.0 x 26.2 x 25.0
