Blosslom1/FDM_i3_3Dprinter/方案二/M3螺丝8m.SLDPRT

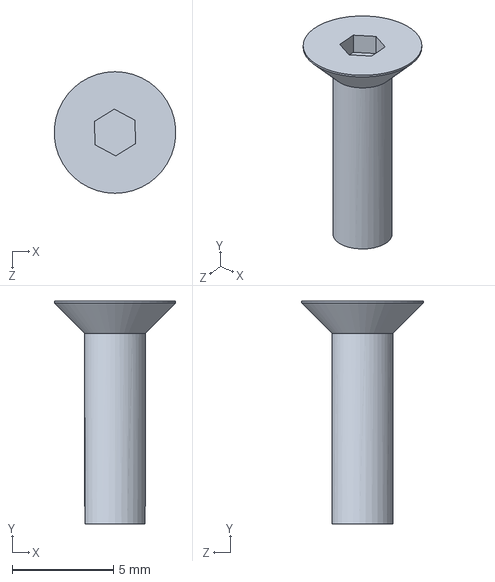
[picture p149: CAD file, 2021-01-11]
方案二/M3螺丝8m.SLDPRT
5.98 x 11.0 x 6.00 mm
