Blosslom1/FDM_i3_3Dprinter/方案一/STL/X同步带固定.STL

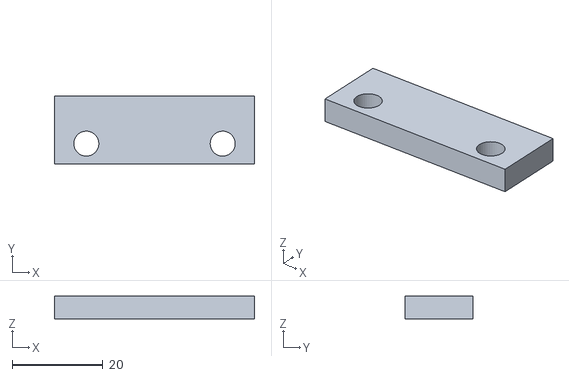
[picture p150: CAD file, 2021-01-11]
方案一/STL/X同步带固定.STL
44.0 x 15.0 x 5.00
