Blosslom1/FDM_i3_3Dprinter/方案一/调平拨杆.SLDPRT

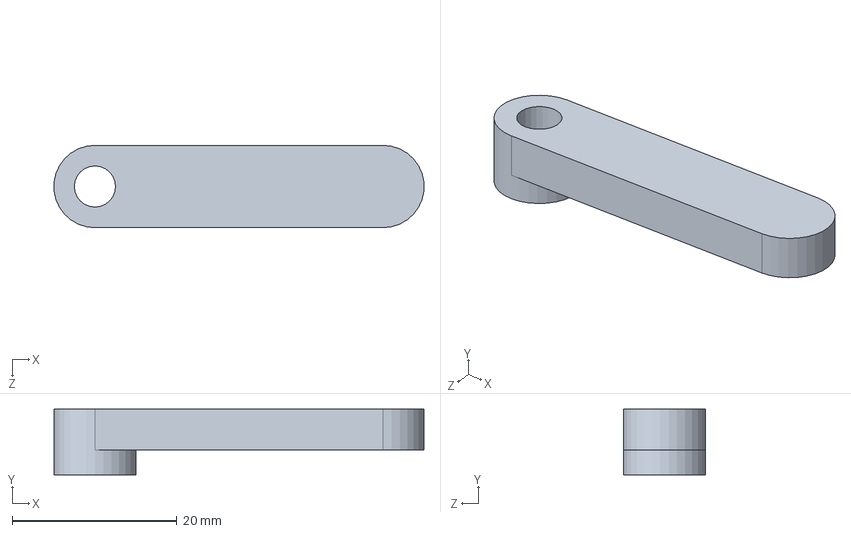
[picture p151: CAD file, 2021-01-11]
方案一/调平拨杆.SLDPRT
44.9 x 8.00 x 10.0 mm
