Blosslom1/FDM_i3_3Dprinter/方案二/Z型材320.SLDPRT

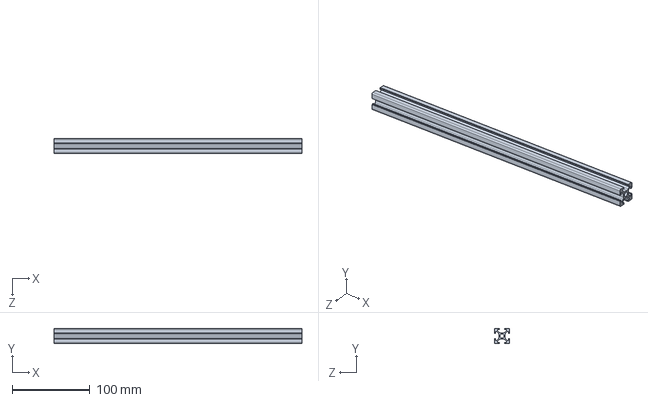
[picture p152: CAD file, 2021-01-11]
方案二/Z型材320.SLDPRT
320.0 x 20.0 x 20.0 mm
