Blosslom1/FDM_i3_3Dprinter/方案一/MK8底板.SLDPRT

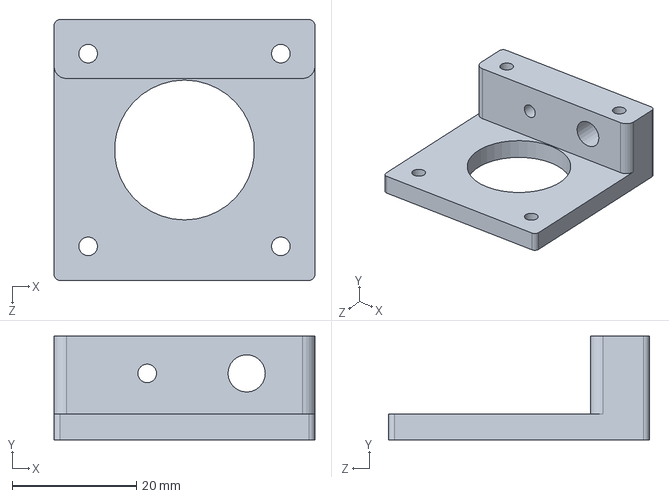
[picture p153: CAD file, 2021-01-11]
方案一/MK8底板.SLDPRT
42.0 x 16.7 x 42.0 mm
