Blosslom1/FDM_i3_3Dprinter/方案二/喉管.SLDPRT

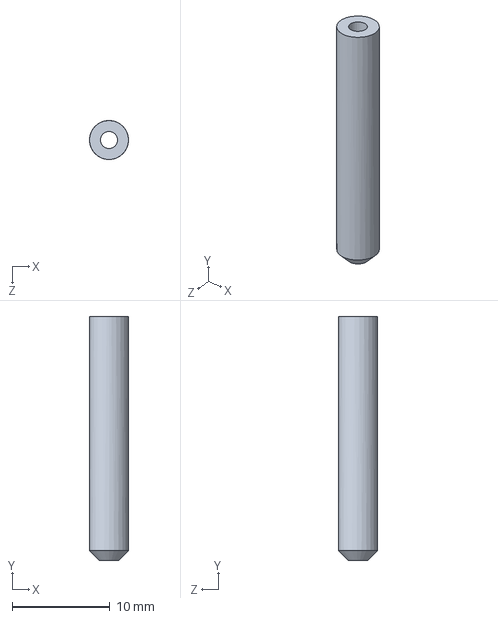
[picture p154: CAD file, 2021-01-11]
方案二/喉管.SLDPRT
3.99 x 25.0 x 4.00 mm
