Blosslom1/FDM_i3_3Dprinter/方案一/背板立柱.SLDPRT

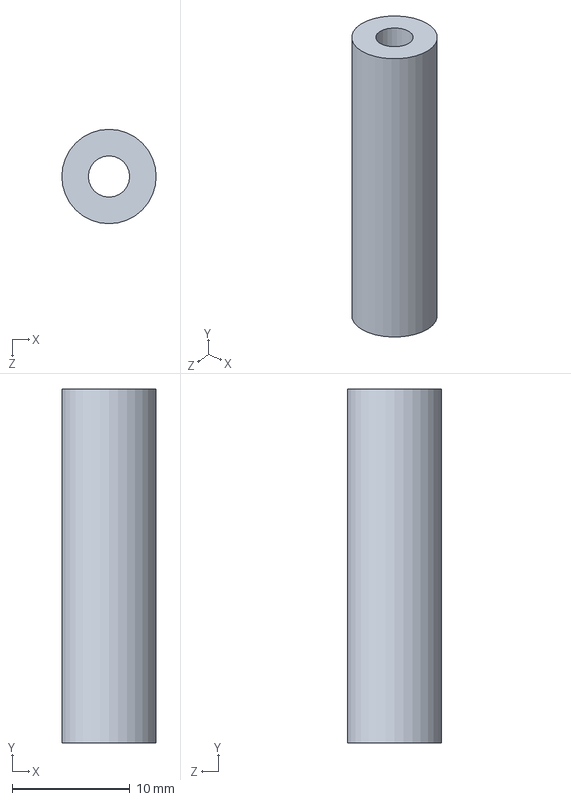
[picture p155: CAD file, 2021-01-11]
方案一/背板立柱.SLDPRT
8.00 x 30.0 x 8.00 mm
