Blosslom1/FDM_i3_3Dprinter/方案一/z滑块右侧.SLDPRT

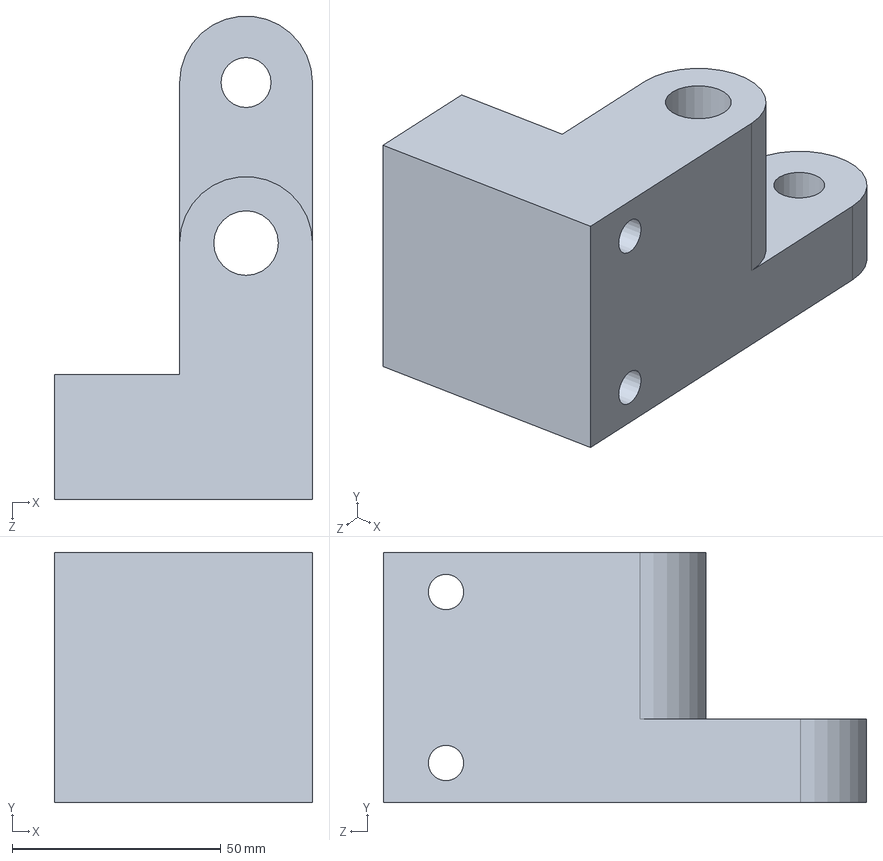
[picture p156: CAD file, 2021-01-11]
方案一/z滑块右侧.SLDPRT
61.9 x 60.0 x 115.8 mm
