Blosslom1/FDM_i3_3Dprinter/方案一/MK8散热片.SLDPRT

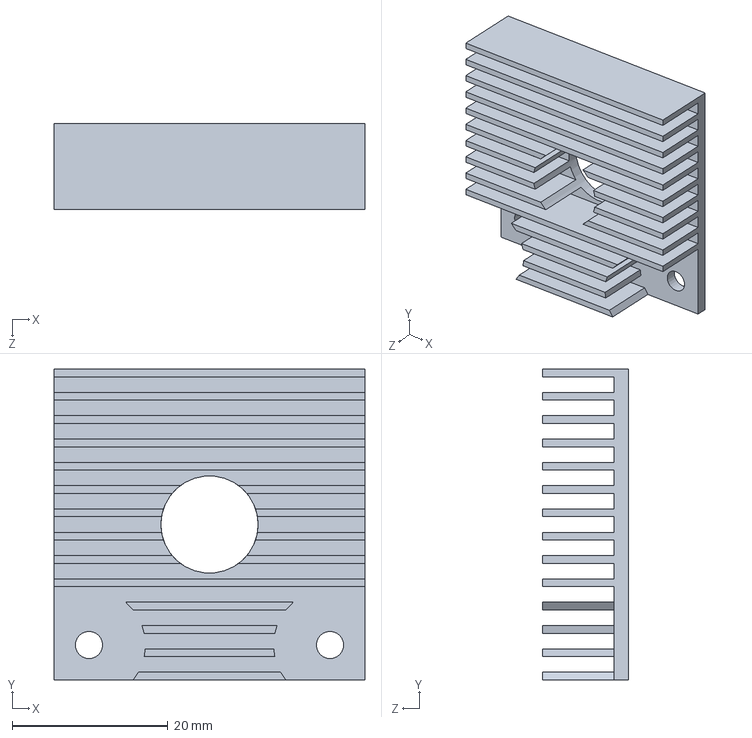
[picture p157: CAD file, 2021-01-11]
方案一/MK8散热片.SLDPRT
40.0 x 40.0 x 11.0 mm
