Blosslom1/FDM_i3_3Dprinter/方案一/电源挂架A.SLDPRT

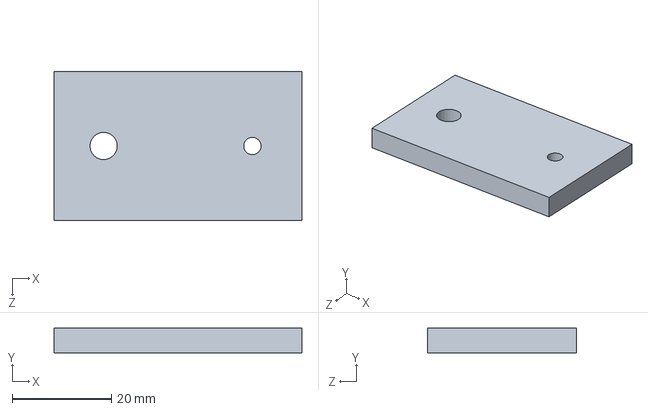
[picture p158: CAD file, 2021-01-11]
方案一/电源挂架A.SLDPRT
50.0 x 5.00 x 30.0 mm
