Blosslom1/FDM_i3_3Dprinter/方案二/横梁型材350.SLDPRT

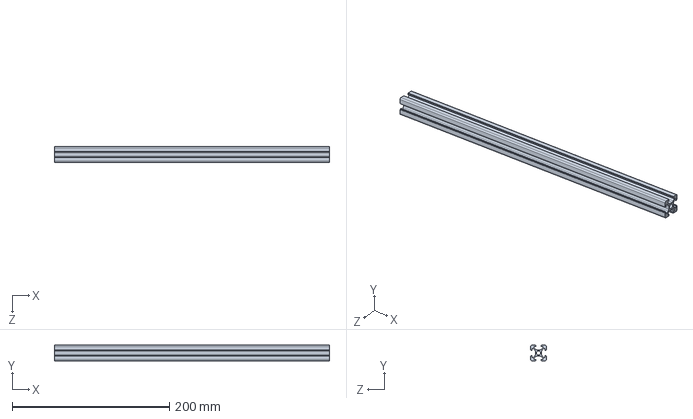
[picture p159: CAD file, 2021-01-11]
方案二/横梁型材350.SLDPRT
350.0 x 20.0 x 20.0 mm
