Blosslom1/FDM_i3_3Dprinter/方案一/铝加热块.SLDPRT

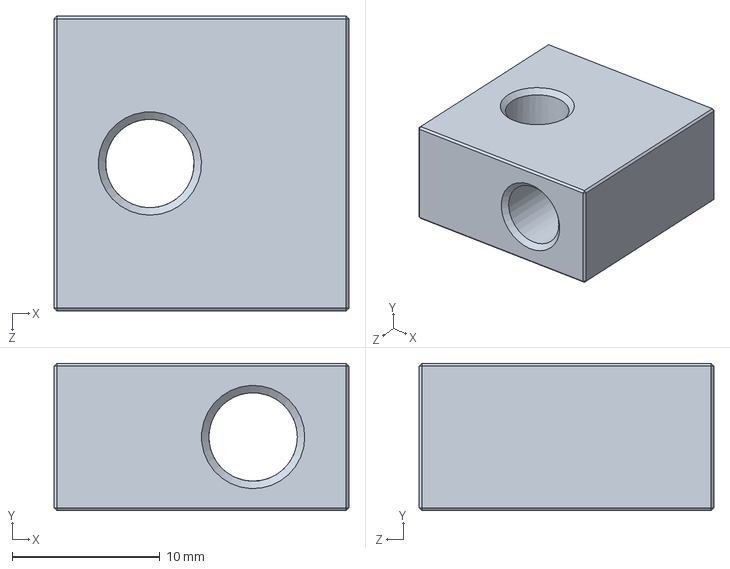
[picture p160: CAD file, 2021-01-11]
方案一/铝加热块.SLDPRT
20.0 x 10.0 x 20.0 mm
