Blosslom1/FDM_i3_3Dprinter/方案二/Y型材390.SLDPRT

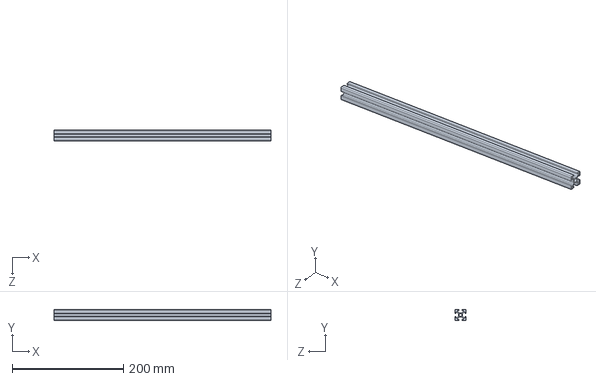
[picture p161: CAD file, 2021-01-11]
方案二/Y型材390.SLDPRT
390.0 x 20.0 x 20.0 mm
