Blosslom1/FDM_i3_3Dprinter/方案一/X限位固定.SLDPRT

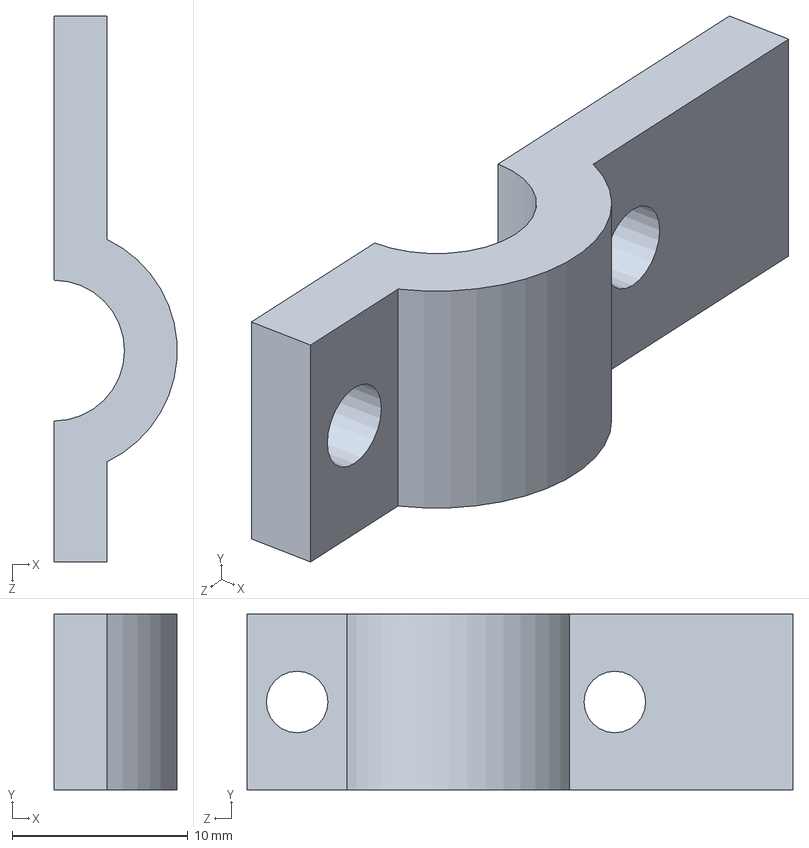
[picture p162: CAD file, 2021-01-11]
方案一/X限位固定.SLDPRT
6.98 x 10.0 x 31.0 mm
