Blosslom1/FDM_i3_3Dprinter/方案一/M3光轴.SLDPRT

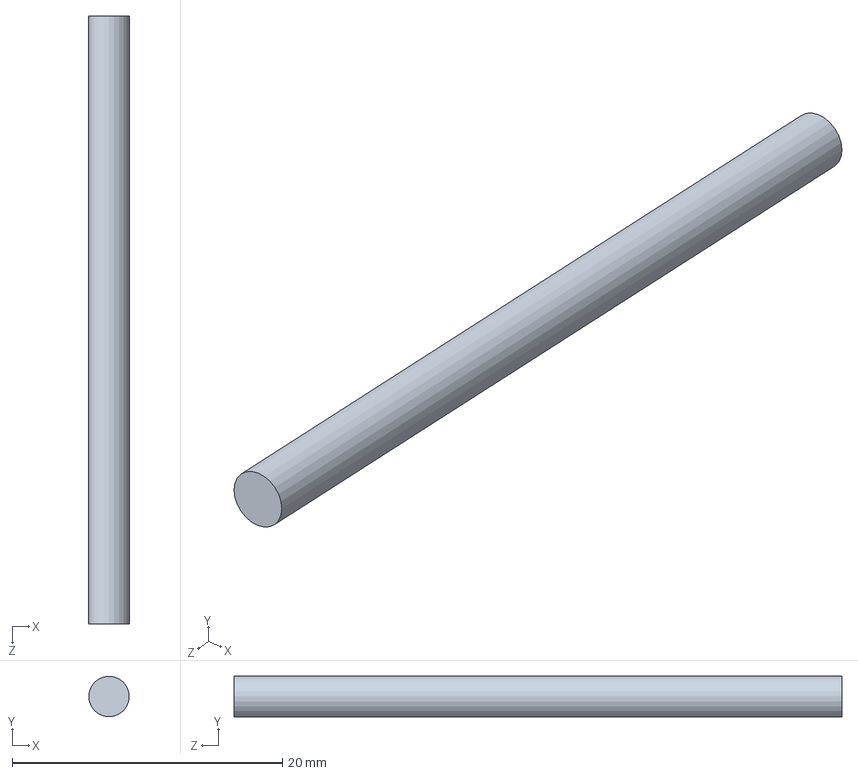
[picture p163: CAD file, 2021-01-11]
方案一/M3光轴.SLDPRT
3.00 x 3.00 x 45.0 mm
