Blosslom1/FDM_i3_3Dprinter/方案二/Y轴步进电机固定.SLDPRT

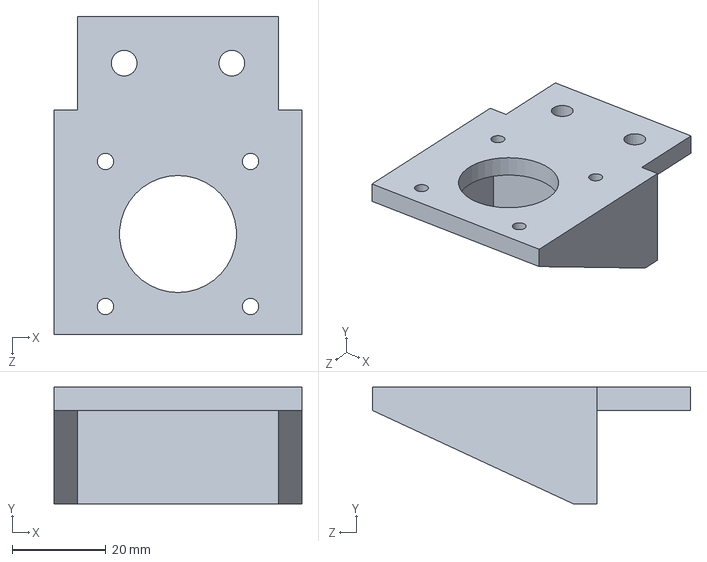
[picture p164: CAD file, 2021-01-11]
方案二/Y轴步进电机固定.SLDPRT
53.0 x 25.0 x 68.0 mm
