Blosslom1/FDM_i3_3Dprinter/方案一/热床底板固定.SLDPRT

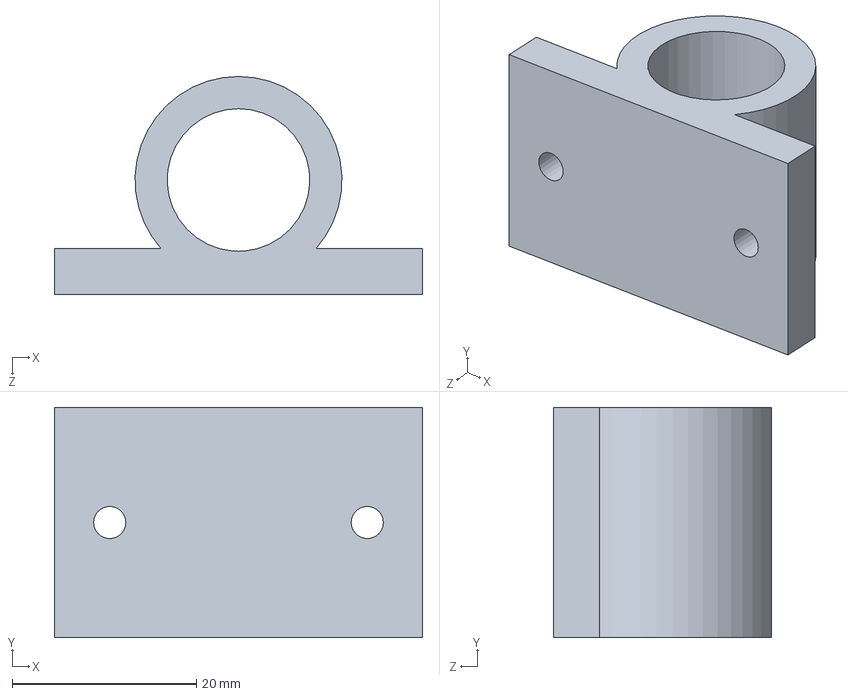
[picture p165: CAD file, 2021-01-11]
方案一/热床底板固定.SLDPRT
40.0 x 25.0 x 23.7 mm
