Blosslom1/FDM_i3_3Dprinter/方案一/调平底板.SLDPRT

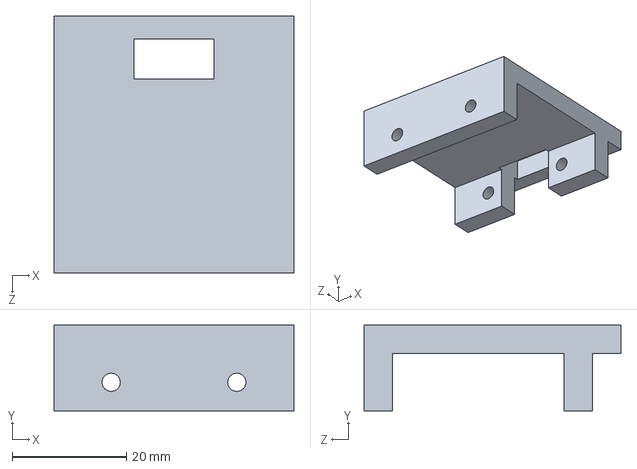
[picture p166: CAD file, 2021-01-11]
方案一/调平底板.SLDPRT
42.0 x 15.0 x 45.0 mm
