Blosslom1/FDM_i3_3Dprinter/方案一/电源挂架B.SLDPRT

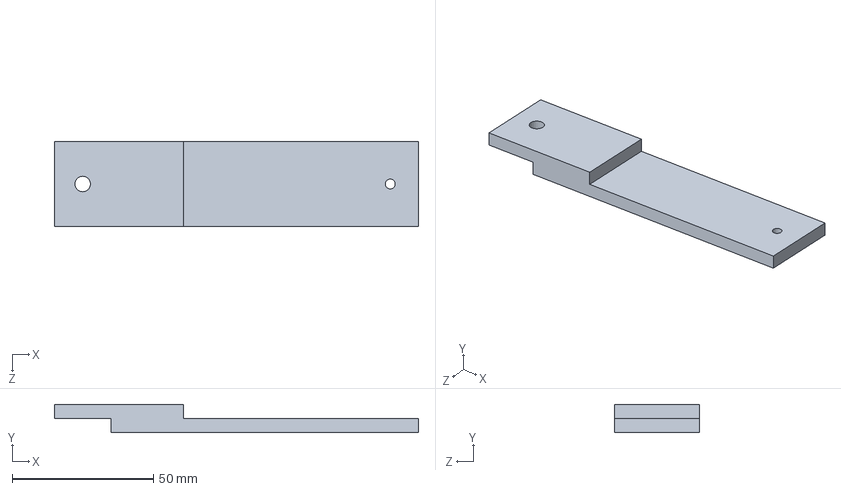
[picture p167: CAD file, 2021-01-11]
方案一/电源挂架B.SLDPRT
129.0 x 10.0 x 30.0 mm
