Blosslom1/FDM_i3_3Dprinter/方案二/惰轮.SLDPRT

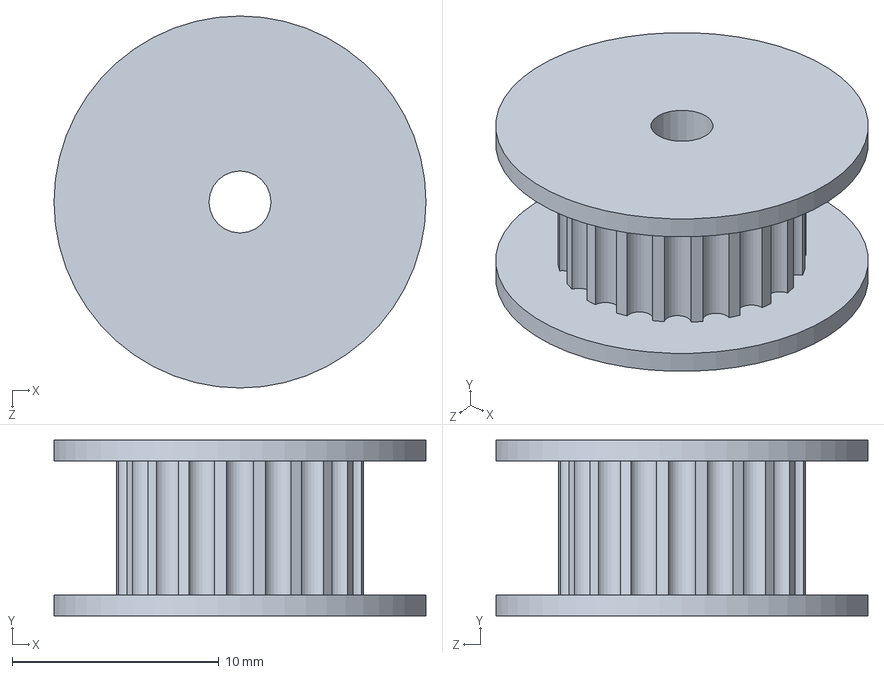
[picture p168: CAD file, 2021-01-11]
方案二/惰轮.SLDPRT
18.0 x 8.50 x 18.0 mm
