Blosslom1/FDM_i3_3Dprinter/方案一/背板.SLDPRT

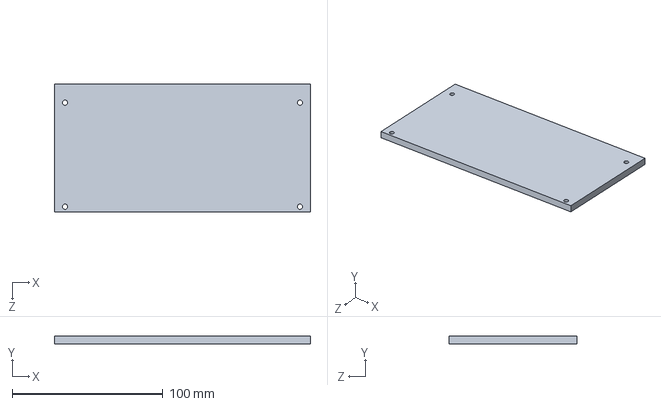
[picture p169: CAD file, 2021-01-11]
方案一/背板.SLDPRT
170.0 x 5.00 x 85.0 mm
