Blosslom1/FDM_i3_3Dprinter/方案二/熔融喷头固定.SLDPRT

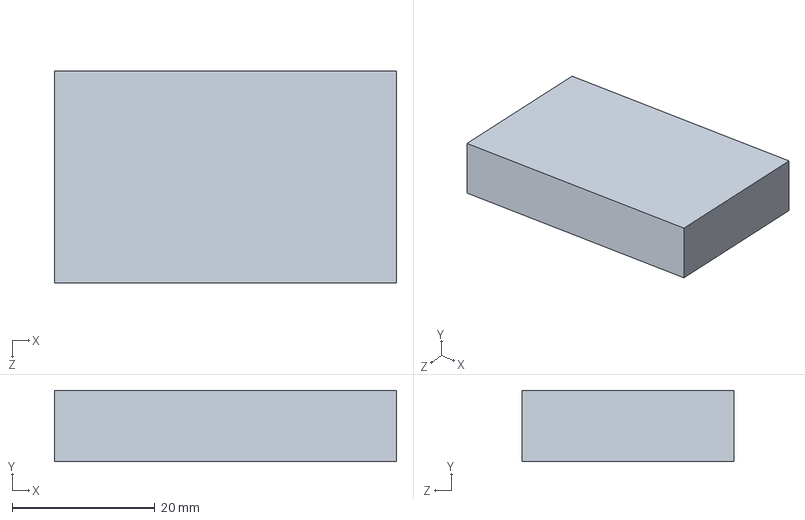
[picture p170: CAD file, 2021-01-11]
方案二/熔融喷头固定.SLDPRT
48.0 x 10.0 x 29.8 mm
