Blosslom1/FDM_i3_3Dprinter/方案一/探针.SLDPRT

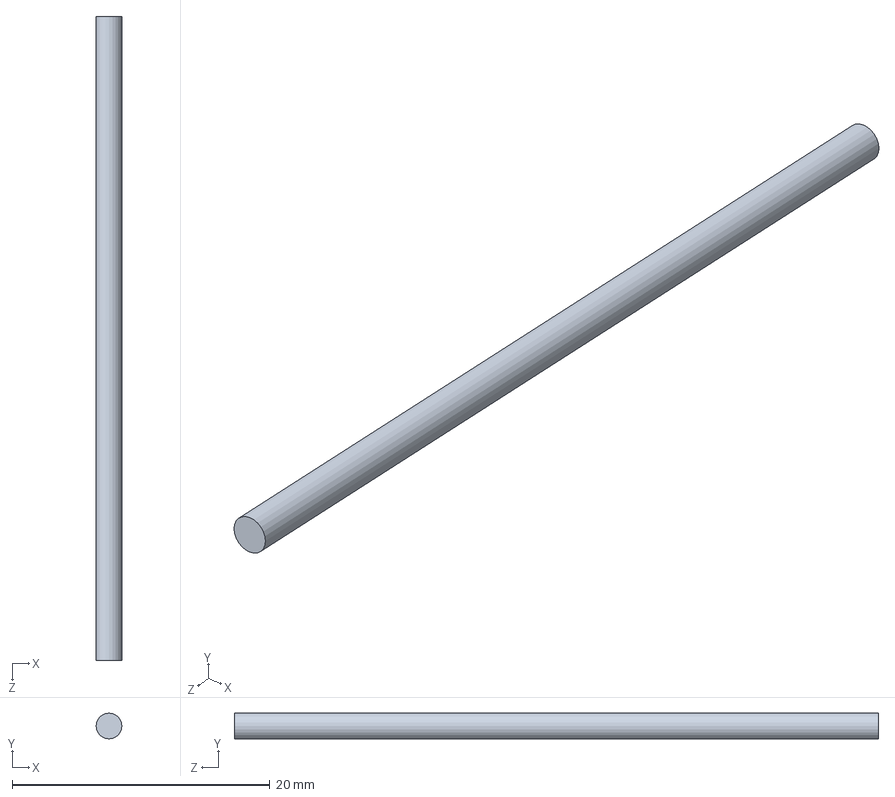
[picture p171: CAD file, 2021-01-11]
方案一/探针.SLDPRT
2.00 x 2.00 x 50.0 mm
