Blosslom1/FDM_i3_3Dprinter/方案一/z丝杆固定.SLDPRT

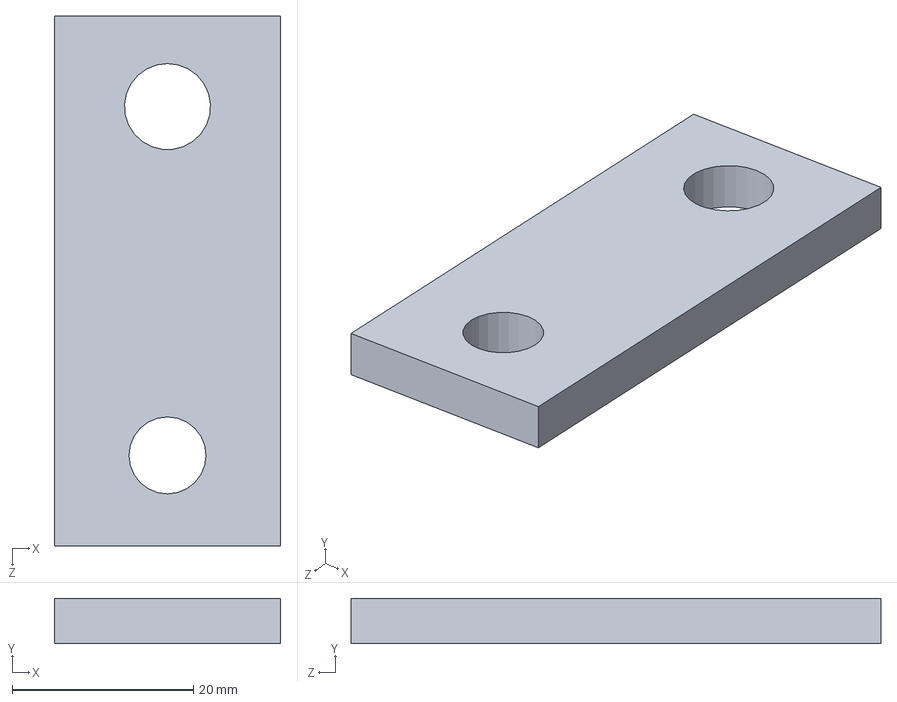
[picture p172: CAD file, 2021-01-11]
方案一/z丝杆固定.SLDPRT
25.0 x 5.00 x 58.5 mm
