Blosslom1/FDM_i3_3Dprinter/方案一/调平滑块.SLDPRT

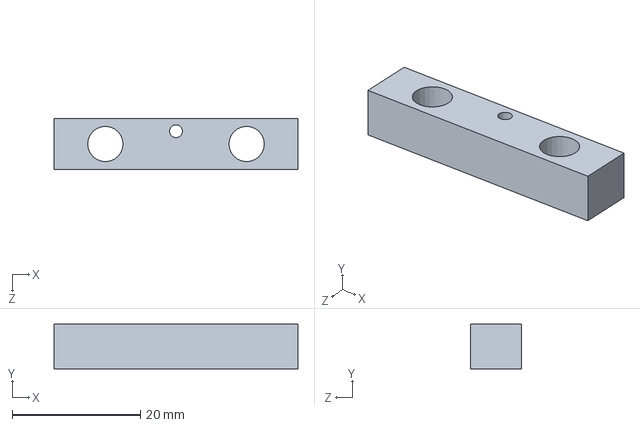
[picture p173: CAD file, 2021-01-11]
方案一/调平滑块.SLDPRT
38.0 x 7.00 x 8.00 mm
