Blosslom1/FDM_i3_3Dprinter/方案二/气动插头.SLDPRT

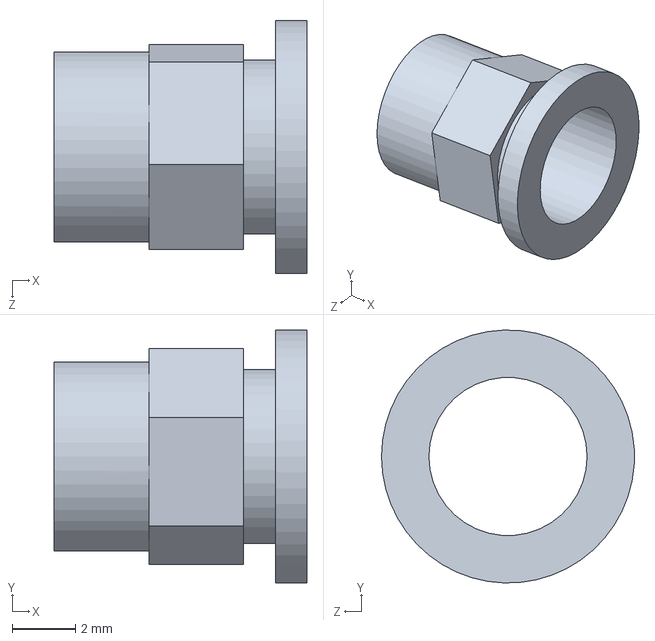
[picture p174: CAD file, 2021-01-11]
方案二/气动插头.SLDPRT
8.00 x 8.00 x 8.00 mm
