Blosslom1/FDM_i3_3Dprinter/方案一/光耦.SLDPRT

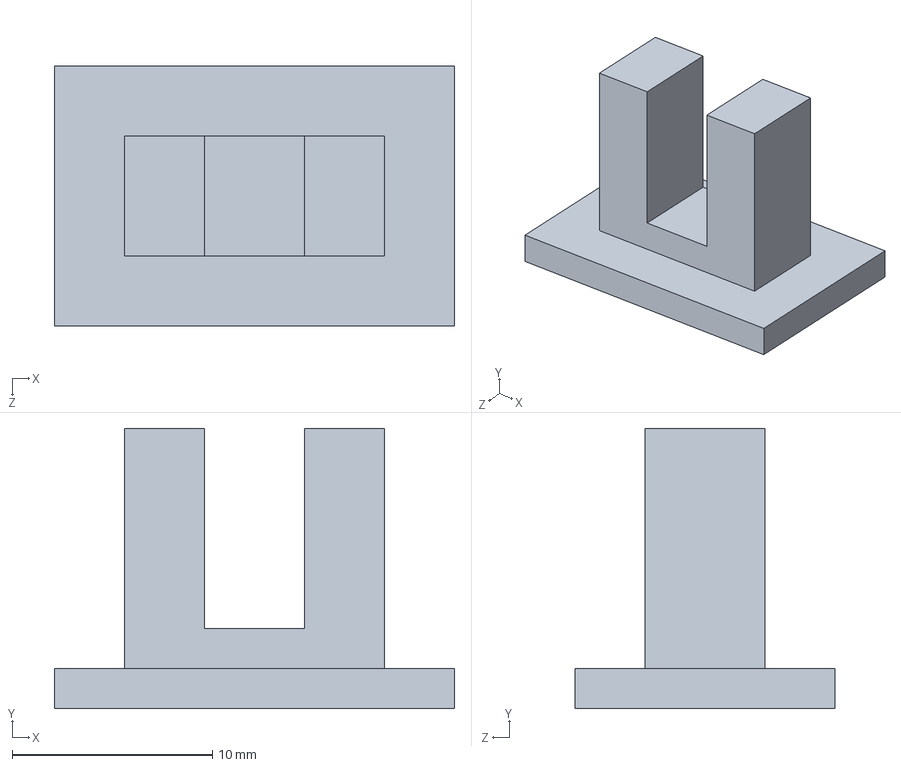
[picture p175: CAD file, 2021-01-11]
方案一/光耦.SLDPRT
20.0 x 14.0 x 13.0 mm
