Blosslom1/FDM_i3_3Dprinter/方案二/底座.SLDPRT

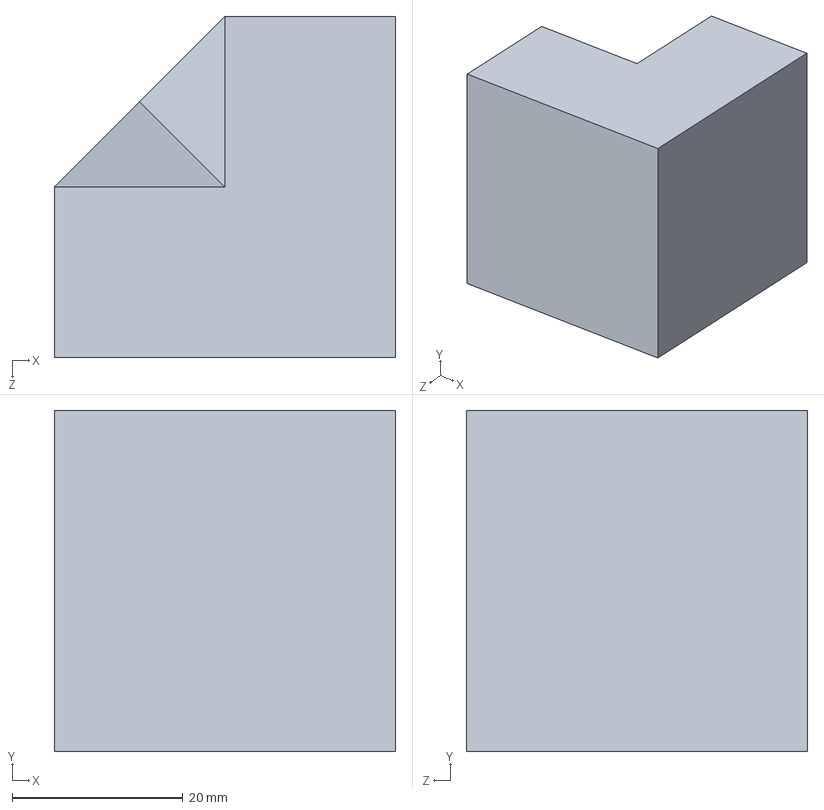
[picture p176: CAD file, 2021-01-11]
方案二/底座.SLDPRT
40.0 x 40.0 x 40.0 mm
