Blosslom1/FDM_i3_3Dprinter/方案一/MR63ZZ.SLDPRT

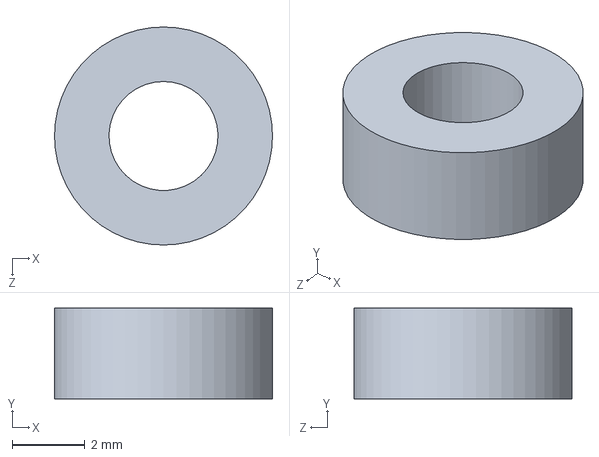
[picture p177: CAD file, 2021-01-11]
方案一/MR63ZZ.SLDPRT
6.00 x 2.50 x 6.00 mm
