Blosslom1/FDM_i3_3Dprinter/方案二/Y光轴390.SLDPRT

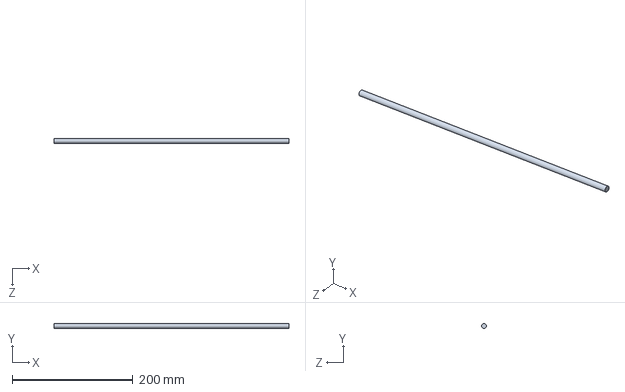
[picture p178: CAD file, 2021-01-11]
方案二/Y光轴390.SLDPRT
390.0 x 8.00 x 8.00 mm
