Blosslom1/FDM_i3_3Dprinter/方案一/继电器.SLDPRT

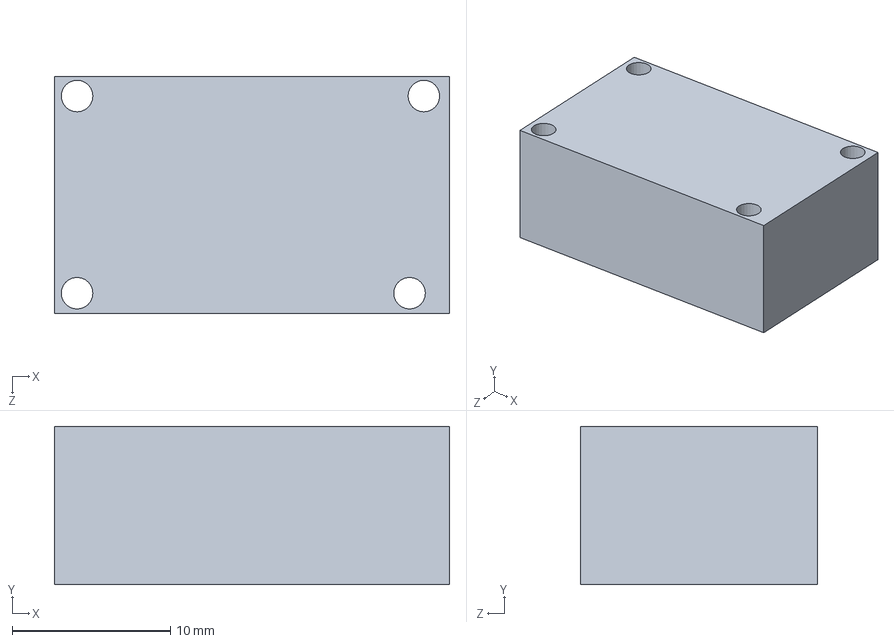
[picture p179: CAD file, 2021-01-11]
方案一/继电器.SLDPRT
25.0 x 10.0 x 15.0 mm
