Blosslom1/FDM_i3_3Dprinter/方案一/旋转编码器.SLDPRT

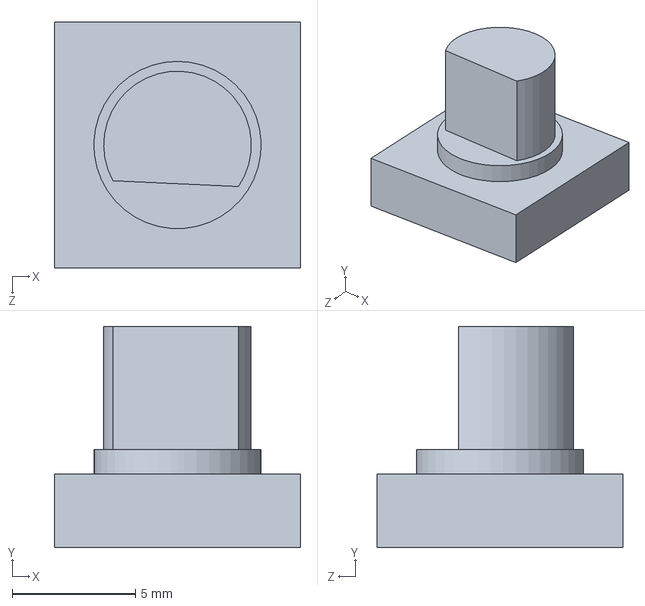
[picture p180: CAD file, 2021-01-11]
方案一/旋转编码器.SLDPRT
10.0 x 9.00 x 10.0 mm
