Blosslom1/FDM_i3_3Dprinter/方案二/Z轴固定.SLDPRT

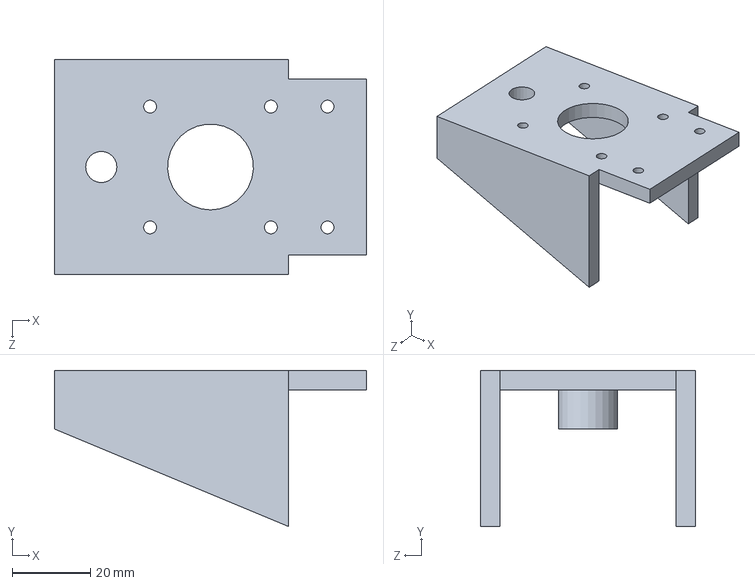
[picture p181: CAD file, 2021-01-11]
方案二/Z轴固定.SLDPRT
80.0 x 40.0 x 55.0 mm
