Blosslom1/FDM_i3_3Dprinter/方案一/读卡器.SLDPRT

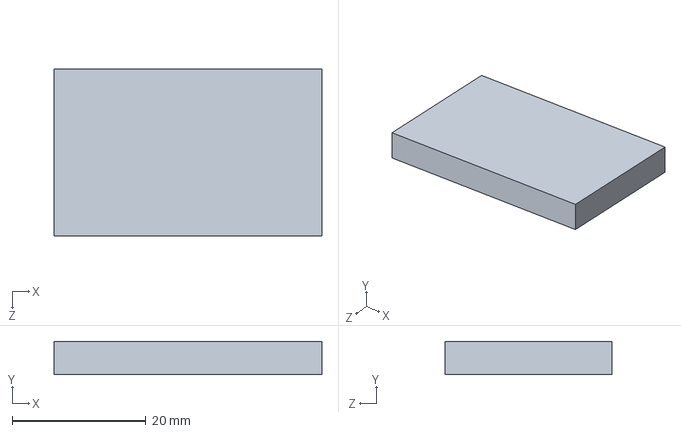
[picture p182: CAD file, 2021-01-11]
方案一/读卡器.SLDPRT
40.0 x 5.00 x 25.0 mm
