Blosslom1/FDM_i3_3Dprinter/方案二/电源.SLDPRT

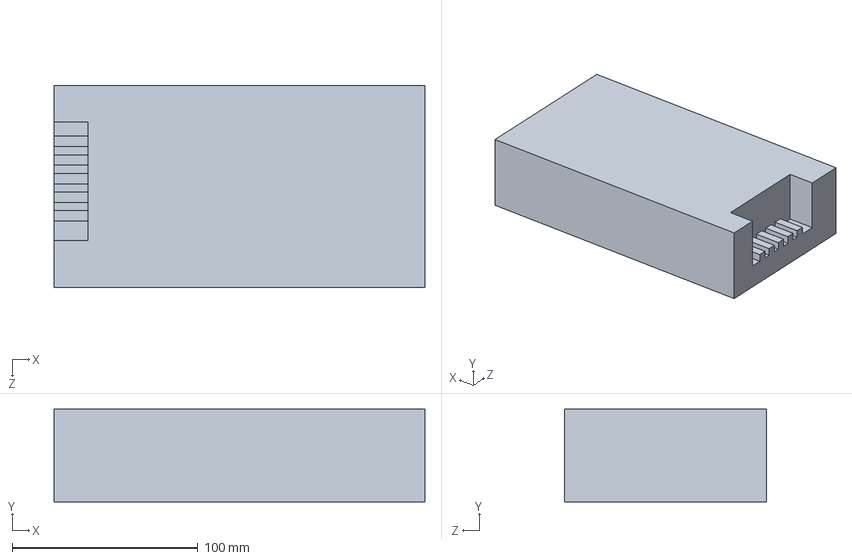
[picture p183: CAD file, 2021-01-11]
方案二/电源.SLDPRT
200.0 x 50.0 x 109.0 mm
