Blosslom1/FDM_i3_3Dprinter/方案二/电源支座.SLDPRT

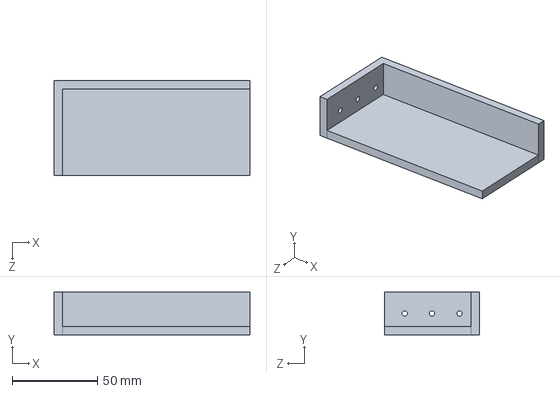
[picture p184: CAD file, 2021-01-11]
方案二/电源支座.SLDPRT
115.0 x 25.0 x 56.0 mm
