Blosslom1/FDM_i3_3Dprinter/(list of files, cad)

Other CAD files:
方案一/工程图/Y轴步进电机固定.DWG
方案一/z电机支架B.SLDPRT
方案一/工程图/调平拨杆.DWG
方案二/.DWG
方案一/工程图/MK8散热片.DWG
模型/主板盒/主板盒/files/dasaki_ramps_enclosure_cover_v2.stl
方案一/工程图/型材.DWG
方案二/Z光轴350.SLDPRT
模型/主板盒/主板盒/files/dasaki_ramps_enclosure_base.stl
方案一/工程图/电源.DWG
方案一/支架/X光轴320.SLDPRT
模型/主板盒/主板盒/files/dasaki_ramps_enclosure_cover_v2_dual_40mm_fan.stl
方案一/工程图/喉管.DWG
方案一/z电机支架.SLDPRT
方案一/工程图/全部工程图.dwg
方案一/工程图/42步进电机.DWG
方案一/工程图/z电机支架.DWG
方案一/支架/铝型材.SLDPRT
方案一/工程图/继电器.DWG
方案一/工程图/读卡器.DWG
方案一/工程图/调平遮挡.DWG
方案一/工程图/X限位固定.DWG
方案一/工程图/喷口.DWG
方案一/工程图/背板.DWG
方案一/工程图/z滑块左侧.DWG
方案一/工程图/螺丝零件.DWG
方案一/工程图/同步轮.DWG
方案二/热床平台.SLDPRT
方案二/角码.SLDPRT
方案二/挤出机支架.SLDPRT
方案一/z滑块左侧.SLDPRT
方案二/Y同步轮固定.SLDPRT
方案二/X光轴320.SLDPRT
方案一/挤出机支架.SLDPRT
方案一/按钮红.SLDPRT
方案二/Y光轴固定.SLDPRT
方案一/12864显示屏.SLDPRT
方案一/STL/Y同步轮固定.STL
方案一/STL/Z电机支架B.STL
方案一/STL/挤出机支架.STL
方案一/STL/控制面板.STL
方案一/STL/背板.STL
方案一/STL/调平底板.STL
方案一/STL/调平拨杆.STL
方案一/STL/调平滑块.STL
方案一/工程图/12864显示屏.DWG
方案二/X固定.SLDDRW
方案二/X固定右.STL
模型/主板盒/主板盒/files/dasaki_ramps_enclosure.skp
