Blosslom1/FDM_i3_3Dprinter/方案一/工程图/pdf图纸/全部工程图-模型2.pdf

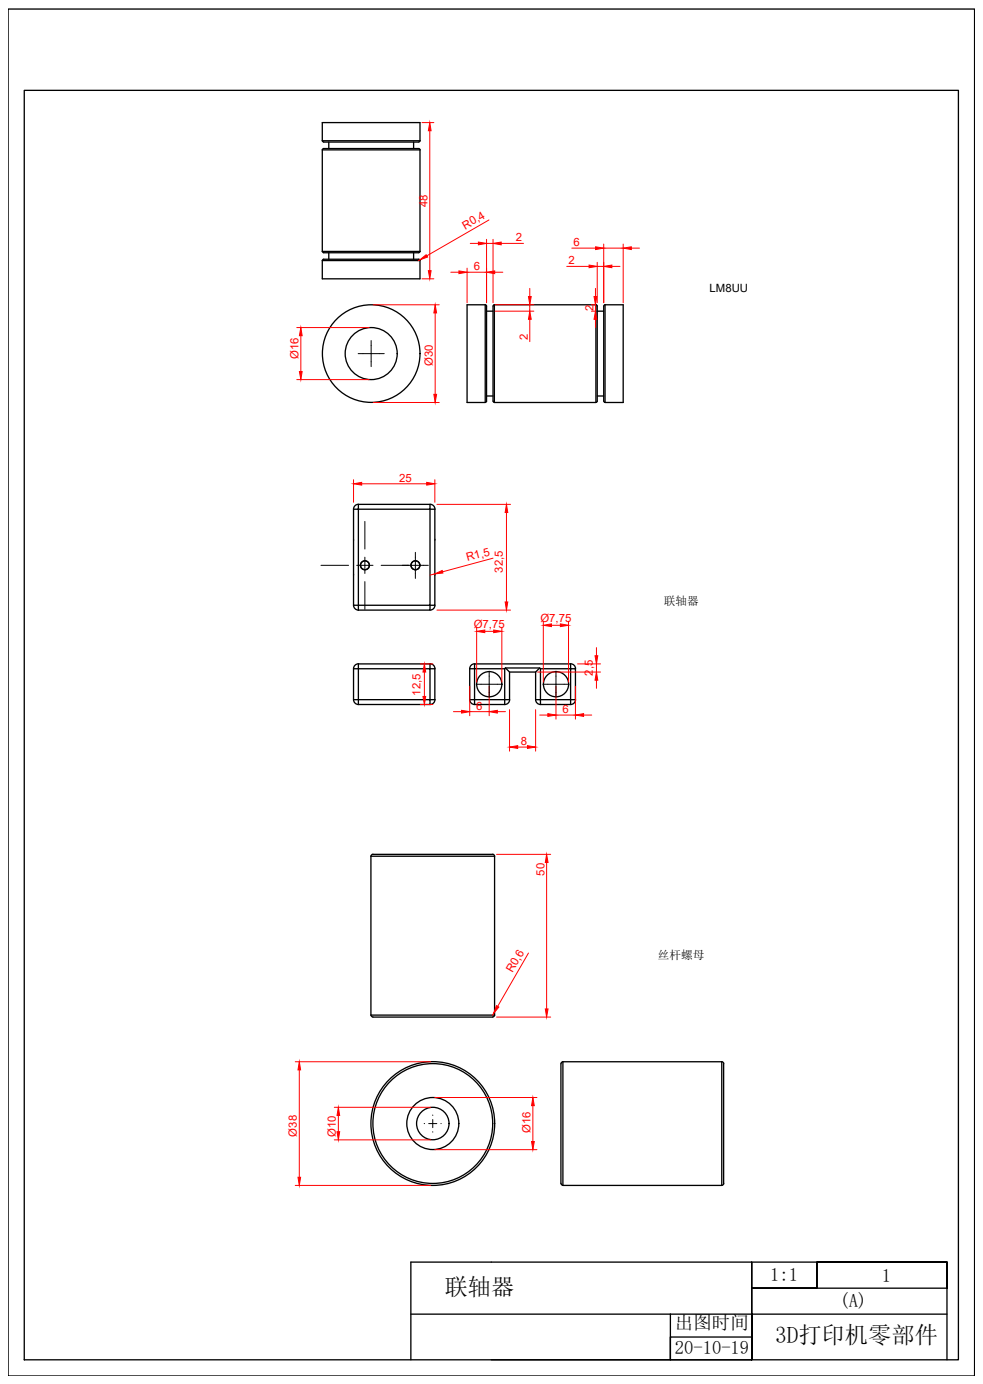
[picture p186: page 1]
3D打印机零部件 出图时间 12,5
